Rhoban/microban/tools/motor_ids_assets/labels.png

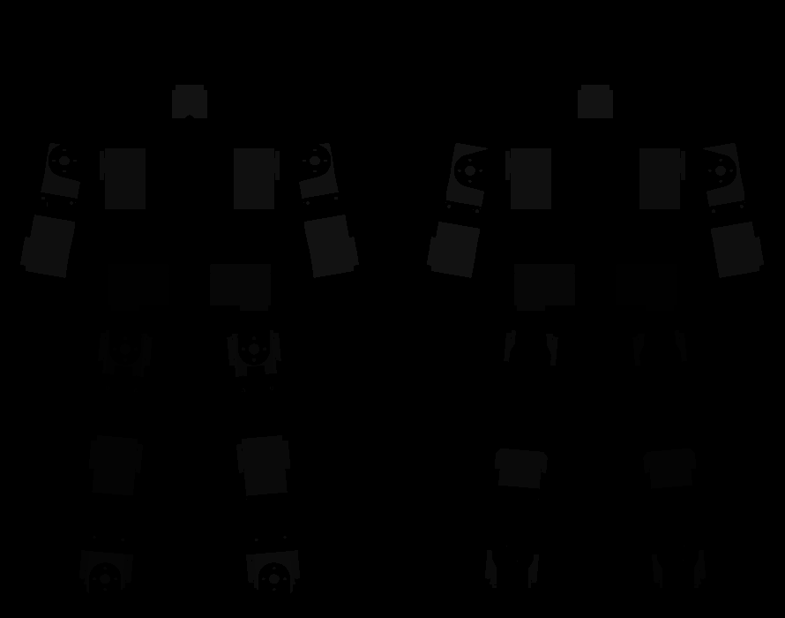
tools/motor_ids_assets/labels.png
