Rhoban/microban/tools/motor_ids_assets/views.png

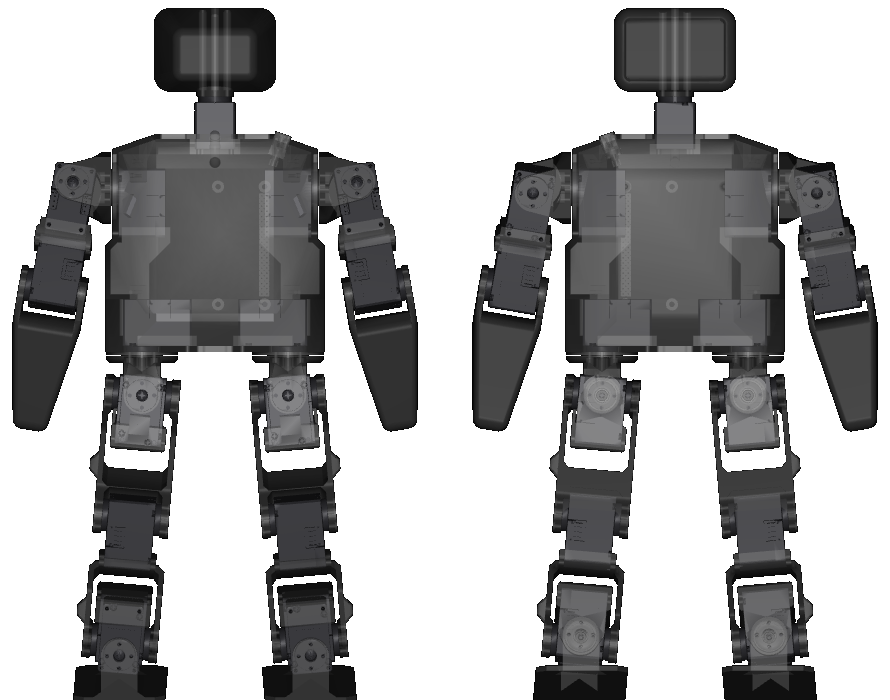
tools/motor_ids_assets/views.png
