Rhoban/microban/docs/bom.md

# Bill of Materials (BOM)

Here is a detailed Bill of Materials (BOM) for the project, including links to purchase each component and their approximate prices. Please note that prices may vary based on location and availability. You can source the components from your preferred suppliers, but beware that for electronic components using cheaper distributors may result in lower quality and reliability. 

Unlike the other components, the **[RPI Robot Hat](https://github.com/pollen-robotics/elec_RPI_Robot_HAT)** is not an off-the-shelf part: it is an open-source board that you need to have manufactured. Its design files are freely available on GitHub and can be ordered from any PCB fabrication service (e.g. JLCPCB, PCBWay, Aisler). The listed price is a rough estimate and will depend on the fab you choose and the quantity ordered. 

At the time of writing, **a Microban robot costs approximately $567**.

If you also include the configuration tools (Dynamixel U2D2 and U2D2 Power Hub), the total cost rises to approximately $623.

> [!WARNING]
> **Note regarding PCB Ordering with JLCPCB**
> 
> The default R33 resistor might currently be out of stock at JLCPCB, so double-check its presence during the preview step. If the default R33 is on shortage, you can easily swap it with another 150R 0402 resistor (e.g., part numbers `RT0402BRD07150RL` or `RCA02150RJLF`).
> 

## Robot Components

To build a complete Microban robot, you will need the following components:

| Component | Image | Quantity | Price | Link | Description / Notes |
| :--- | :---: | :---: | :--- | :--- | :--- |
| Battery Holder |  | 1 | ~$5.00 | [Amazon](https://www.amazon.fr/gp/product/B08YDTSML8/ref=sw_img_1?smid=A9DEKVHK1XMRT&th=1) | 2x18650 Battery Holder. |
| BMS |  | 1 | ~$10.00 | [Amazon](https://www.amazon.fr/gp/product/B0GJLGG7MM/ref=ewc_pr_img_1?smid=A263J3XHEW00G8&psc=1) | Battery Management System for 2x18650 batteries. |
| Switch |  | 1 | ~$5.00 | [Amazon](https://www.amazon.fr/gp/product/B0F32NVDHW/ref=ewc_pr_img_1?smid=A3PA4HG72LIUMJ&psc=1) | Power switch for the robot. |
| Charger |  | 1 | ~$10.00 | [Amazon](https://www.amazon.fr/gp/product/B0BWTK7SVN/ref=ox_sc_act_title_1?smid=A25R4KS2AL1P7J&psc=1) | Standard USB-C charger. |
| Batteries |  | 2 | ~$4.00 each | [Nkon](https://www.nkon.nl/fr/sony-murata-us18650-vtc6.html) | 18650 3.7V Lithium-ion Batteries. Murata VTC6 are recommended but not mandatory. |
| Raspberry Pi Zero 2W |  | 1 | ~$15.00 | [Raspberry Pi](https://www.raspberrypi.com/products/raspberry-pi-zero-2-w/) | Microcontroller for the robot. |
| RPI Robot Hat |  | 1 | ~$30.00 | [GitHub](https://github.com/pollen-robotics/elec_RPI_Robot_HAT) | Open-source custom hat for the Raspberry Pi Zero 2W. The design files are available on GitHub and can be manufactured by any PCB fabrication service. |
| 16GB+ micro SD card |  | 1 | ~$10.00 | [Amazon](https://www.amazon.fr/-/en/SanDisk-microSDHC-Adapter-Performance-SDSQUA4-032G-GN6MA/dp/B08GY9NYRM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) | Class 10 micro SD card of at least 16GB for OS and software. |
| Dynamixel XL330-M288-T |  | 19 | $23.90 each | [Robotis](https://en.robotis.com/shop_en/item.php?it_id=902-0163-000) | Servomotor with 1 motor, 1 180mm cable, 10 2.2x8 screws, 6 2x6 screws. |
| M2x6 STP39 Screws |  | 10 | ~$3 (depends on quantity) | [Screwerk](https://de.screwerk.com/fr/shop/detail/stp/STP390200060S.html) | Screws for the motor horns. Self-tapping screws for plastic. Complete the screws from motor kits. |
| Filament material |  | <1 | ~$10.00 | Depends on the 3D printer | To print the robot parts. Less than one roll. |
| 20x30x1mm POM shims |  | 4 | ~$2.50 for 20 | [AliExpress](https://fr.aliexpress.com/item/1005006482475865.html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) | POM washers used as plain bearings. Alternative to needle bearings for motors without idler horns. |
| 25x30x0.3mm Steel shims |  | 8 | ~$1.75 for 10 | [AliExpress](https://fr.aliexpress.com/item/1005001878233881.html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) | Parts on which the POM shim rests. |
| M2.5x6 Screws |  | 18 | ~$3 (depends on quantity) | [Screwerk](https://de.screwerk.com/fr/shop/detail/stm/STM320200060S.html) | Standard M2.5x6 screws to attach the idle horns to the motors. Any standard should work. |

**Important Note:** The total number of M2x6 screws contained in 19 motor kits is 114, while the number of M2x6 screws required for the assembly is 124. If you buy more than 19 motors, you will have enough screws for the assembly. If you buy exactly 19 motors, you will need to buy 10 additional M2x6 screws. I personally recommend buying some additional M2x6 screws to avoid any issues during assembly. I also recommend buying M2.2x8 for the motor fixation, as the M2x8 screws provided with the motors may not fit perfectly, although they are usable. Check the [Optional Components](#optional-components) section for more details.

## Configuration Tools

In addition to the components that make up the robot, you will also need configuration tools to set up the Dynamixel motors:

| Component | Quantity | Price | Link | Description / Notes |
| :--- | :---: | :--- | :--- | :--- |
| Dynamixel U2D2 | 1 | $32.10 | [Robotis](https://en.robotis.com/shop_en/item.php?it_id=902-0132-000) | USB to Dynamixel adapter for motor configuration. |
| Dynamixel U2D2 Power Hub | 1 | $19.00 | [Robotis](https://en.robotis.com/shop_en/item.php?it_id=902-0145-001) | Power hub for U2D2. |
| 5V DC Power Supply | 1 | ~$5.00 | [AliExpress](https://fr.aliexpress.com/item/1005006681380264.html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) | 5V DC power supply for U2D2 Power Hub. Does not require a lot of current, it is only needed for the initial configuration. |

In case of building several robots, it is not necessary to buy several U2D2 sets, as they are only required for the initial configuration of the motors. 

## Optional Components

As discussed in the [Robot Components](#robot-components) section, I personally recommend replacing the provided M2x8 screws by M2.2x8 screws. For your information, the total amount of M2x6 self-tapping screws required for the assembly is 124, they are used to fix the horns to the parts. The total amount of M2x8 / M2.2x8 self-tapping screws required for the assembly is 66, they are used to fix the motors to the parts. Having extra screws can also be useful in case of loss.

The number of cables provided with the motors should be sufficient for the robot, but you may need additional cables in case of damage. 
It is also preferable to adjust the cable lengths to the minimum required for the robot to avoid cable entanglement. It is possible to only use off-the-shelf cables of size 50mm (6), 100mm (4), and 180mm (9), but due to the lack of availability, it is preferable to crimp your own cables. To do so, you can buy SEH-001T-P0.6 crimp pins and adjust 180mm cables to the required lengths. Detailed instructions on how to crimp your own cables will be provided in the Assembly Guide.

Finally, if you plan to use Microban intensively, you may want to consider having additional batteries and a charger to avoid downtime during charging. 

For all these reasons, here are some optional components you may want to consider:

| Component | Quantity | Price | Link | Description / Notes |
| :--- | :---: | :--- | :--- | :--- |
| Screws STP39 2x6 | 100 | ~$30 (depends on quantity) | [Screwerk](https://de.screwerk.com/fr/shop/detail/stp/STP390200060S.html) | Optional self-tapping screws for horn to part attachment. |
| Screws STP39 2.2x8 | 100 | ~$30 (depends on quantity) | [Screwerk](https://de.screwerk.com/fr/shop/detail/stp/STP390220080B.html) | Optional screws self-tapping for motor to part attachment. |
| Additional cables | 10 | $19.00 | [Robotis](https://en.robotis.com/shop_en/item.php?it_id=903-0249-000) | X3P cables for motors. Can be made with JST EHR-3 connectors. |
| SEH-001T-P0.6 | 100 | ~$5 | [AliExpress](https://fr.aliexpress.com/item/1005005433081646.html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) | JST EH crimp pin of size 2.50mm in roll. Compatible with JST EHR-3 connectors. |
| Crimp tool | 1 | ~$12 | [AliExpress](https://fr.aliexpress.com/item/1005003429462091.html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) | Crimping tool. Should contain a 1.9mm die for the SEH-001T-P0.6 crimp pin. |
| Additional batteries | 1 | ~$4 | [Nkon](https://www.nkon.nl/fr/sony-murata-us18650-vtc6.html) | 18650 3.7V Lithium-ion Batteries. Murata VTC6 are recommended but not mandatory. |
| 18650 Li-ion charger | 1 | ~$15 | [RS](https://fr.rs-online.com/web/p/chargeurs-de-batterie/1466770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) | Charger for 18650 Li-ion batteries. |

---

Once you have all the components, you can proceed to print the parts. Follow the [Printing Guide](printing.md) for detailed instructions.

If you already have the parts printed and the components purchased, you can directly proceed to the assembly of the robot by following the [Assembly Guide](assembly.md).
