Rhoban/microban/src/model/mjcf/assets/tt_main.stl

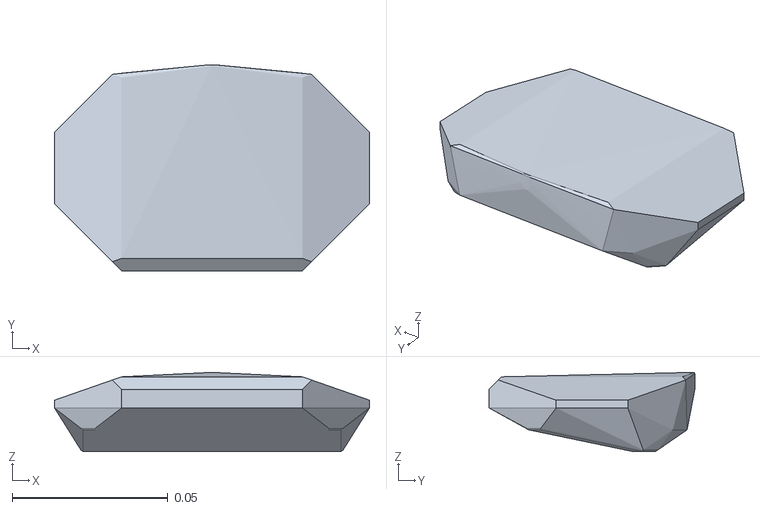
[picture p7: CAD file, 2026-10-27]
src/model/mjcf/assets/tt_main.stl
0.101 x 0.066 x 0.0254
