Rhoban/microban/cad/step/board_spacer.step

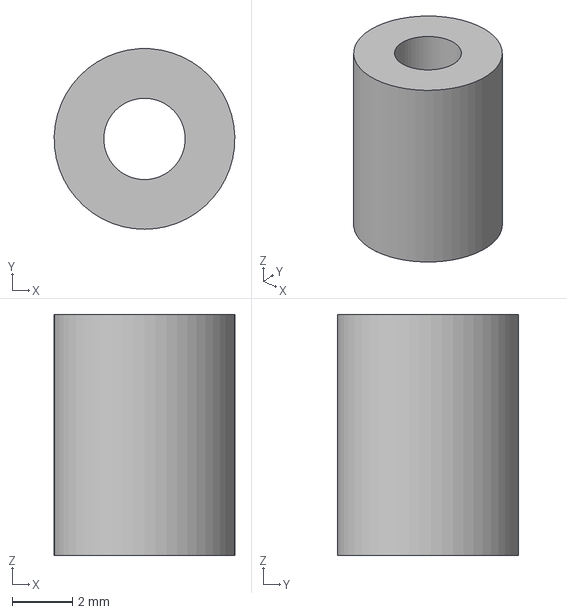
[picture p8: CAD file, 2026-07-21]
cad/step/board_spacer.step
6.00 x 5.99 x 8.00 mm
