Rhoban/microban/model/mjcf/assets/chest__configuration_right.stl

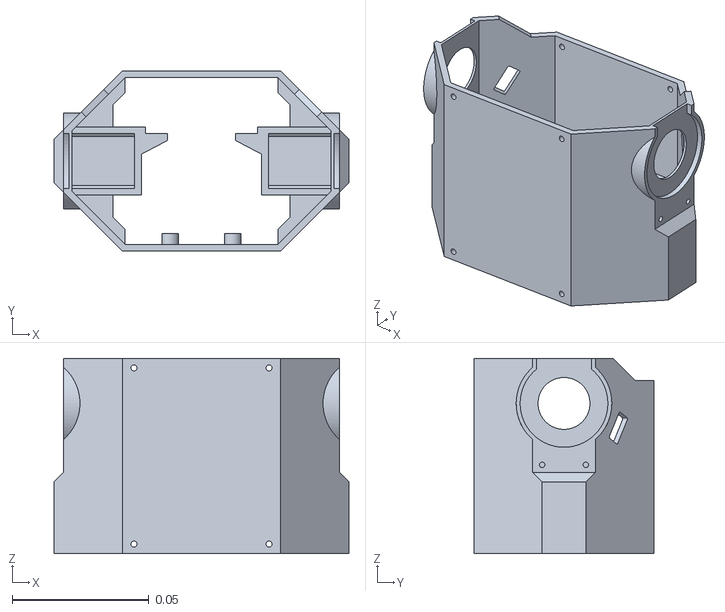
[picture p9: CAD file, 2026-05-28]
model/mjcf/assets/chest__configuration_right.stl
0.108 x 0.066 x 0.0715
