Rhoban/microban/src/model/mjcf/assets/femur__configuration_left.stl

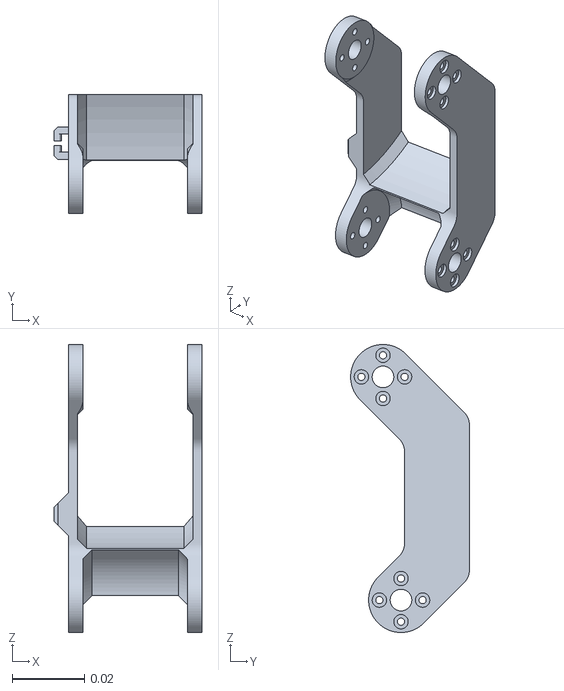
[picture p10: CAD file, 2026-10-27]
src/model/mjcf/assets/femur__configuration_left.stl
0.041 x 0.033 x 0.08
