Rhoban/microban/STEP/foot.step

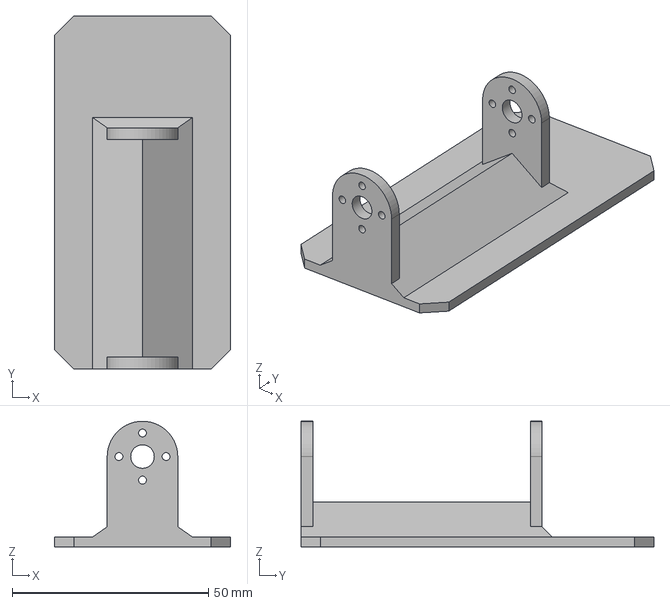
[picture p11: CAD file, 2026-05-08]
STEP/foot.step
45.0 x 90.0 x 32.0 mm
