Rhoban/microban/model/mjcf/assets/dc15_a01_horn_idle2_dummy.stl

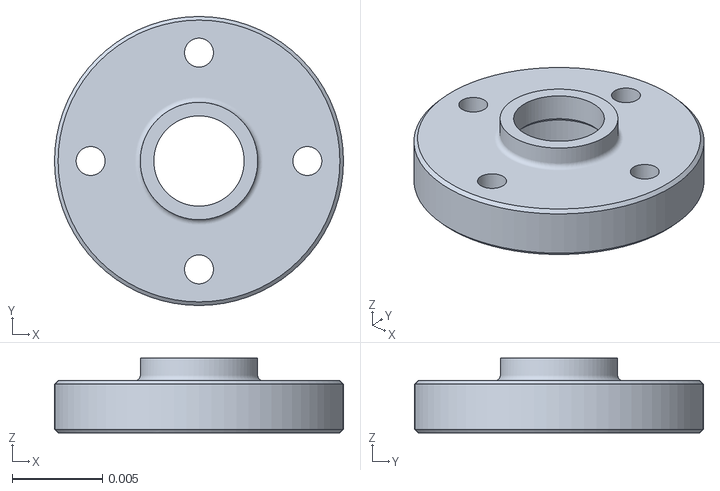
[picture p12: CAD file, 2026-05-28]
model/mjcf/assets/dc15_a01_horn_idle2_dummy.stl
0.016 x 0.016 x 0.00415
