Rhoban/microban/src/model/mjcf/assets/tibia__configuration_right.stl

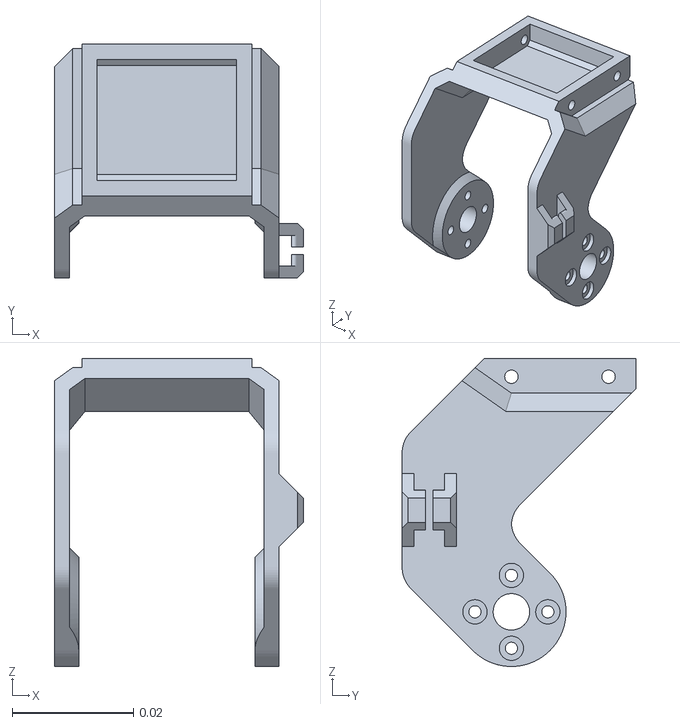
[picture p13: CAD file, 2026-10-27]
src/model/mjcf/assets/tibia__configuration_right.stl
0.041 x 0.0385 x 0.0507
