Rhoban/microban/src/model/mjcf/assets/part_1.stl

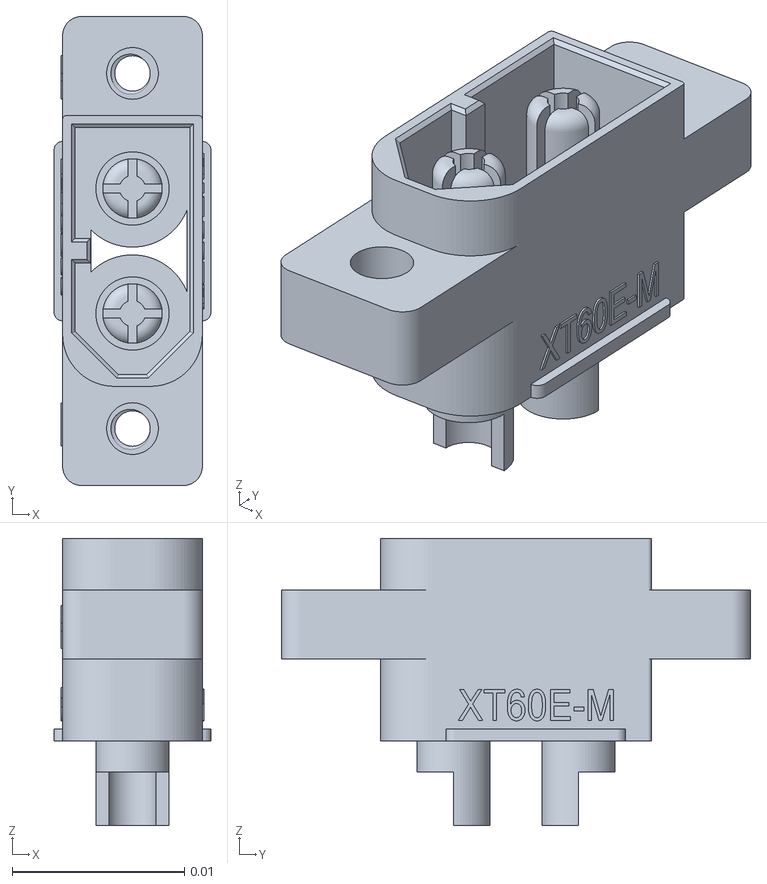
[picture p14: CAD file, 2026-10-27]
src/model/mjcf/assets/part_1.stl
0.0091 x 0.0272 x 0.0167
