Rhoban/microban/model/mjcf/assets/head__configuration_right.stl

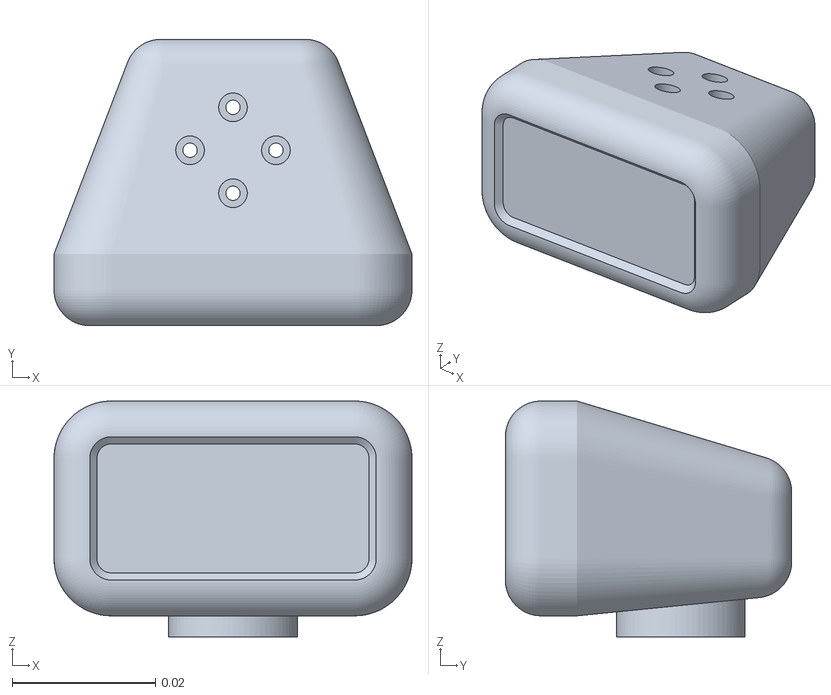
[picture p15: CAD file, 2026-05-28]
model/mjcf/assets/head__configuration_right.stl
0.05 x 0.04 x 0.0329
