Rhoban/microban/src/model/mjcf/assets/radius_mirrored.stl

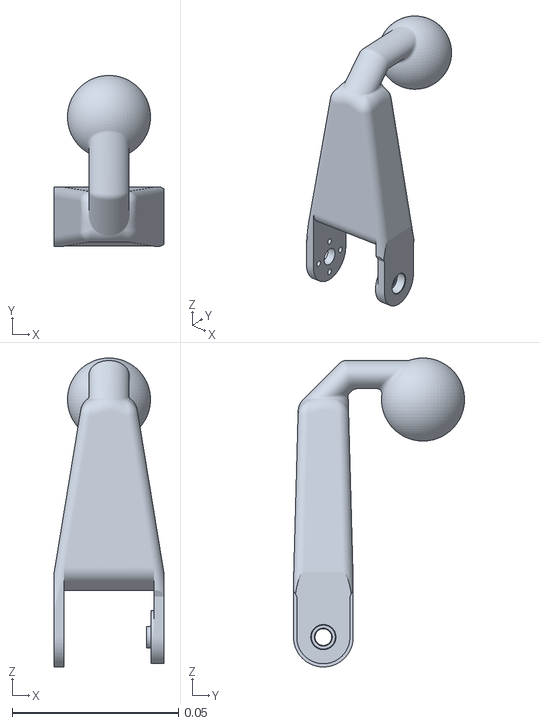
[picture p16: CAD file, 2026-10-27]
src/model/mjcf/assets/radius_mirrored.stl
0.033 x 0.0515 x 0.093
