Rhoban/microban/model/mjcf/assets/pelvis__configuration_right.stl

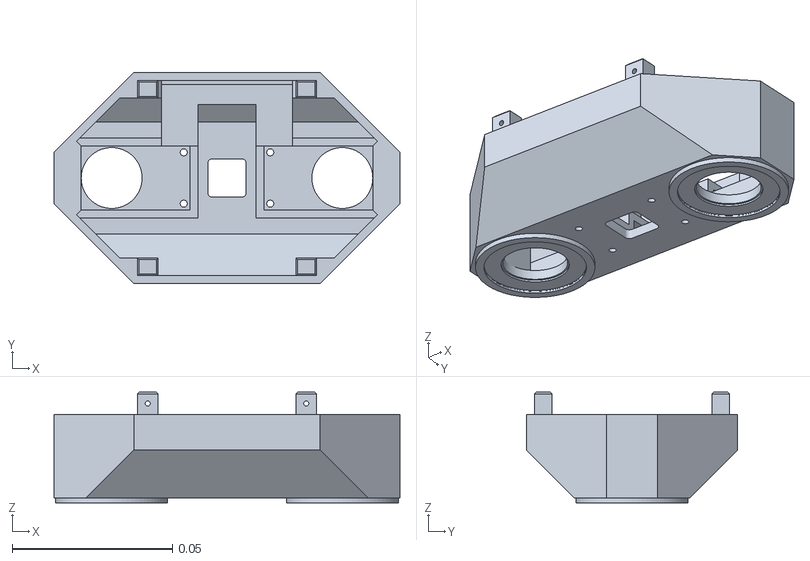
[picture p17: CAD file, 2026-05-28]
model/mjcf/assets/pelvis__configuration_right.stl
0.108 x 0.066 x 0.0345
