Rhoban/microban/src/model/mjcf/assets/coll_tibia__configuration_left_02.stl

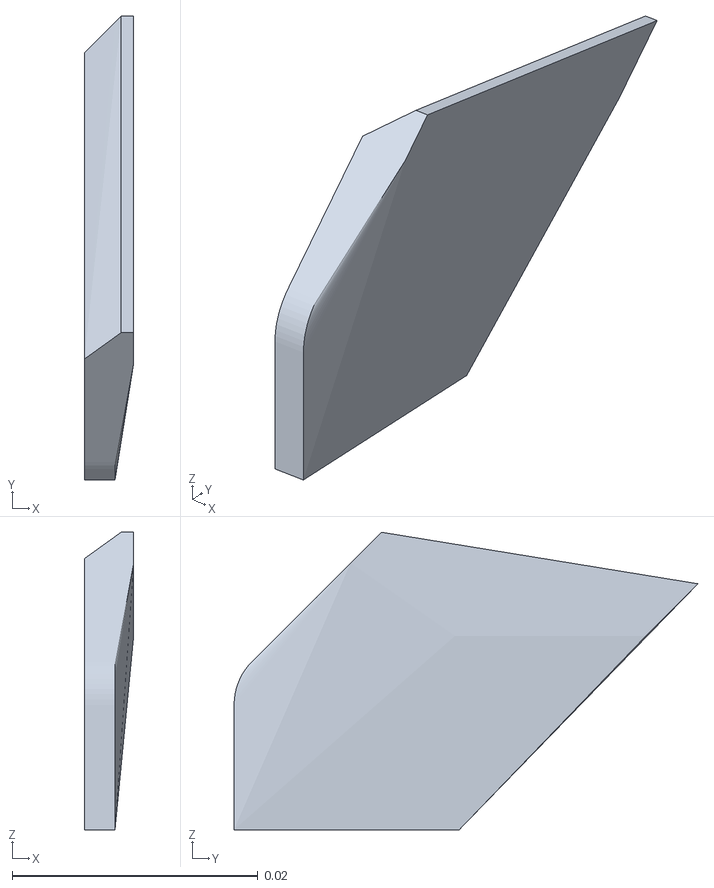
[picture p18: CAD file, 2026-10-27]
src/model/mjcf/assets/coll_tibia__configuration_left_02.stl
0.00402 x 0.0378 x 0.0242
