Rhoban/microban/model/mjcf/assets/battery.stl

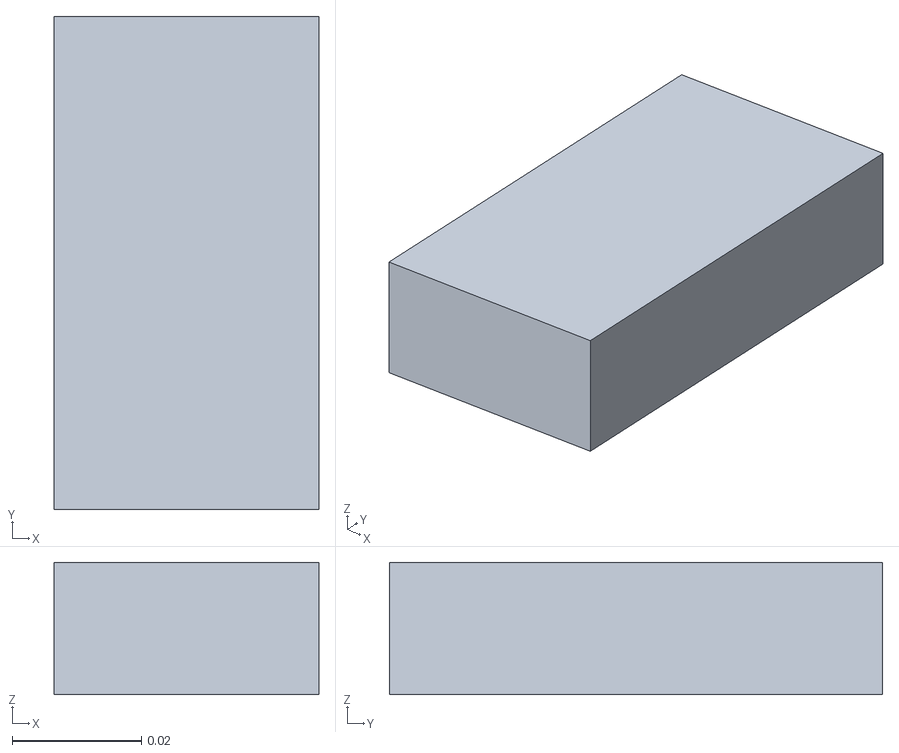
[picture p19: CAD file, 2026-05-28]
model/mjcf/assets/battery.stl
0.041 x 0.0763 x 0.0205
