Rhoban/microban/src/model/mjcf/assets/coll_hip_dbl_block__configuration_right_04.stl

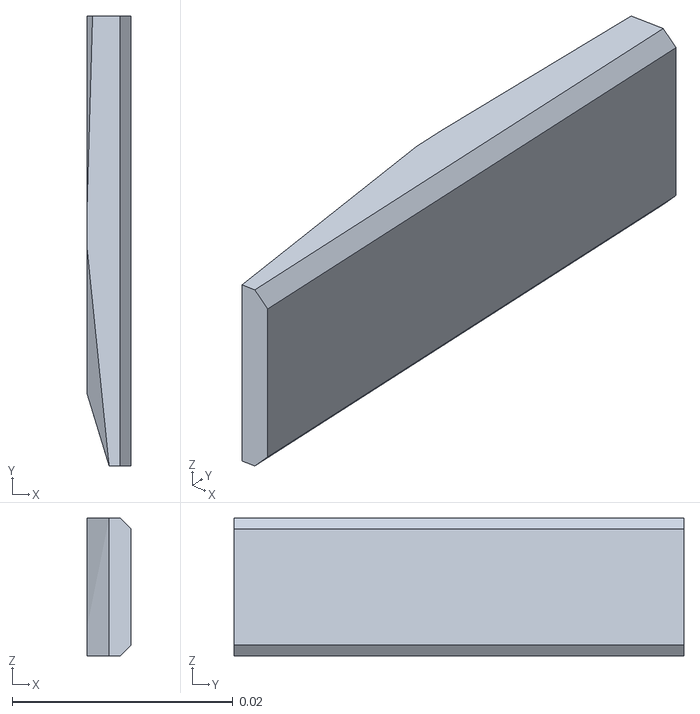
[picture p20: CAD file, 2026-10-27]
src/model/mjcf/assets/coll_hip_dbl_block__configuration_right_04.stl
0.00402 x 0.0408 x 0.0125
