Rhoban/microban/model/mjcf/assets/hip_dbl_block__configuration_left.stl

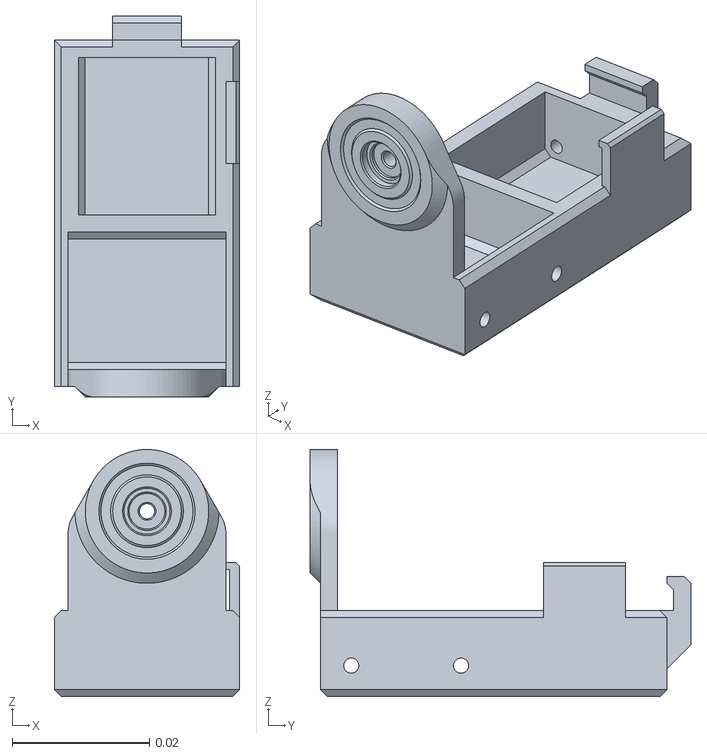
[picture p21: CAD file, 2026-05-28]
model/mjcf/assets/hip_dbl_block__configuration_left.stl
0.027 x 0.0555 x 0.036
