Rhoban/microban/src/model/mjcf/assets/coll_shoulder_09.stl

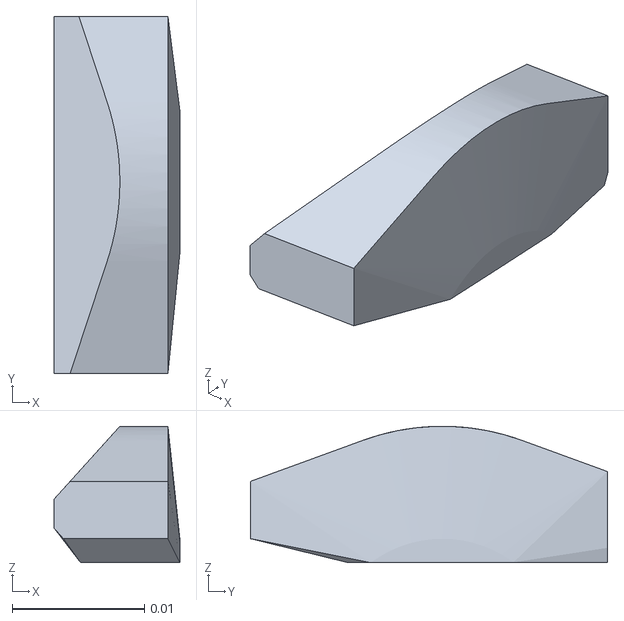
[picture p22: CAD file, 2026-10-27]
src/model/mjcf/assets/coll_shoulder_09.stl
0.0095 x 0.027 x 0.0103
