Rhoban/microban/src/model/mjcf/assets/coll_femur__configuration_left_07.stl

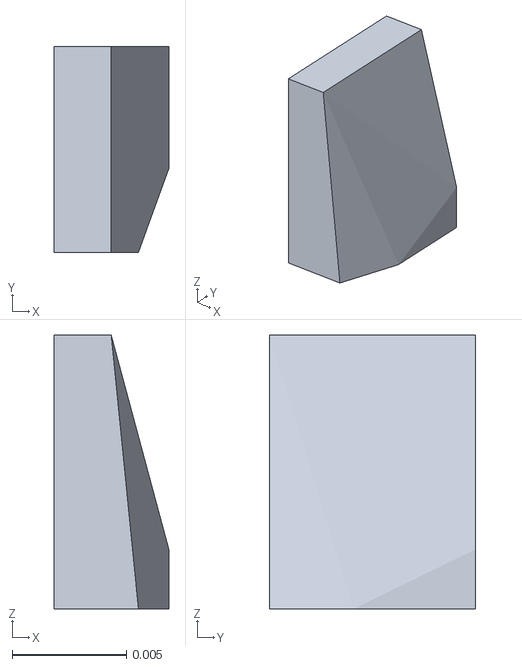
[picture p23: CAD file, 2026-10-27]
src/model/mjcf/assets/coll_femur__configuration_left_07.stl
0.00502 x 0.009 x 0.012
