Rhoban/microban/model/mjcf/assets/dc15_a01_idle_cap_dummy.stl

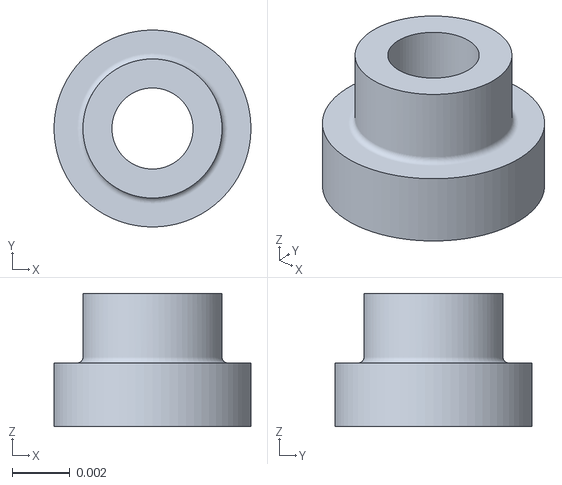
[picture p24: CAD file, 2026-05-28]
model/mjcf/assets/dc15_a01_idle_cap_dummy.stl
0.0068 x 0.0068 x 0.0046
