Rhoban/microban/src/model/mjcf/assets/coll_spacer__configuration_right_01.stl

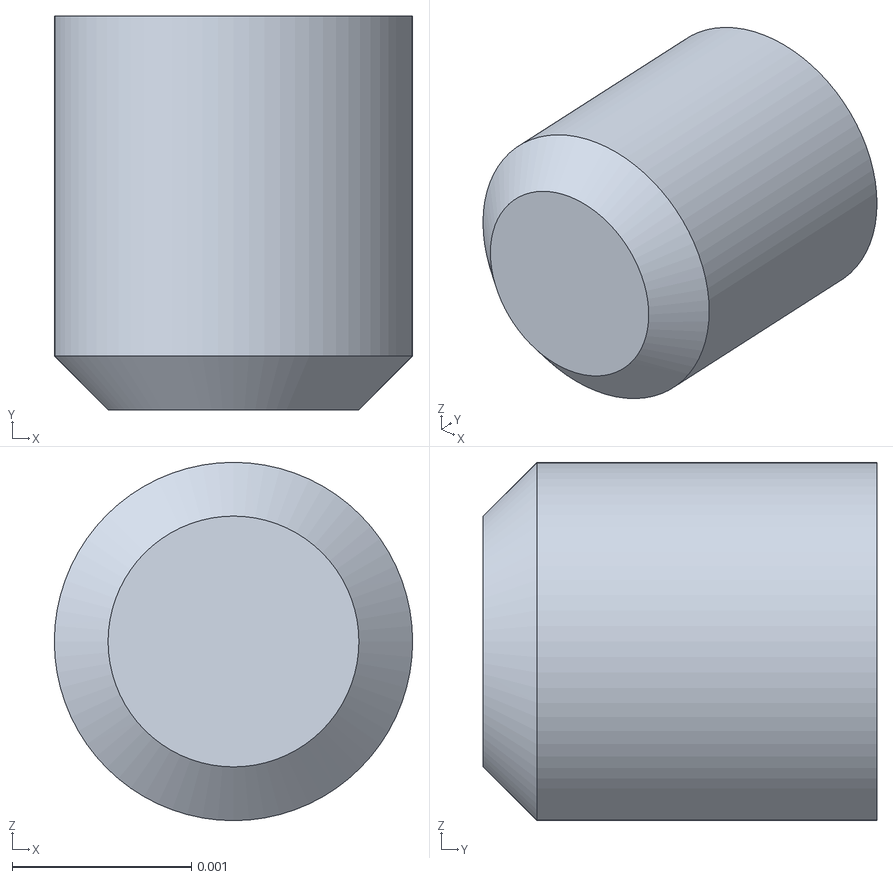
[picture p25: CAD file, 2026-10-27]
src/model/mjcf/assets/coll_spacer__configuration_right_01.stl
0.002 x 0.0022 x 0.002
