Rhoban/microban/model/mjcf/assets/hip__configuration_right.stl

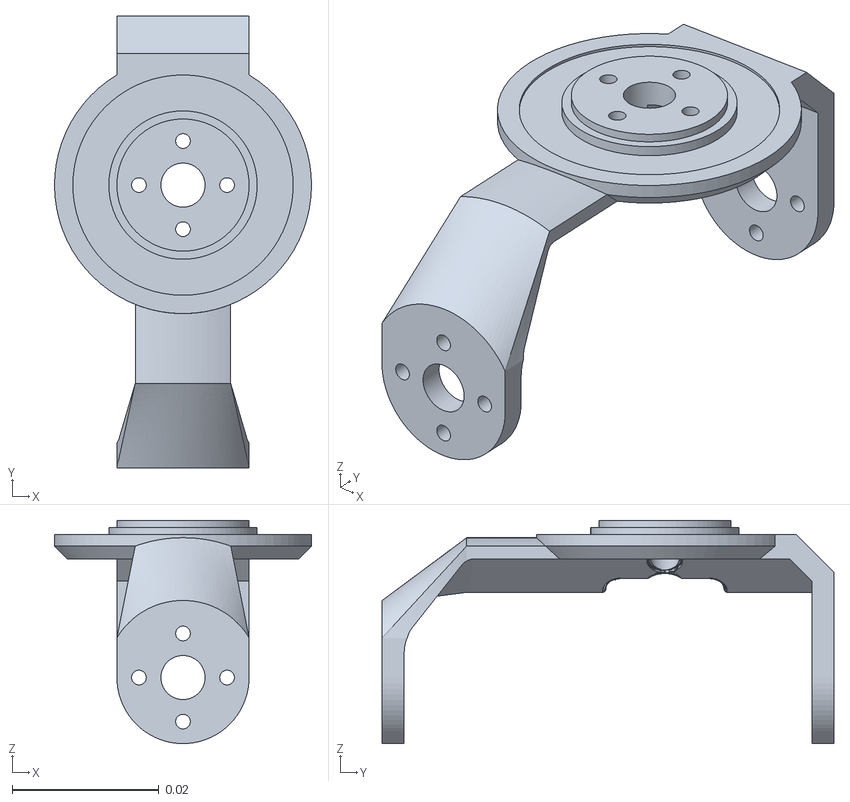
[picture p26: CAD file, 2026-05-28]
model/mjcf/assets/hip__configuration_right.stl
0.035 x 0.0615 x 0.0304
