Rhoban/microban/src/model/mjcf/assets/radius_05.stl

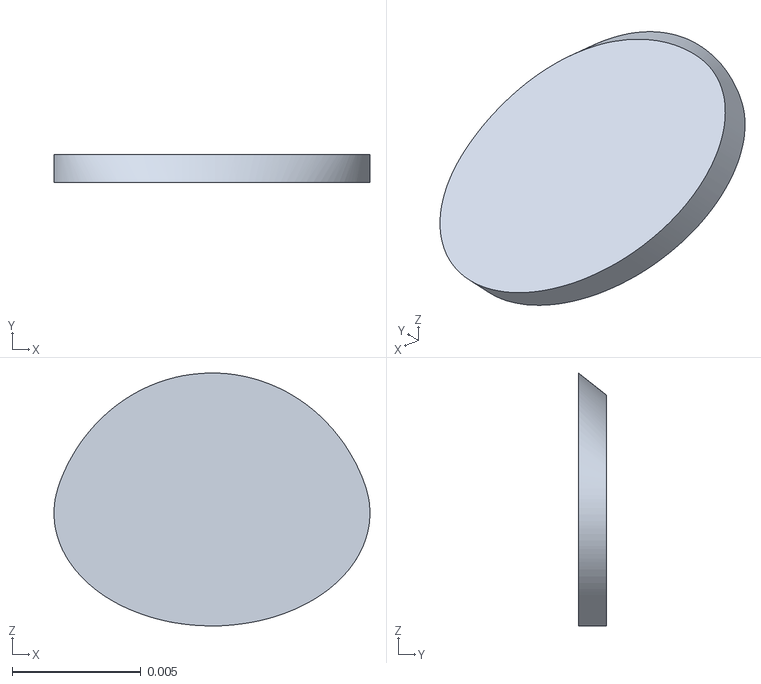
[picture p27: CAD file, 2026-10-27]
src/model/mjcf/assets/radius_05.stl
0.0123 x 0.00109 x 0.00982
