Rhoban/microban/src/model/mjcf/assets/coll_tibia__configuration_left_09.stl

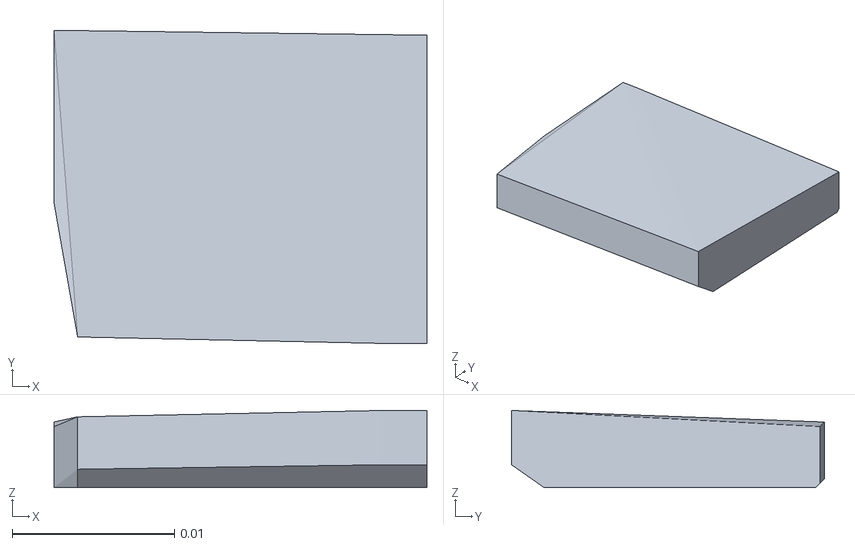
[picture p28: CAD file, 2026-10-27]
src/model/mjcf/assets/coll_tibia__configuration_left_09.stl
0.023 x 0.0193 x 0.00475
