Rhoban/microban/src/model/mjcf/assets/coll_ankle_dbl_block__configuration_right_08.stl

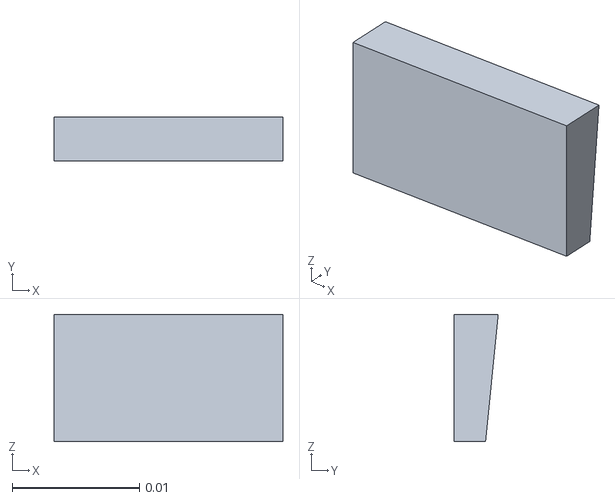
[picture p29: CAD file, 2026-10-27]
src/model/mjcf/assets/coll_ankle_dbl_block__configuration_right_08.stl
0.018 x 0.00349 x 0.00999
