Rhoban/microban/model/mjcf/assets/foot__configuration_right.stl

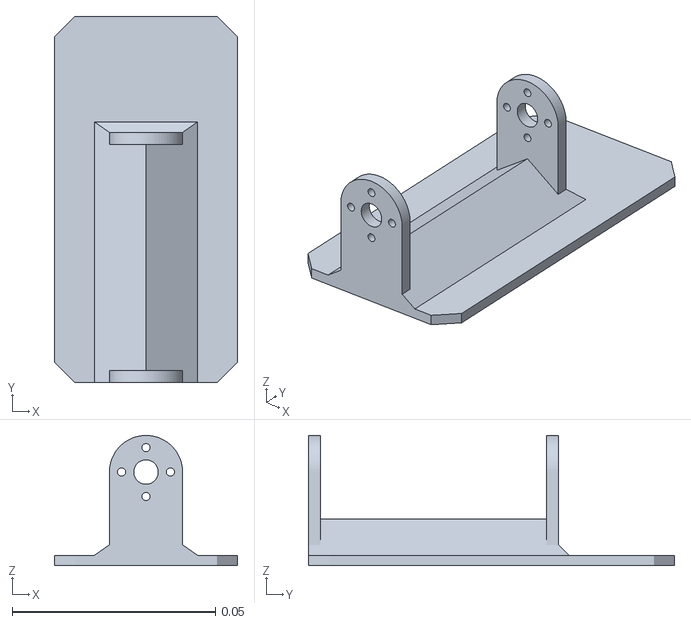
[picture p30: CAD file, 2026-05-28]
model/mjcf/assets/foot__configuration_right.stl
0.045 x 0.09 x 0.032
