Rhoban/microban/src/model/mjcf/assets/coll_hip__configuration_right_06.stl

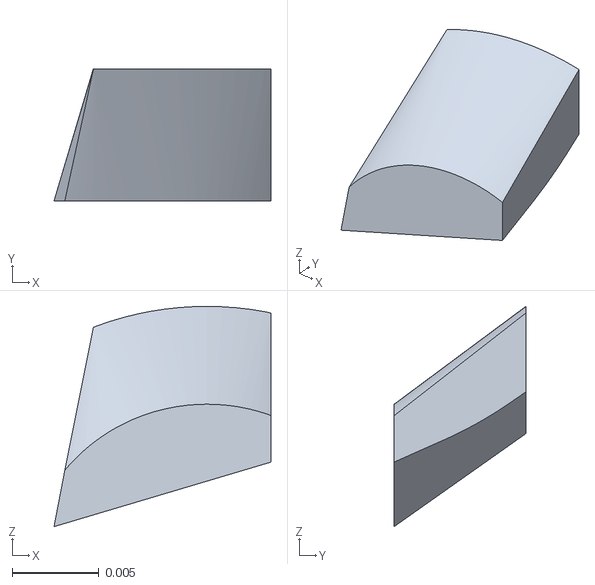
[picture p31: CAD file, 2026-10-27]
src/model/mjcf/assets/coll_hip__configuration_right_06.stl
0.0125 x 0.00759 x 0.0127
