Rhoban/microban/model/mjcf/assets/bts2_m2_6x8.stl

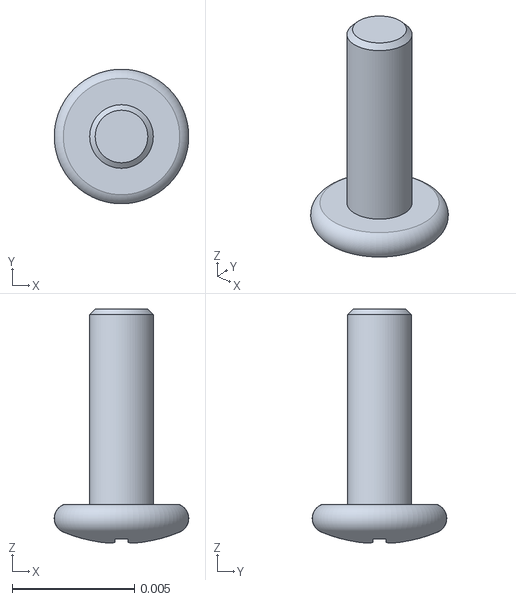
[picture p32: CAD file, 2026-05-28]
model/mjcf/assets/bts2_m2_6x8.stl
0.0055 x 0.0055 x 0.00957
