Rhoban/microban/model/mjcf/assets/xl330_without_horn.stl

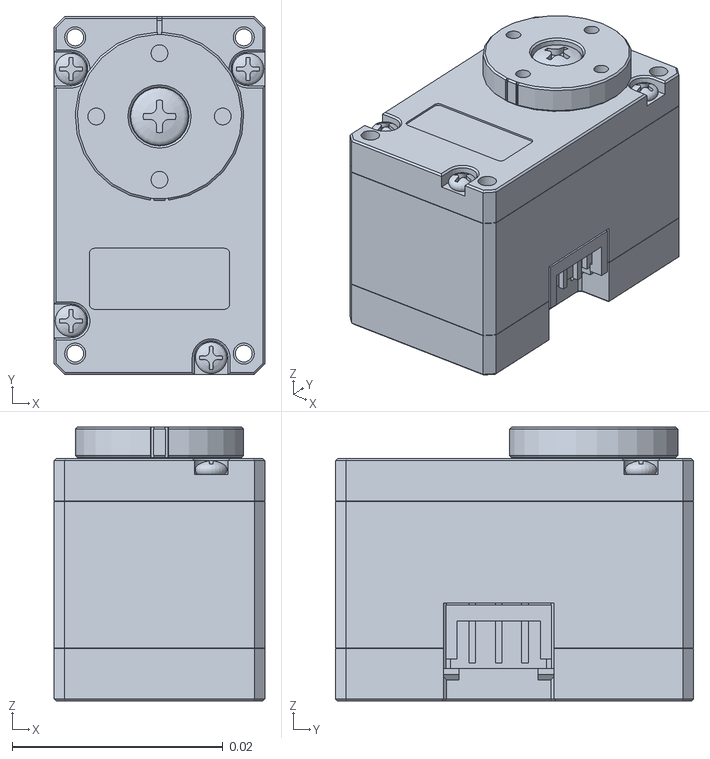
[picture p33: CAD file, 2026-05-28]
model/mjcf/assets/xl330_without_horn.stl
0.02 x 0.034 x 0.026
