Rhoban/microban/src/model/mjcf/assets/foot__configuration_right_17.stl

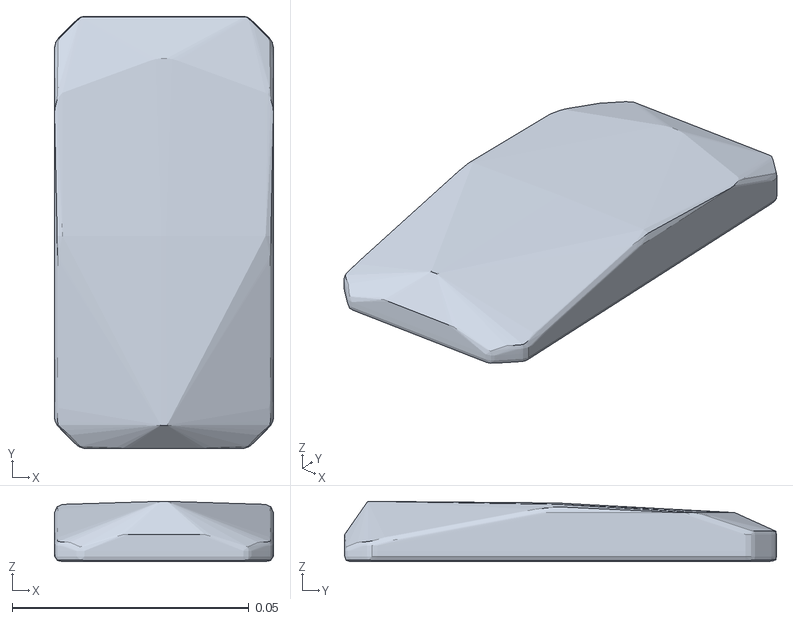
[picture p34: CAD file, 2026-10-27]
src/model/mjcf/assets/foot__configuration_right_17.stl
0.0463 x 0.0913 x 0.0127
