Rhoban/microban/model/mjcf/assets/xl330.stl

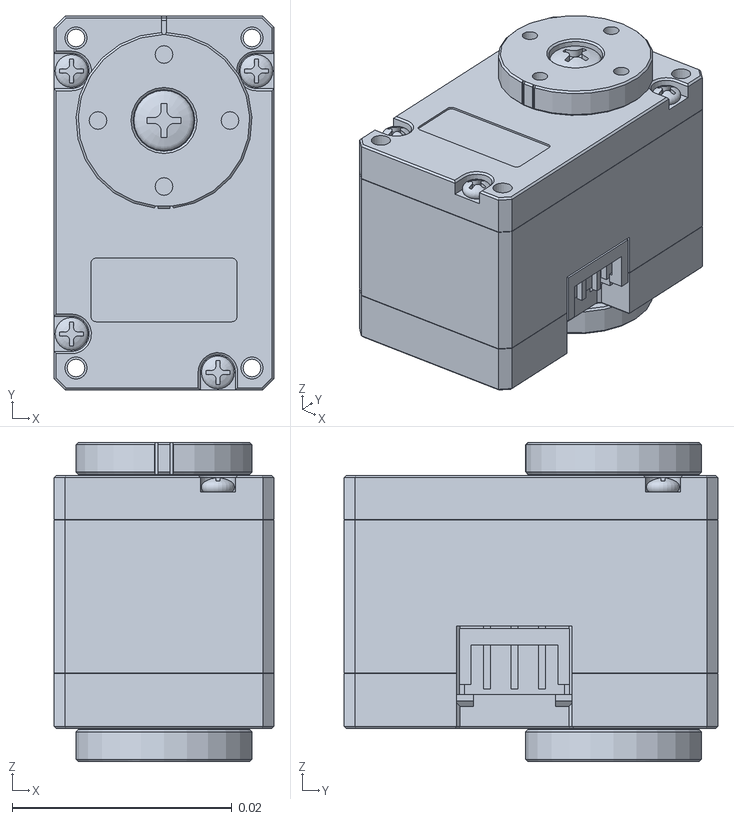
[picture p35: CAD file, 2026-05-28]
model/mjcf/assets/xl330.stl
0.02 x 0.034 x 0.029
