Rhoban/microban/src/model/mjcf/assets/spacer__configuration_right.stl

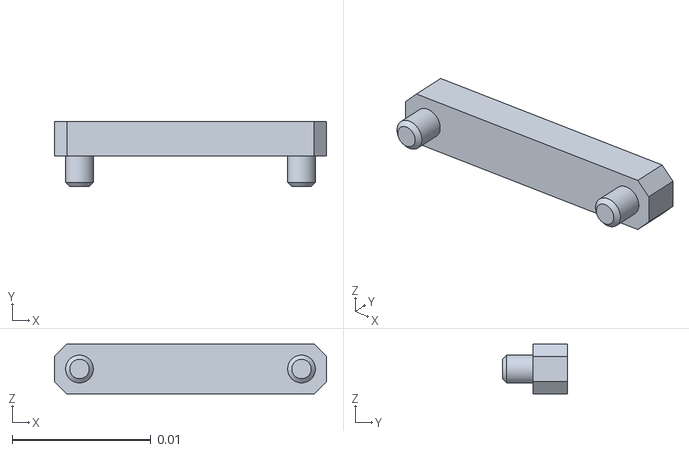
[picture p36: CAD file, 2026-10-27]
src/model/mjcf/assets/spacer__configuration_right.stl
0.0196 x 0.0047 x 0.0036
