Rhoban/microban/src/model/mjcf/assets/arm_bearing_support__configuration_right.stl

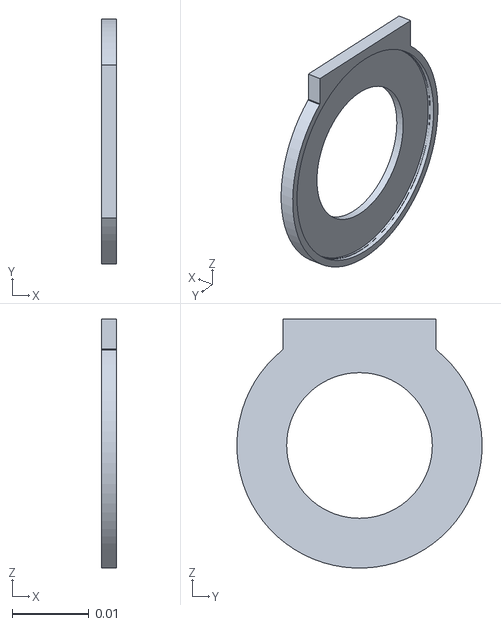
[picture p37: CAD file, 2026-10-27]
src/model/mjcf/assets/arm_bearing_support__configuration_right.stl
0.002 x 0.032 x 0.0325
