Rhoban/microban/model/mjcf/assets/shoulder.stl

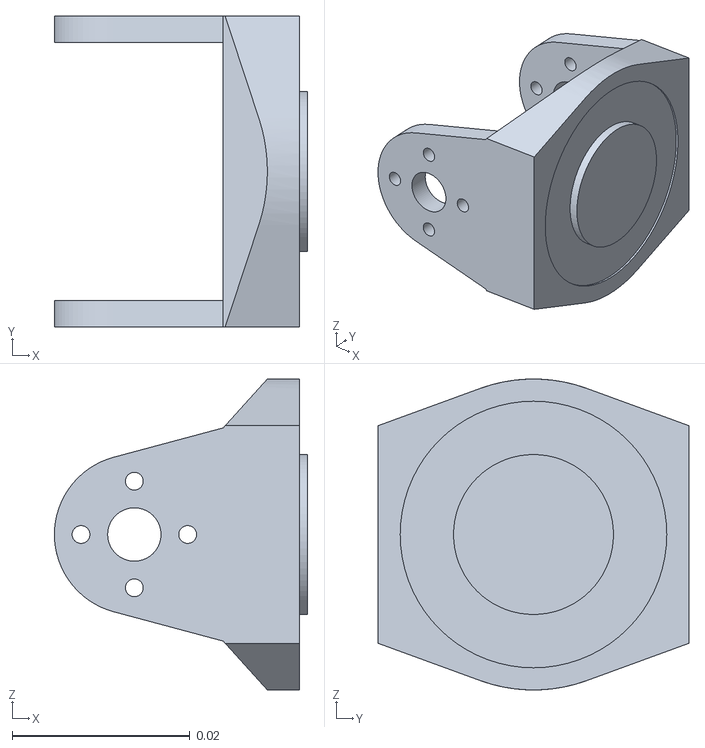
[picture p38: CAD file, 2026-05-28]
model/mjcf/assets/shoulder.stl
0.0285 x 0.035 x 0.035
