Rhoban/microban/src/model/mjcf/assets/coll_hip__configuration_right_01.stl

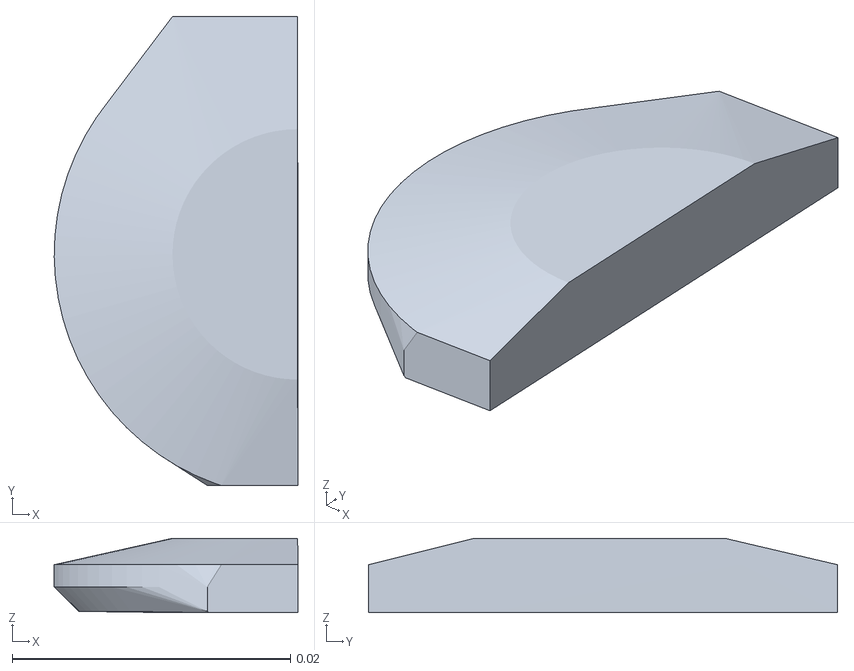
[picture p39: CAD file, 2026-10-27]
src/model/mjcf/assets/coll_hip__configuration_right_01.stl
0.0175 x 0.0337 x 0.00535
