Rhoban/microban/model/mjcf/assets/ankle_dbl_block__configuration_right.stl

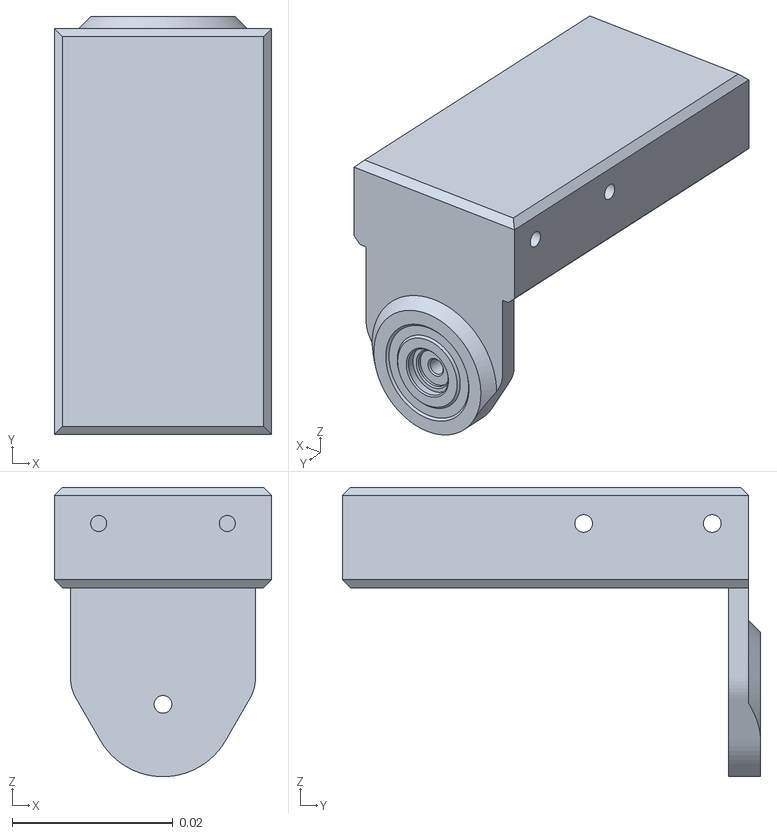
[picture p40: CAD file, 2026-05-28]
model/mjcf/assets/ankle_dbl_block__configuration_right.stl
0.027 x 0.052 x 0.036
