Rhoban/microban/model/mjcf/assets/humerus.stl

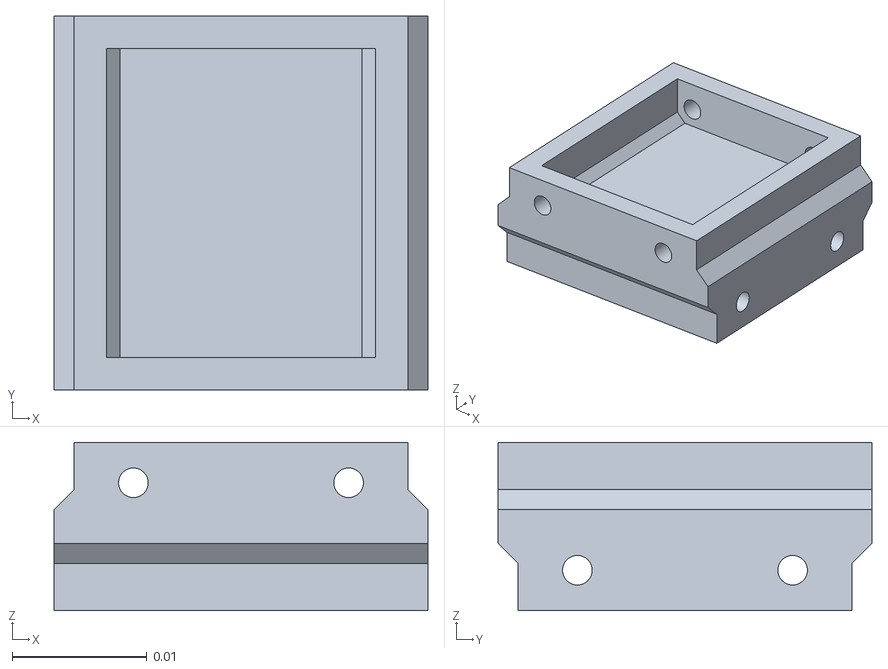
[picture p41: CAD file, 2026-05-28]
model/mjcf/assets/humerus.stl
0.0278 x 0.0278 x 0.0125
