Rhoban/microban/src/model/mjcf/assets/coll_tibia__configuration_left_00.stl

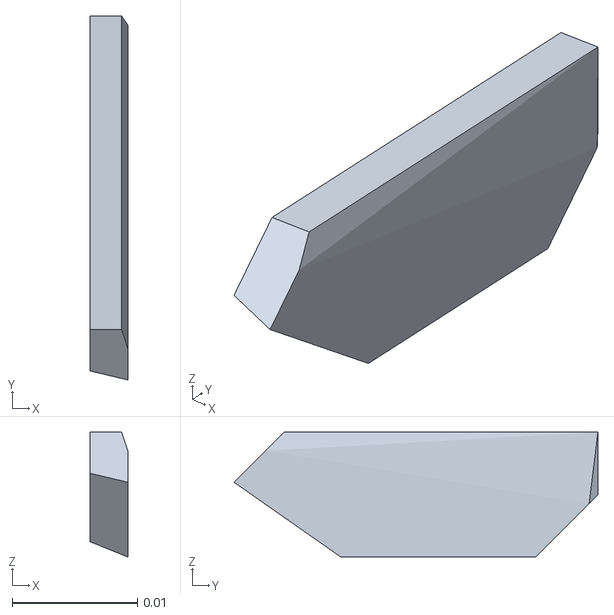
[picture p42: CAD file, 2026-10-27]
src/model/mjcf/assets/coll_tibia__configuration_left_00.stl
0.003 x 0.029 x 0.00996
