Rhoban/microban/model/mjcf/assets/switch.stl

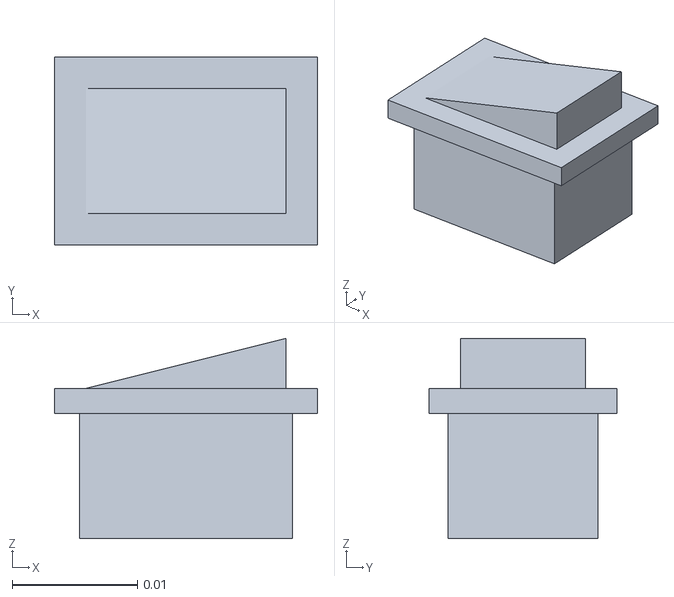
[picture p43: CAD file, 2026-05-28]
model/mjcf/assets/switch.stl
0.021 x 0.015 x 0.016
