Rhoban/microban/src/model/mjcf/assets/radius_08.stl

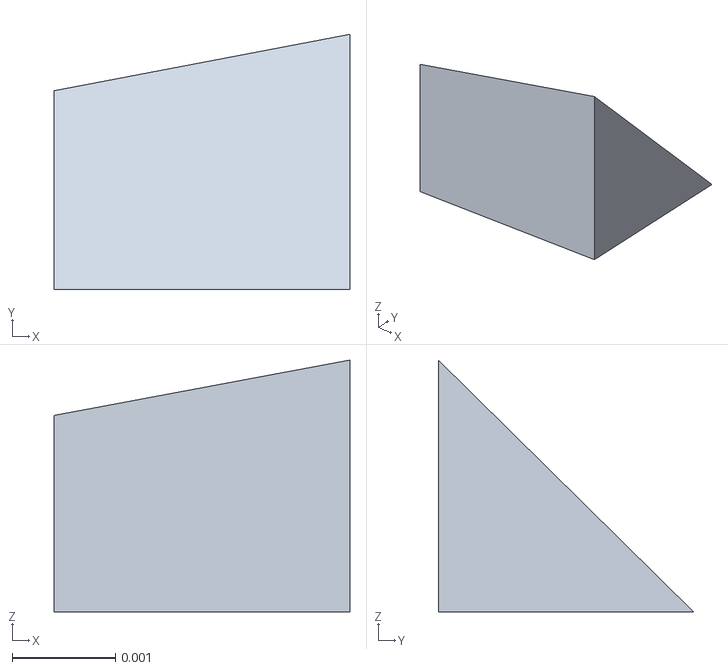
[picture p44: CAD file, 2026-10-27]
src/model/mjcf/assets/radius_08.stl
0.00287 x 0.00247 x 0.00244
