Rhoban/microban/src/model/mjcf/assets/coll_hip__configuration_right_07.stl

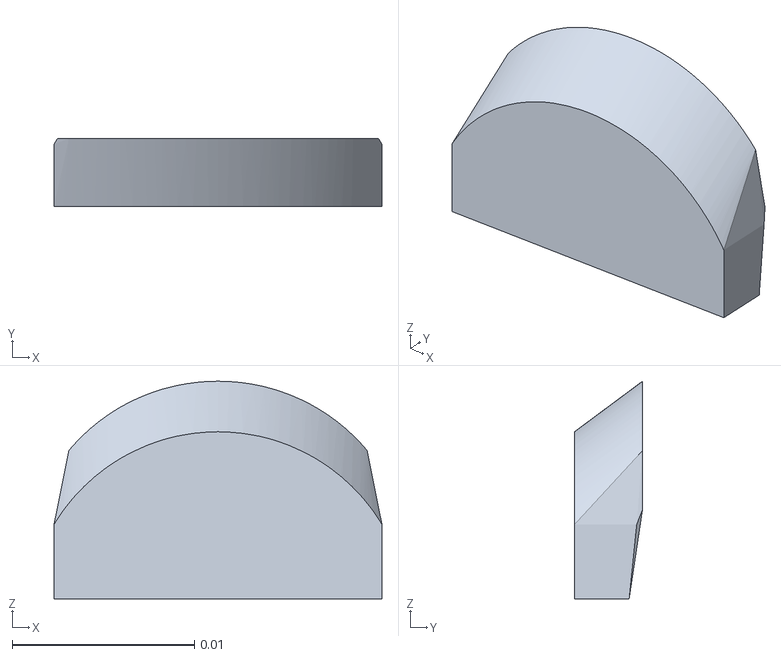
[picture p45: CAD file, 2026-10-27]
src/model/mjcf/assets/coll_hip__configuration_right_07.stl
0.018 x 0.00373 x 0.0119
