Rhoban/microban/model/mjcf/assets/radius.stl

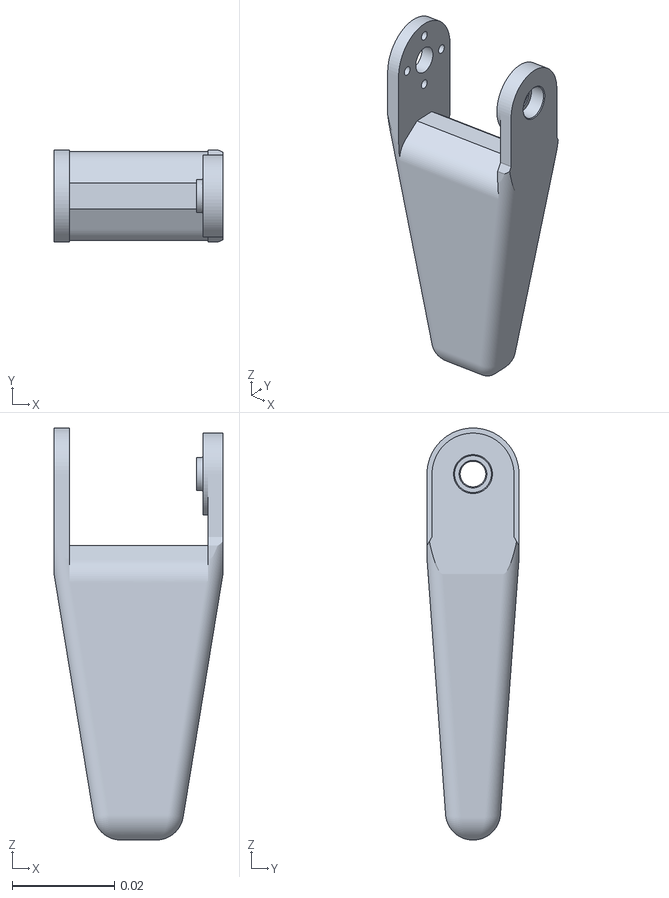
[picture p46: CAD file, 2026-05-28]
model/mjcf/assets/radius.stl
0.033 x 0.018 x 0.0805
