Rhoban/microban/src/model/mjcf/assets/coll_tibia__configuration_left_08.stl

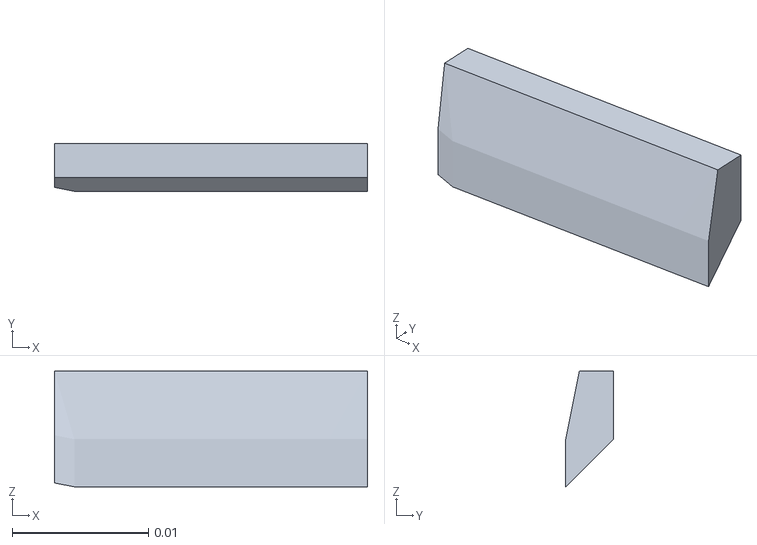
[picture p47: CAD file, 2026-10-27]
src/model/mjcf/assets/coll_tibia__configuration_left_08.stl
0.023 x 0.0035 x 0.0085
