Rhoban/microban/model/mjcf/assets/trunk_top__configuration_right.stl

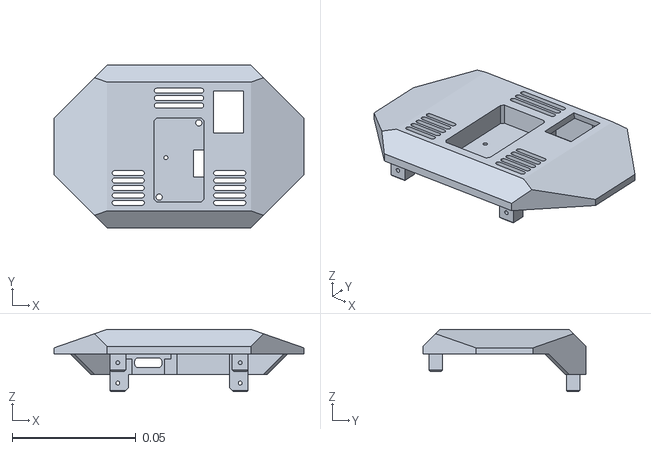
[picture p48: CAD file, 2026-05-28]
model/mjcf/assets/trunk_top__configuration_right.stl
0.101 x 0.066 x 0.0252
