Rhoban/microban/src/model/mjcf/assets/coll_hip_dbl_block__configuration_right_07.stl

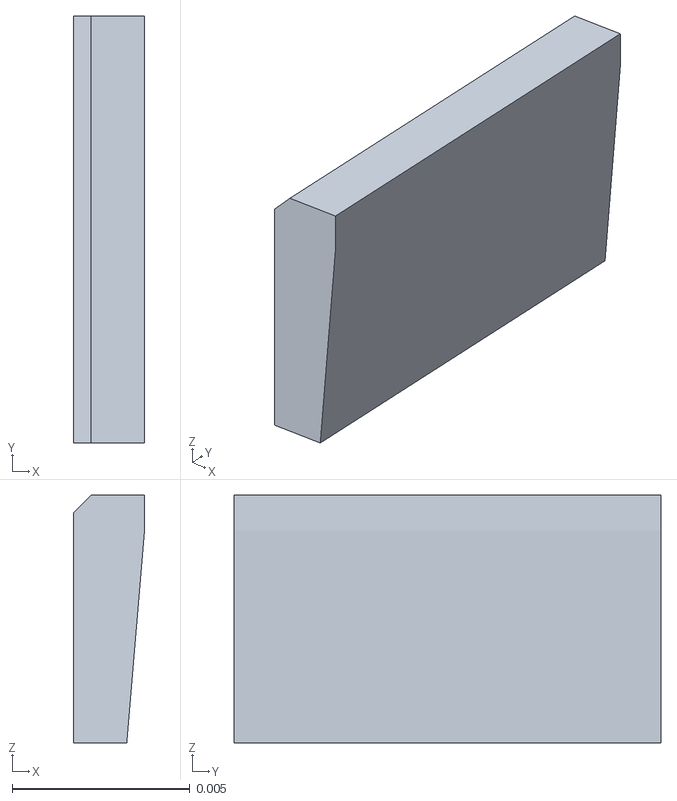
[picture p49: CAD file, 2026-10-27]
src/model/mjcf/assets/coll_hip_dbl_block__configuration_right_07.stl
0.002 x 0.012 x 0.00698
