Rhoban/microban/src/model/mjcf/assets/radius_mirrored_08.stl

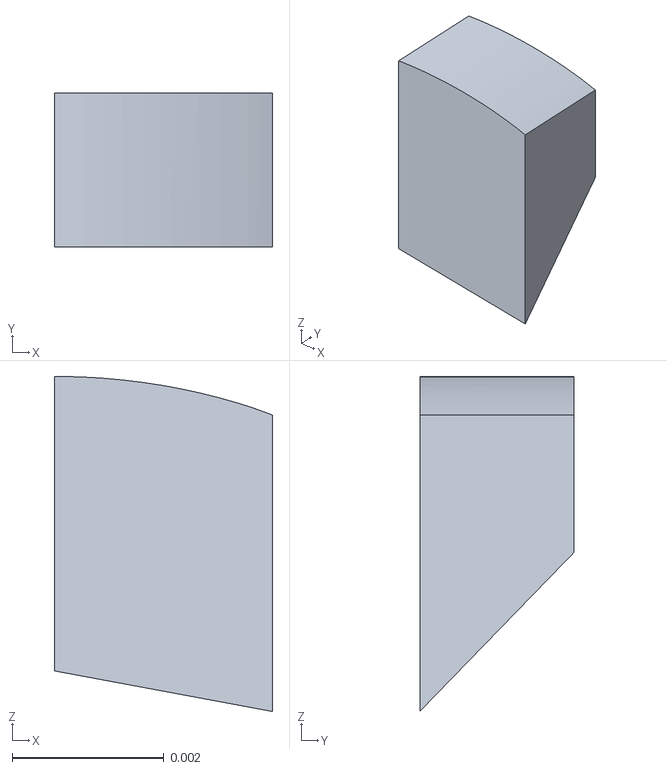
[picture p50: CAD file, 2026-10-27]
src/model/mjcf/assets/radius_mirrored_08.stl
0.00287 x 0.00204 x 0.00441
