Rhoban/microban/src/model/mjcf/assets/radius_04.stl

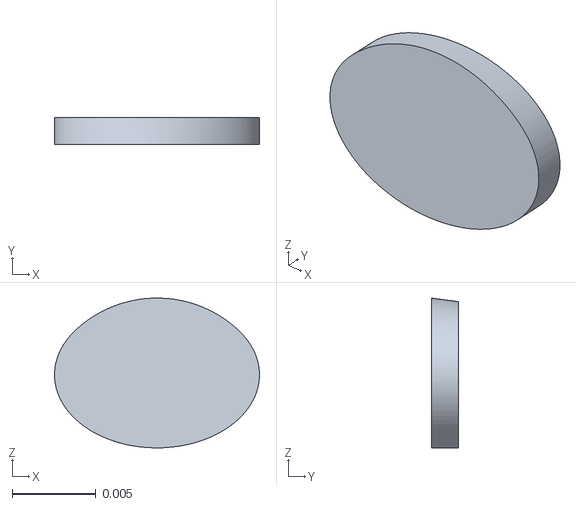
[picture p51: CAD file, 2026-10-27]
src/model/mjcf/assets/radius_04.stl
0.0123 x 0.0016 x 0.00897
