Rhoban/microban/src/model/mjcf/assets/radius_mirrored_16.stl

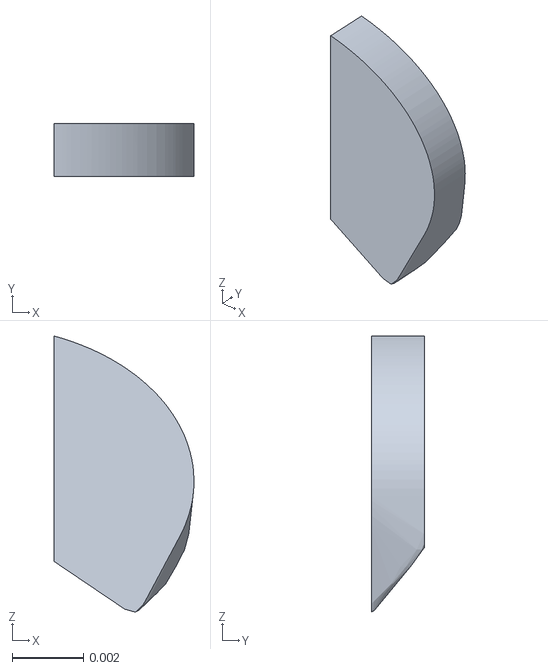
[picture p52: CAD file, 2026-10-27]
src/model/mjcf/assets/radius_mirrored_16.stl
0.00394 x 0.0015 x 0.00777
