Rhoban/microban/src/model/mjcf/assets/radius_17.stl

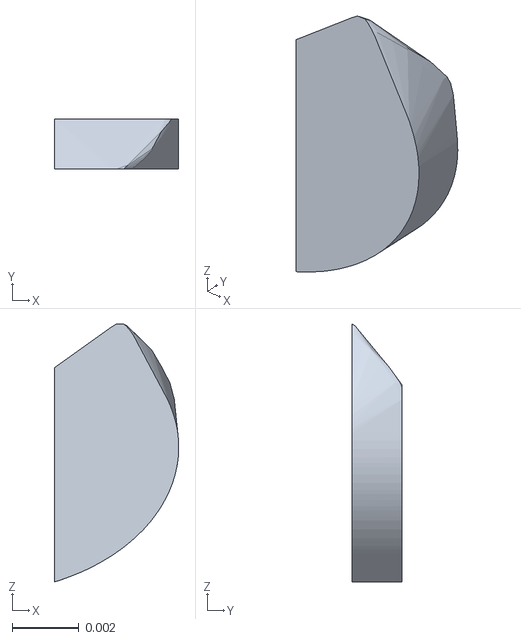
[picture p53: CAD file, 2026-10-27]
src/model/mjcf/assets/radius_17.stl
0.00372 x 0.00151 x 0.00771
