Rhoban/microban/src/model/mjcf/assets/coll_arm_bearing_support__configuration_right_10.stl

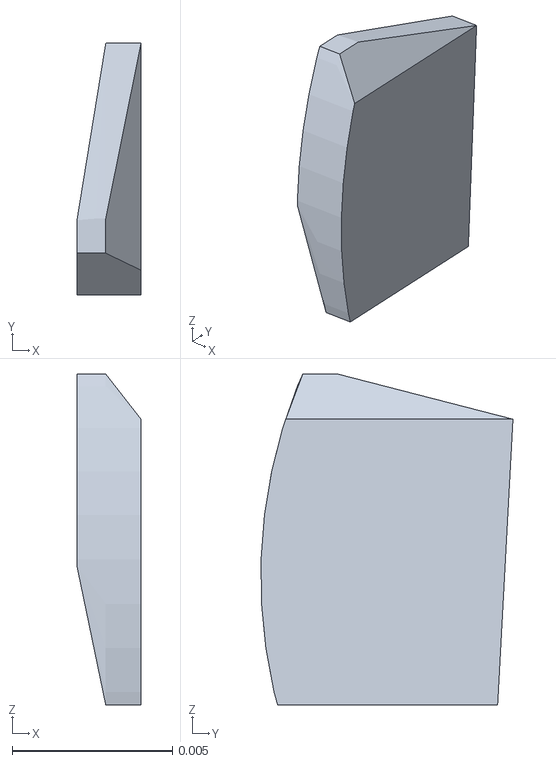
[picture p54: CAD file, 2026-10-27]
src/model/mjcf/assets/coll_arm_bearing_support__configuration_right_10.stl
0.002 x 0.00786 x 0.0103
