Rhoban/microban/src/model/mjcf/assets/coll_tibia__configuration_right_10.stl

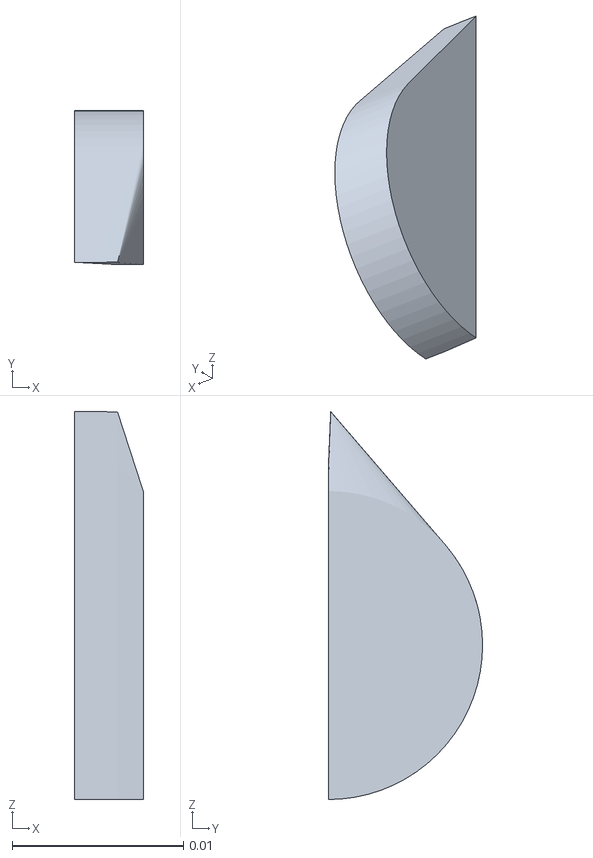
[picture p55: CAD file, 2026-10-27]
src/model/mjcf/assets/coll_tibia__configuration_right_10.stl
0.004 x 0.00899 x 0.0226
