Rhoban/microban/src/model/mjcf/assets/coll_tibia__configuration_right_11.stl

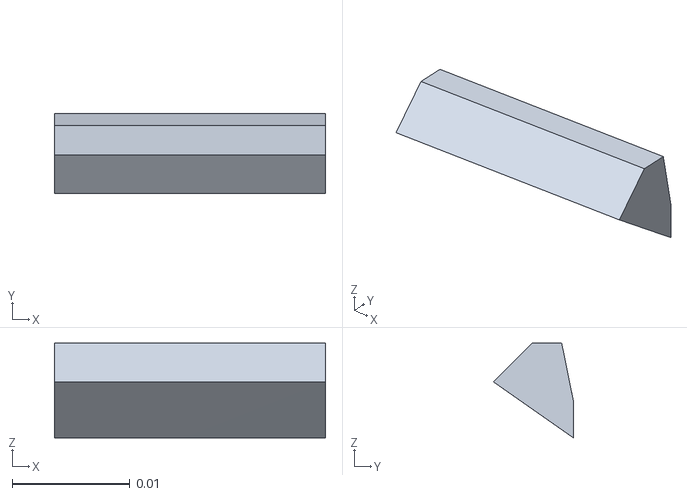
[picture p56: CAD file, 2026-10-27]
src/model/mjcf/assets/coll_tibia__configuration_right_11.stl
0.023 x 0.00681 x 0.00806
