Rhoban/microban/src/model/mjcf/assets/radius_mirrored_15.stl

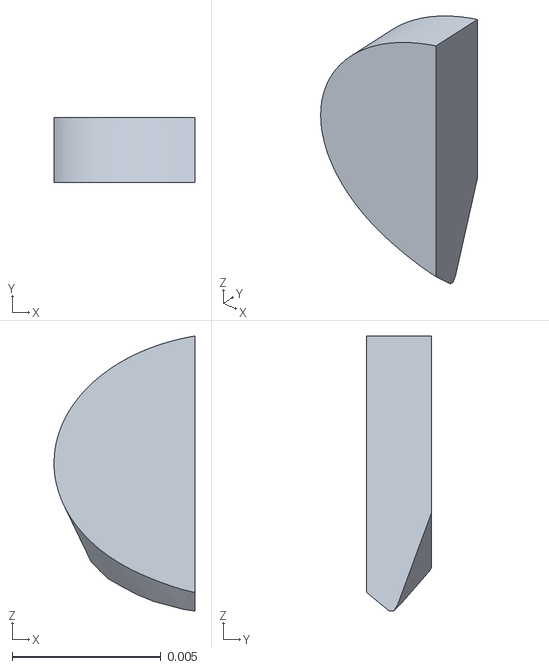
[picture p57: CAD file, 2026-10-27]
src/model/mjcf/assets/radius_mirrored_15.stl
0.00473 x 0.00217 x 0.00924
