Rhoban/microban/src/model/mjcf/assets/coll_dc15_a01_horn_idle2_dummy_04.stl

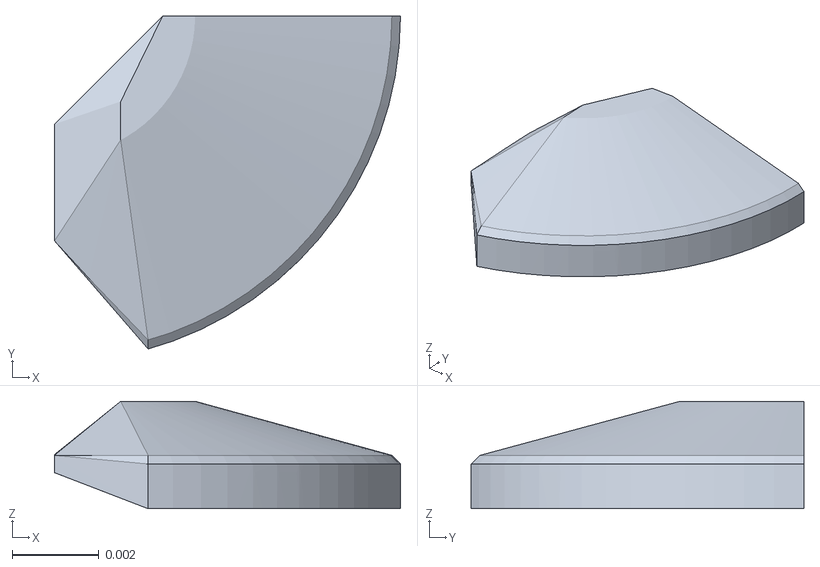
[picture p58: CAD file, 2026-10-27]
src/model/mjcf/assets/coll_dc15_a01_horn_idle2_dummy_04.stl
0.008 x 0.0077 x 0.00248
