Rhoban/microban/src/model/mjcf/assets/coll_arm_bearing_support__configuration_right_08.stl

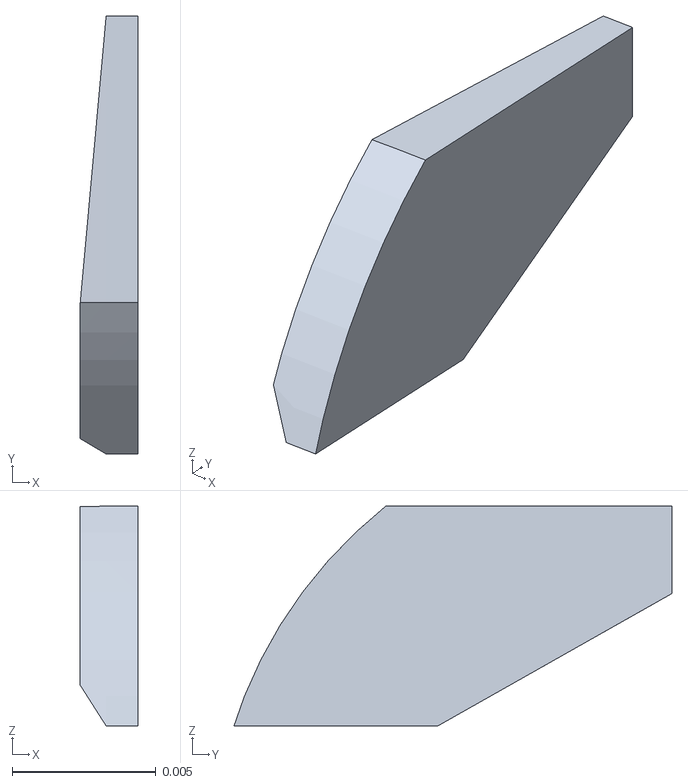
[picture p59: CAD file, 2026-10-27]
src/model/mjcf/assets/coll_arm_bearing_support__configuration_right_08.stl
0.002 x 0.0152 x 0.00763
