Rhoban/microban/src/model/mjcf/assets/coll_femur__configuration_left_11.stl

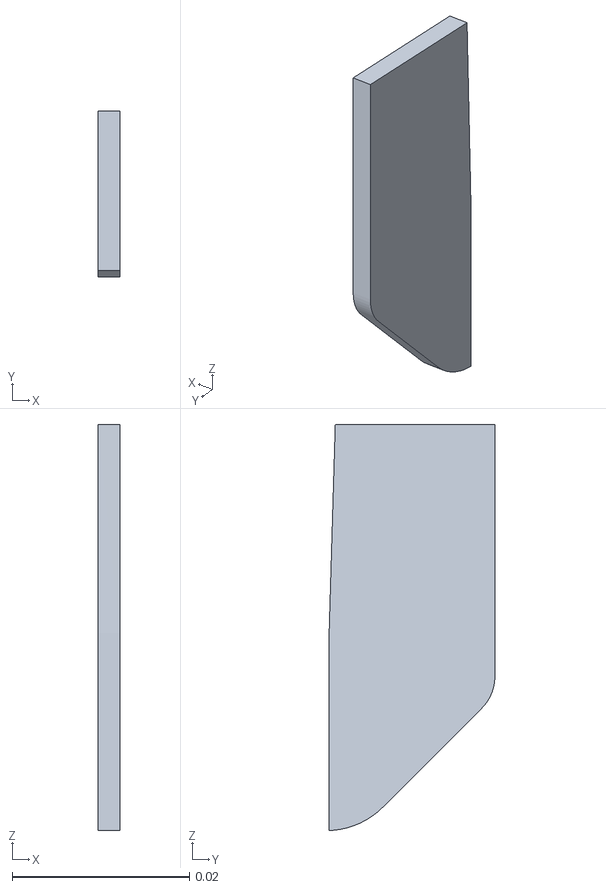
[picture p60: CAD file, 2026-10-27]
src/model/mjcf/assets/coll_femur__configuration_left_11.stl
0.0025 x 0.0187 x 0.0458
