Rhoban/microban/src/model/mjcf/assets/coll_femur__configuration_right_06.stl

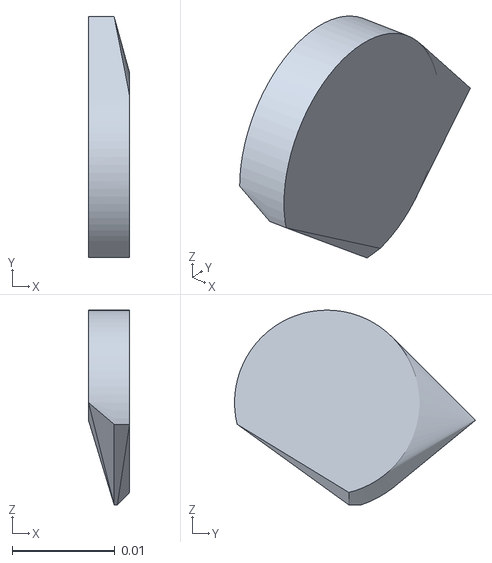
[picture p61: CAD file, 2026-10-27]
src/model/mjcf/assets/coll_femur__configuration_right_06.stl
0.004 x 0.0235 x 0.019
