Rhoban/microban/src/model/mjcf/assets/coll_spacer__configuration_right_00.stl

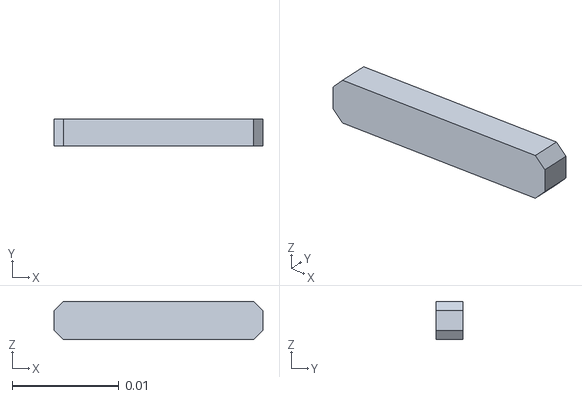
[picture p62: CAD file, 2026-10-27]
src/model/mjcf/assets/coll_spacer__configuration_right_00.stl
0.0196 x 0.0025 x 0.0036
