Rhoban/microban/src/model/mjcf/assets/coll_dc15_a01_horn_idle2_dummy_06.stl

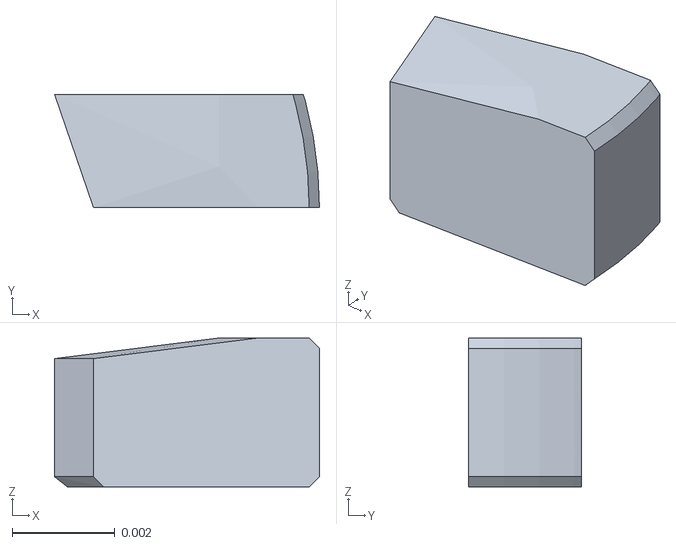
[picture p63: CAD file, 2026-10-27]
src/model/mjcf/assets/coll_dc15_a01_horn_idle2_dummy_06.stl
0.00516 x 0.00221 x 0.0029
