Rhoban/microban/src/model/mjcf/assets/trunk_top__configuration_right.stl

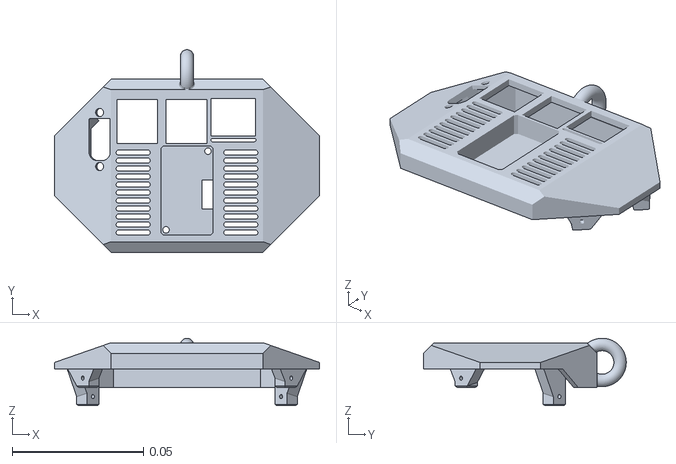
[picture p64: CAD file, 2026-10-27]
src/model/mjcf/assets/trunk_top__configuration_right.stl
0.101 x 0.0772 x 0.0257
