Rhoban/microban/src/model/mjcf/assets/coll_dc15_a01_horn_idle2_dummy_01.stl

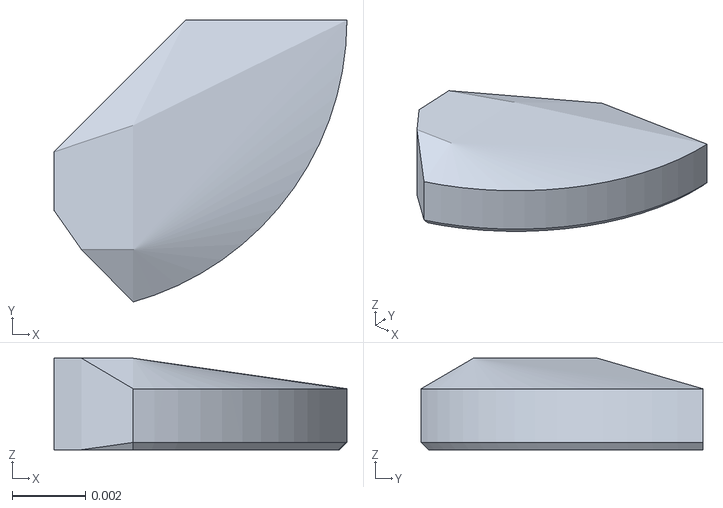
[picture p65: CAD file, 2026-10-27]
src/model/mjcf/assets/coll_dc15_a01_horn_idle2_dummy_01.stl
0.008 x 0.0077 x 0.0025
