Rhoban/microban/src/model/mjcf/assets/radius_mirrored_02.stl

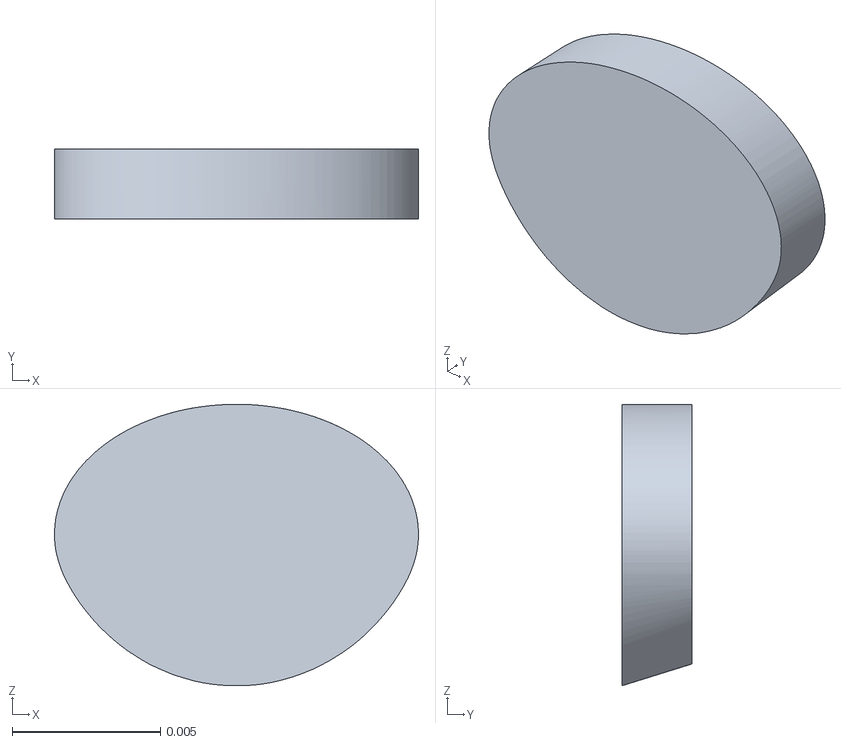
[picture p66: CAD file, 2026-10-27]
src/model/mjcf/assets/radius_mirrored_02.stl
0.0123 x 0.00235 x 0.00949
