Rhoban/microban/src/model/mjcf/assets/coll_femur__configuration_left_06.stl

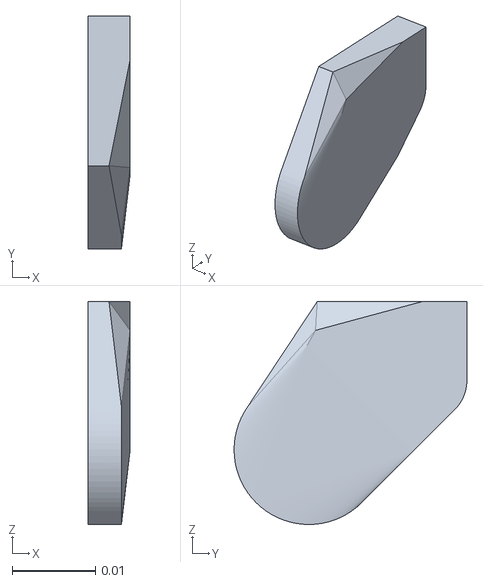
[picture p67: CAD file, 2026-10-27]
src/model/mjcf/assets/coll_femur__configuration_left_06.stl
0.00505 x 0.028 x 0.0268
