Rhoban/microban/src/model/mjcf/assets/head__configuration_right.stl

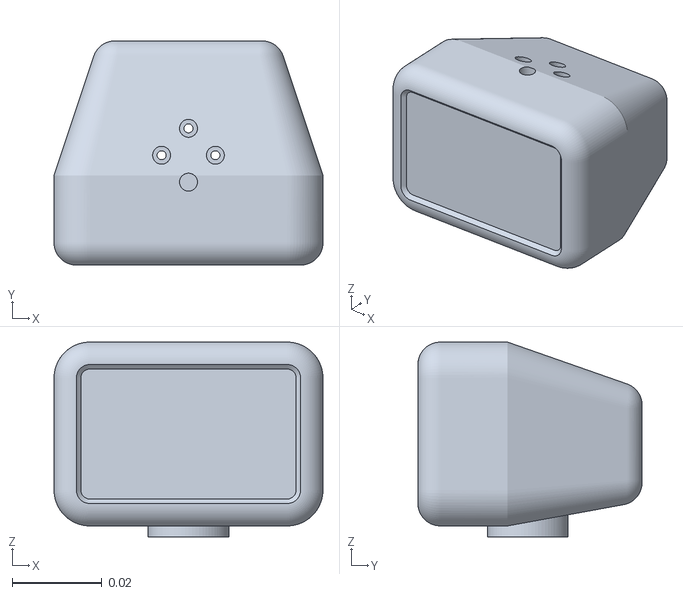
[picture p68: CAD file, 2026-10-27]
src/model/mjcf/assets/head__configuration_right.stl
0.06 x 0.05 x 0.0434
