Rhoban/microban/src/model/mjcf/assets/radius_19.stl

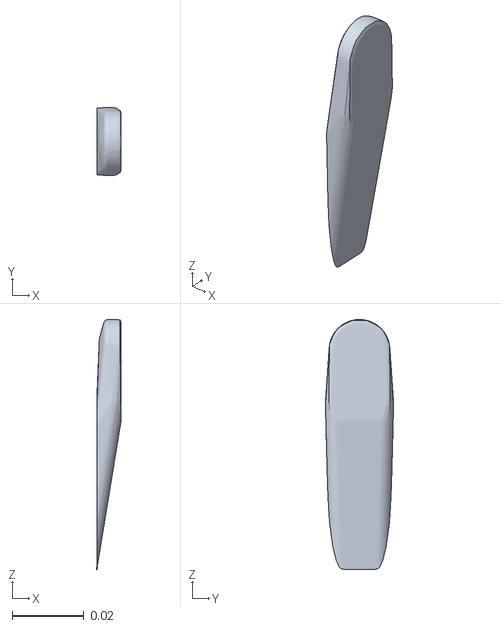
[picture p69: CAD file, 2026-10-27]
src/model/mjcf/assets/radius_19.stl
0.00682 x 0.019 x 0.0698
