Rhoban/microban/src/model/mjcf/assets/coll_shoulder_04.stl

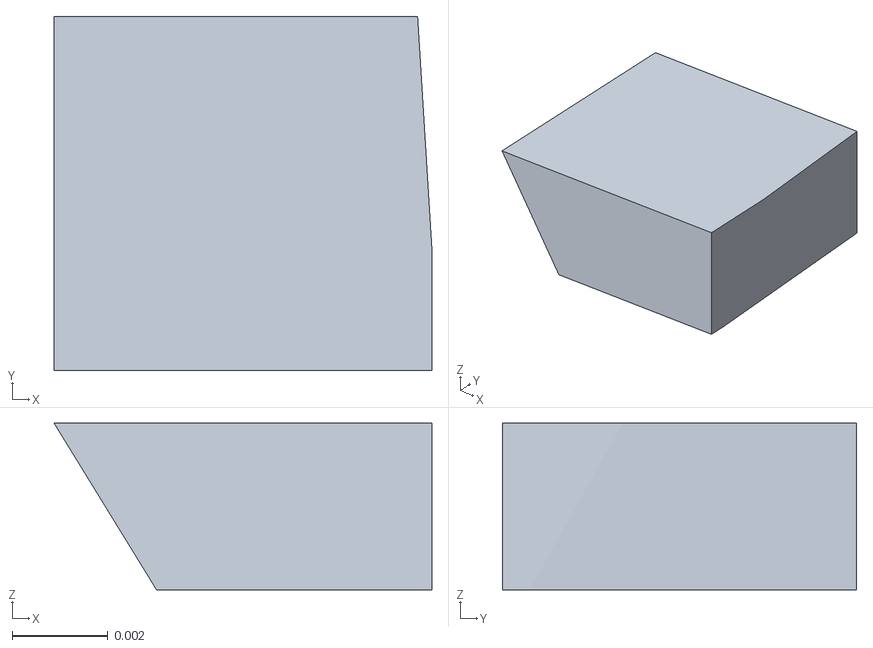
[picture p70: CAD file, 2026-10-27]
src/model/mjcf/assets/coll_shoulder_04.stl
0.00789 x 0.0074 x 0.00348
