Rhoban/microban/src/model/mjcf/assets/radius_mirrored_01.stl

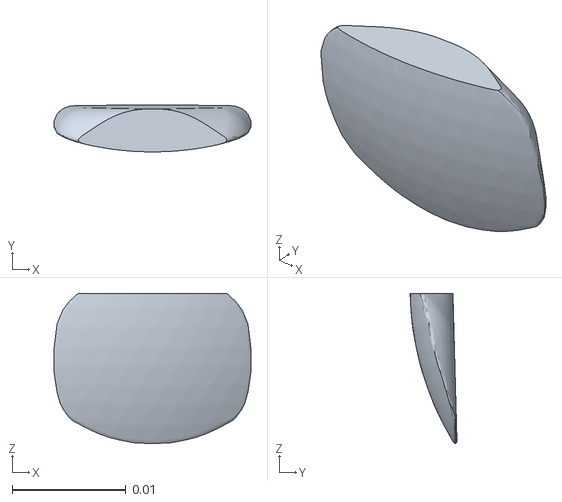
[picture p71: CAD file, 2026-10-27]
src/model/mjcf/assets/radius_mirrored_01.stl
0.0173 x 0.00412 x 0.0132
