Rhoban/microban/src/model/mjcf/assets/coll_humerus_07.stl

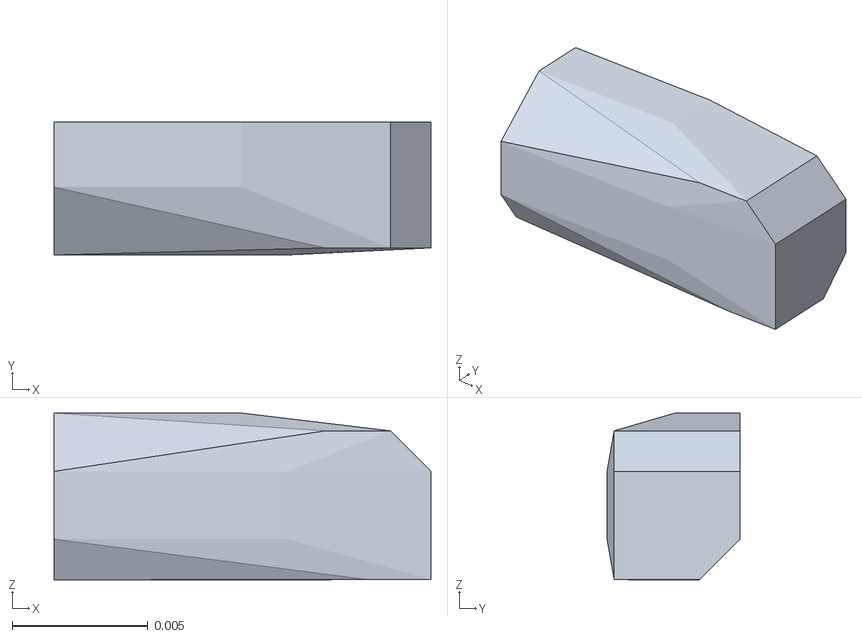
[picture p72: CAD file, 2026-10-27]
src/model/mjcf/assets/coll_humerus_07.stl
0.0139 x 0.00491 x 0.00615
