Rhoban/microban/src/model/mjcf/assets/coll_hip_dbl_block__configuration_left_04.stl

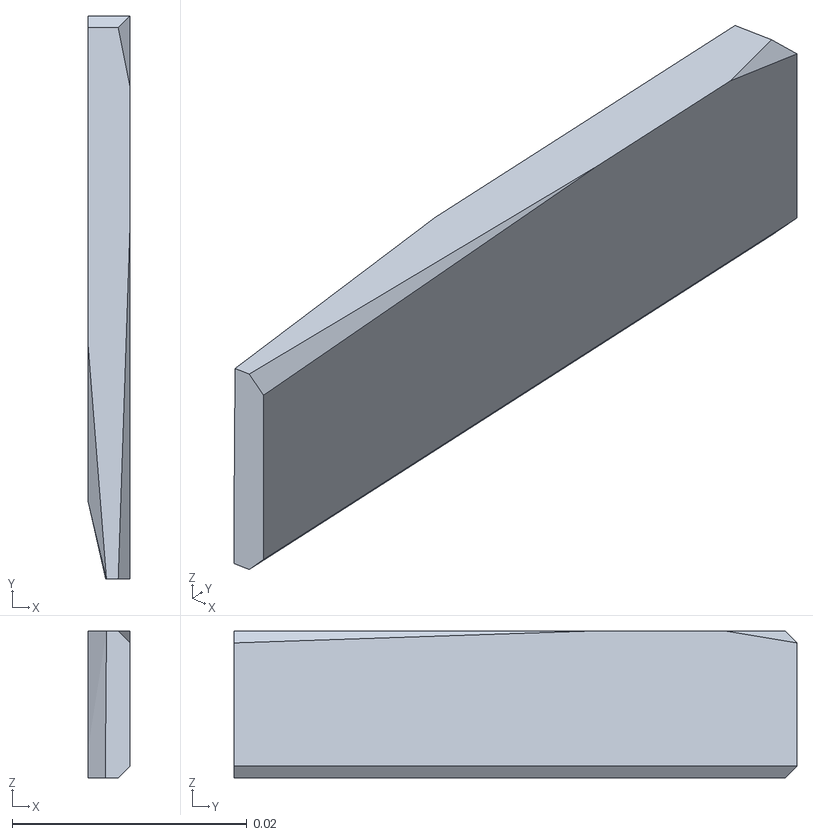
[picture p73: CAD file, 2026-10-27]
src/model/mjcf/assets/coll_hip_dbl_block__configuration_left_04.stl
0.00357 x 0.048 x 0.0125
