Rhoban/microban/src/model/mjcf/assets/coll_hip_dbl_block__configuration_right_08.stl

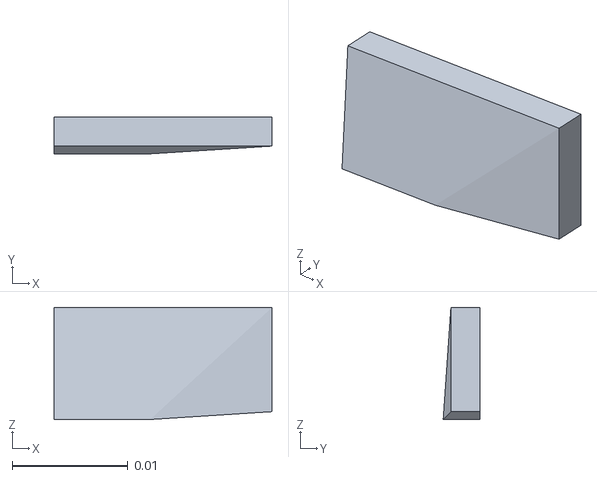
[picture p74: CAD file, 2026-10-27]
src/model/mjcf/assets/coll_hip_dbl_block__configuration_right_08.stl
0.0188 x 0.00317 x 0.00966
