Rhoban/microban/src/model/mjcf/assets/pelvis__configuration_right.stl

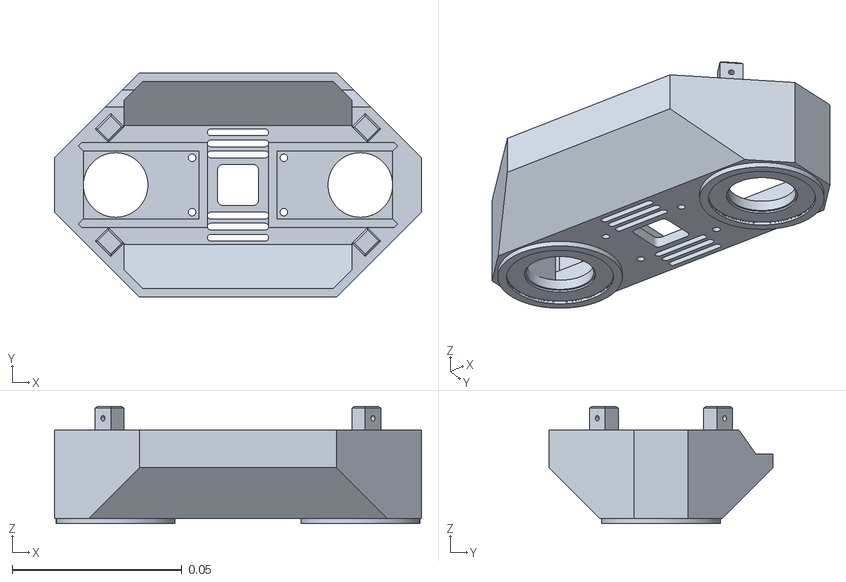
[picture p75: CAD file, 2026-10-27]
src/model/mjcf/assets/pelvis__configuration_right.stl
0.108 x 0.066 x 0.0345
