Rhoban/microban/src/model/mjcf/assets/coll_shoulder_11.stl

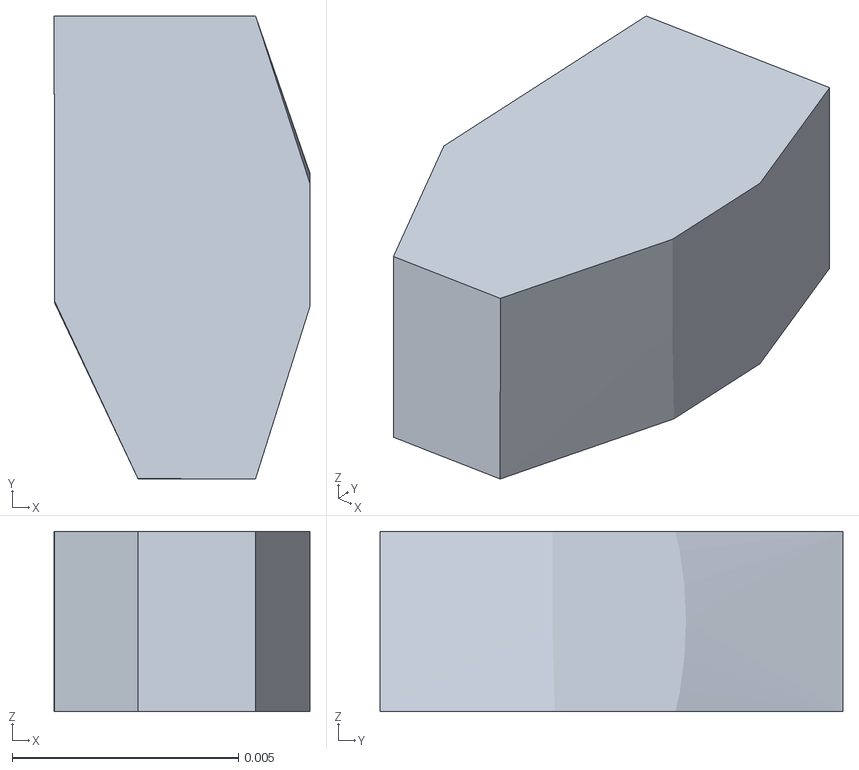
[picture p76: CAD file, 2026-10-27]
src/model/mjcf/assets/coll_shoulder_11.stl
0.00565 x 0.0102 x 0.00399
