Rhoban/microban/src/model/mjcf/assets/coll_hip_dbl_block__configuration_right_00.stl

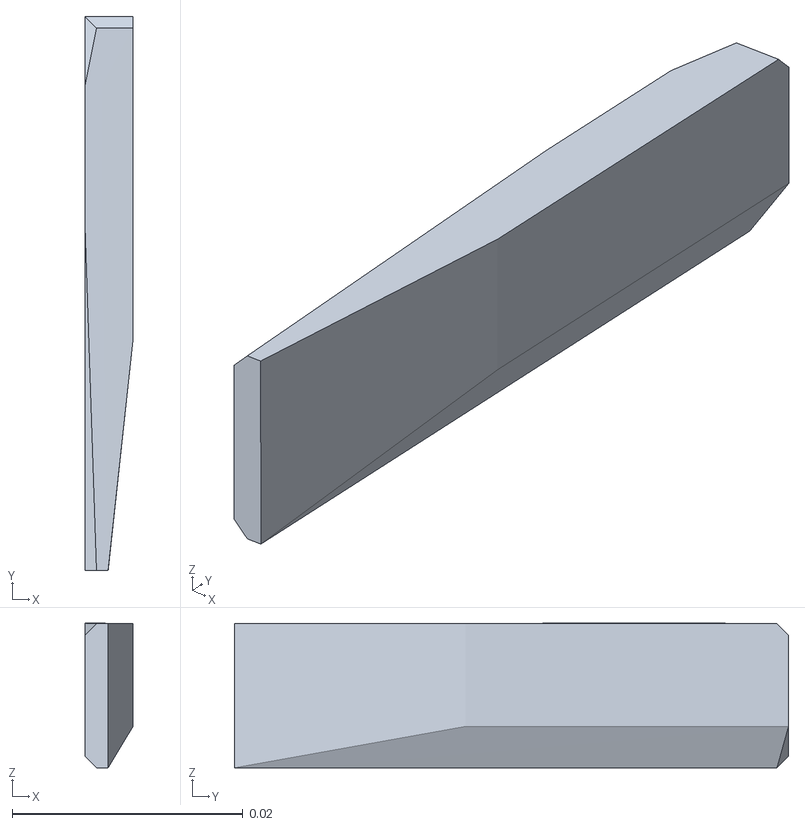
[picture p77: CAD file, 2026-10-27]
src/model/mjcf/assets/coll_hip_dbl_block__configuration_right_00.stl
0.00417 x 0.048 x 0.0125
