Rhoban/microban/src/model/mjcf/assets/foot__configuration_right_09.stl

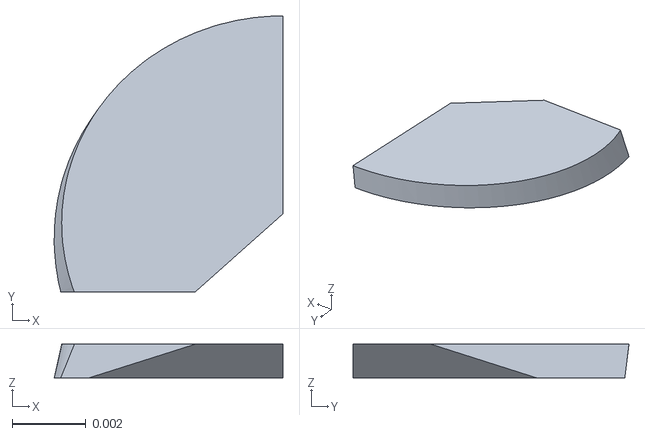
[picture p78: CAD file, 2026-10-27]
src/model/mjcf/assets/foot__configuration_right_09.stl
0.00622 x 0.00751 x 0.000913
