Rhoban/microban/src/model/mjcf/assets/radius_15.stl

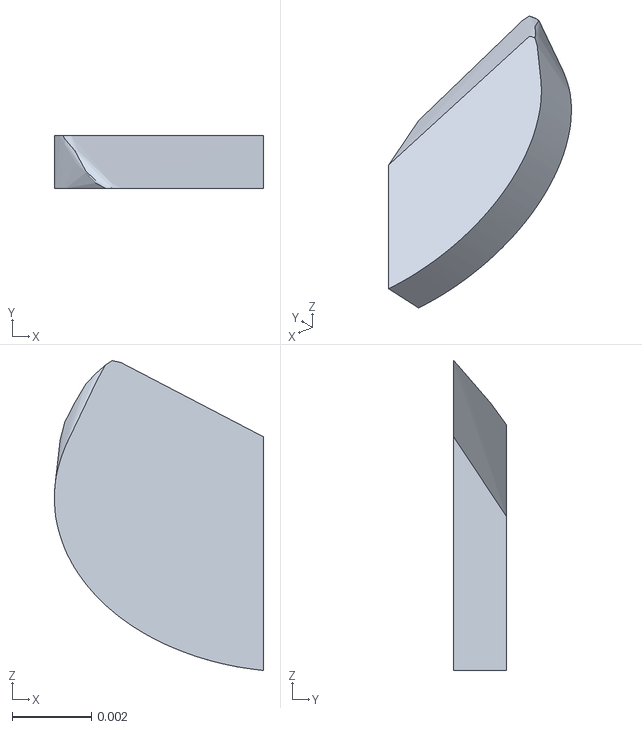
[picture p79: CAD file, 2026-10-27]
src/model/mjcf/assets/radius_15.stl
0.00527 x 0.00133 x 0.00781
