Rhoban/microban/src/model/mjcf/assets/radius_01.stl

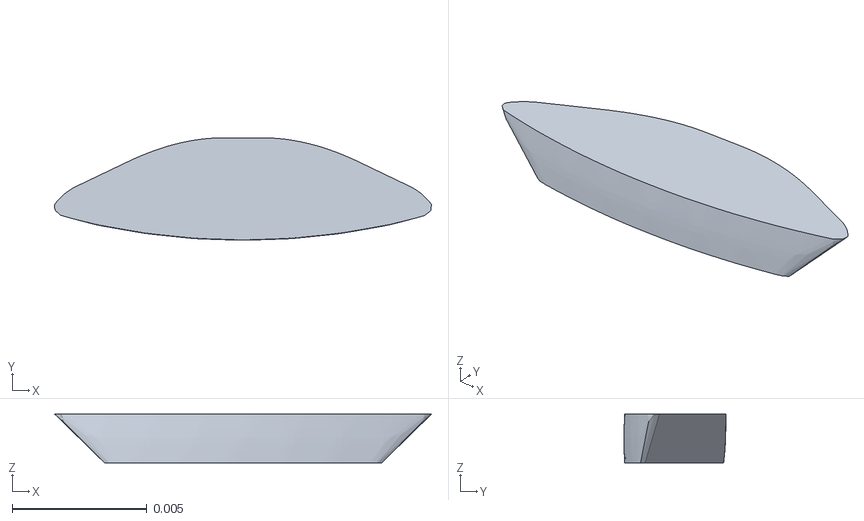
[picture p80: CAD file, 2026-10-27]
src/model/mjcf/assets/radius_01.stl
0.014 x 0.0038 x 0.00181
