Rhoban/microban/src/model/mjcf/assets/coll_dc15_a01_horn_idle2_dummy_03.stl

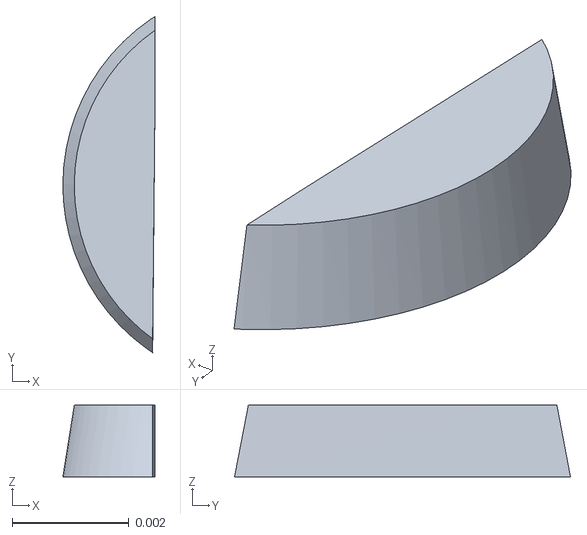
[picture p81: CAD file, 2026-10-27]
src/model/mjcf/assets/coll_dc15_a01_horn_idle2_dummy_03.stl
0.00158 x 0.00576 x 0.00123
