Rhoban/microban/src/model/mjcf/assets/radius_20.stl

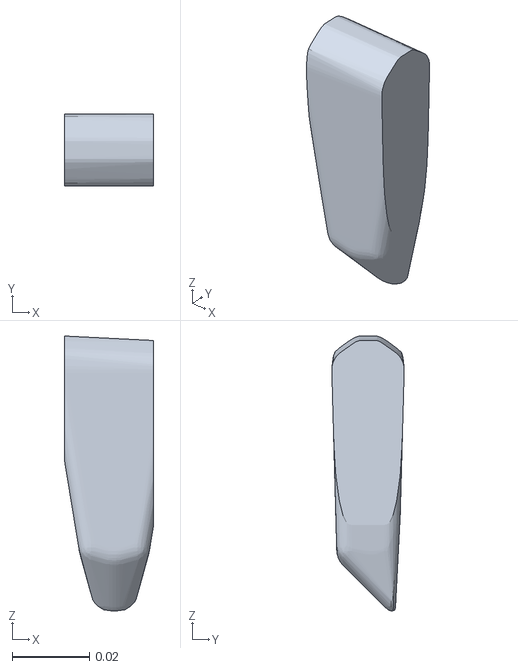
[picture p82: CAD file, 2026-10-27]
src/model/mjcf/assets/radius_20.stl
0.0231 x 0.0187 x 0.0712
