Rhoban/microban/src/model/mjcf/assets/coll_femur__configuration_right_07.stl

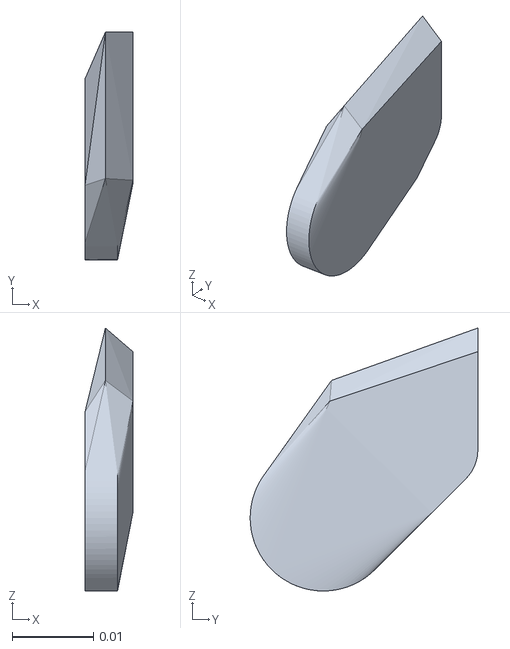
[picture p83: CAD file, 2026-10-27]
src/model/mjcf/assets/coll_femur__configuration_right_07.stl
0.00589 x 0.028 x 0.0323
