Rhoban/microban/src/model/mjcf/assets/radius_21.stl

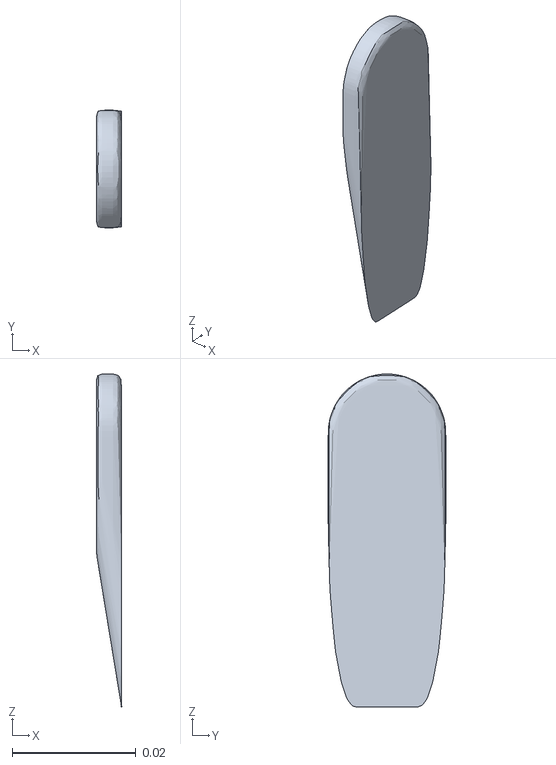
[picture p84: CAD file, 2026-10-27]
src/model/mjcf/assets/radius_21.stl
0.00405 x 0.019 x 0.0539
