Rhoban/microban/src/model/mjcf/assets/coll_femur__configuration_left_02.stl

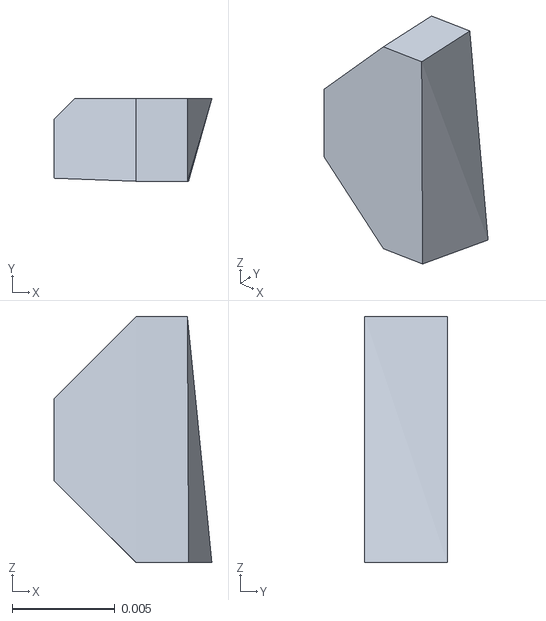
[picture p85: CAD file, 2026-10-27]
src/model/mjcf/assets/coll_femur__configuration_left_02.stl
0.00769 x 0.00402 x 0.012
