Rhoban/microban/src/model/mjcf/assets/coll_arm_bearing_support__configuration_right_00.stl

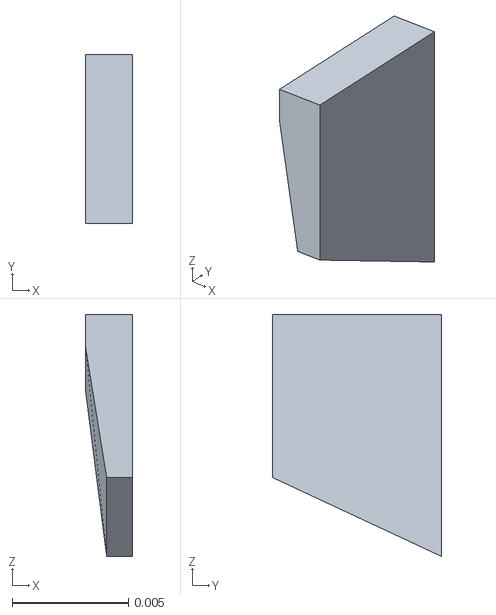
[picture p86: CAD file, 2026-10-27]
src/model/mjcf/assets/coll_arm_bearing_support__configuration_right_00.stl
0.002 x 0.00728 x 0.0104
