Rhoban/microban/src/model/mjcf/assets/foot__configuration_right_21.stl

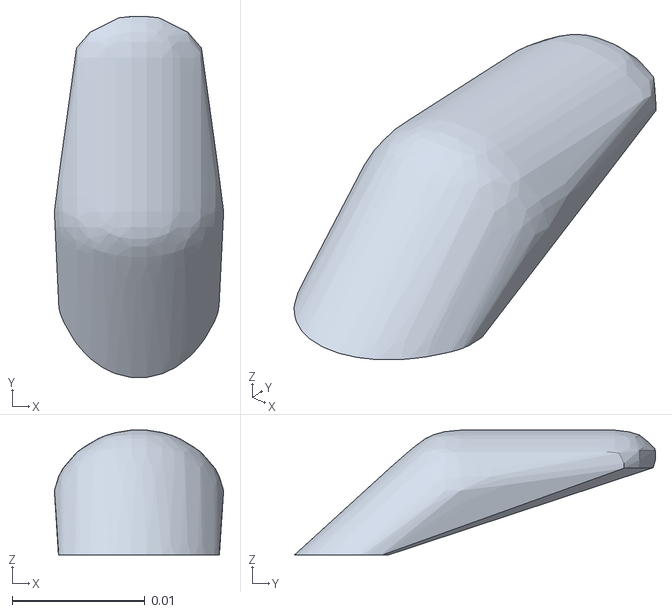
[picture p87: CAD file, 2026-10-27]
src/model/mjcf/assets/foot__configuration_right_21.stl
0.0127 x 0.0272 x 0.00939
