Rhoban/microban/src/model/mjcf/assets/coll_dc15_a01_horn_idle2_dummy_08.stl

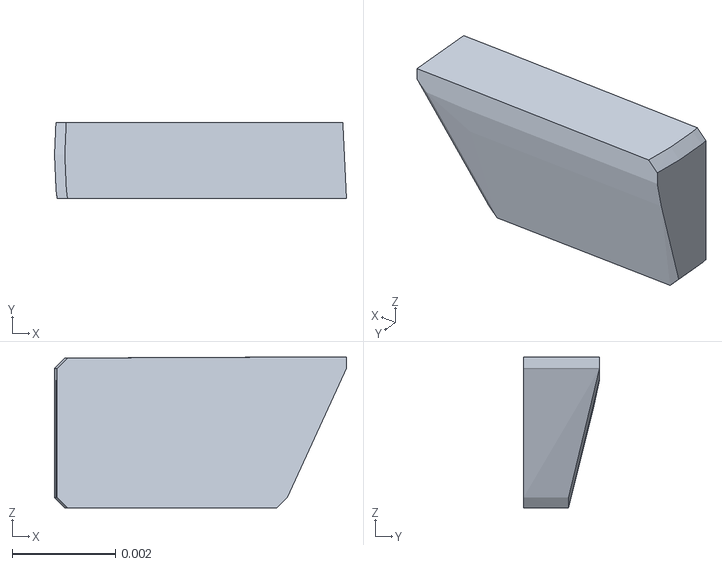
[picture p88: CAD file, 2026-10-27]
src/model/mjcf/assets/coll_dc15_a01_horn_idle2_dummy_08.stl
0.00565 x 0.00147 x 0.00292
