Rhoban/microban/src/model/mjcf/assets/radius_mirrored_10.stl

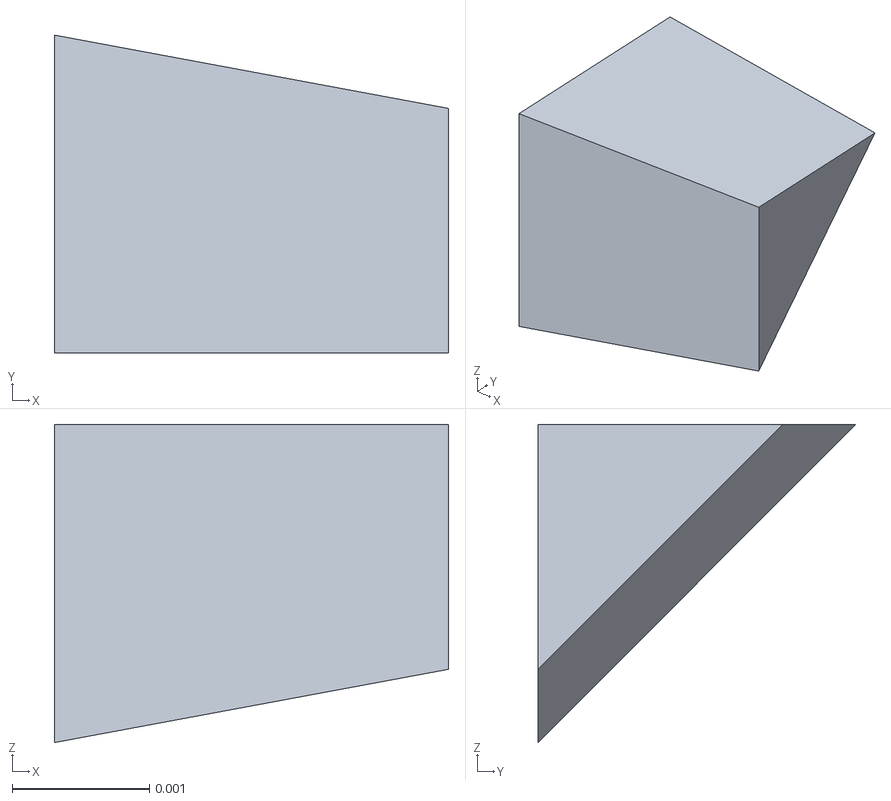
[picture p89: CAD file, 2026-10-27]
src/model/mjcf/assets/radius_mirrored_10.stl
0.00287 x 0.00232 x 0.00232
