Rhoban/microban/src/model/mjcf/assets/coll_tibia__configuration_right_05.stl

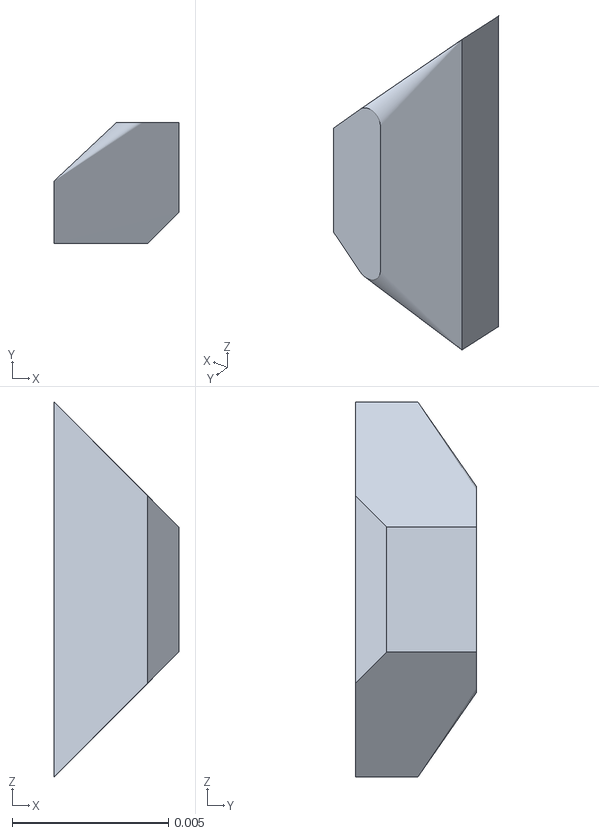
[picture p90: CAD file, 2026-10-27]
src/model/mjcf/assets/coll_tibia__configuration_right_05.stl
0.004 x 0.00387 x 0.012
