Rhoban/microban/src/model/mjcf/assets/coll_hip_dbl_block__configuration_left_01.stl

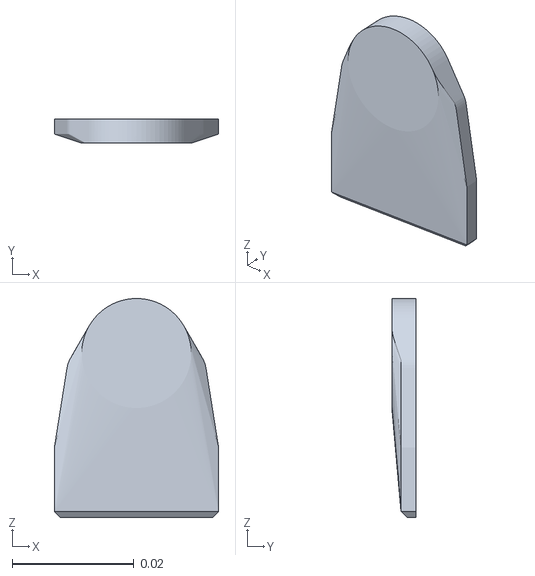
[picture p91: CAD file, 2026-10-27]
src/model/mjcf/assets/coll_hip_dbl_block__configuration_left_01.stl
0.027 x 0.004 x 0.036
