Rhoban/microban/src/model/mjcf/assets/coll_shoulder_08.stl

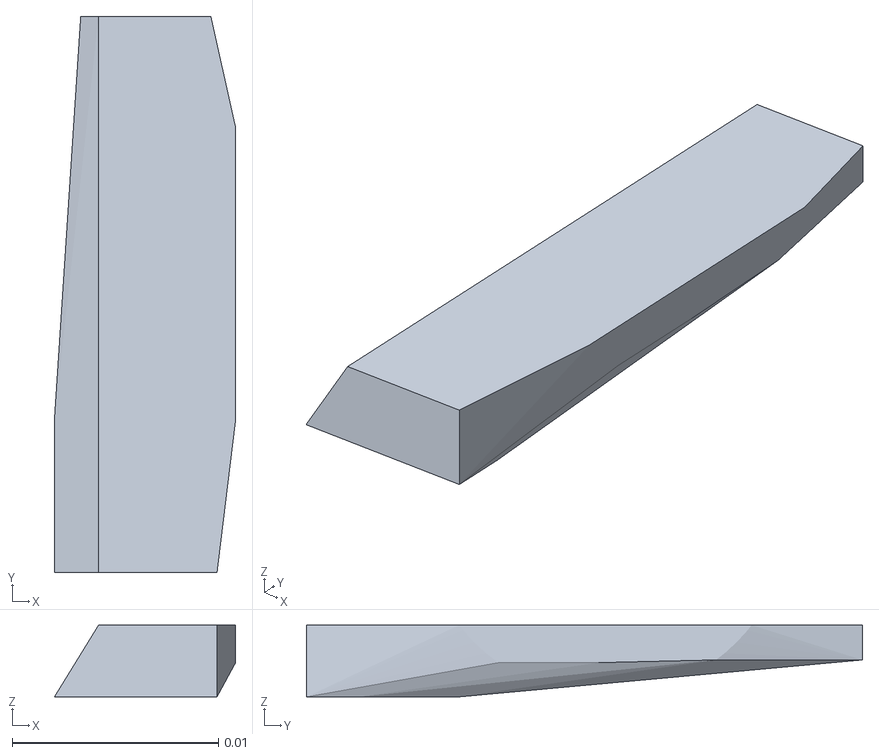
[picture p92: CAD file, 2026-10-27]
src/model/mjcf/assets/coll_shoulder_08.stl
0.00879 x 0.027 x 0.00348
