Rhoban/microban/src/model/mjcf/assets/coll_shoulder_10.stl

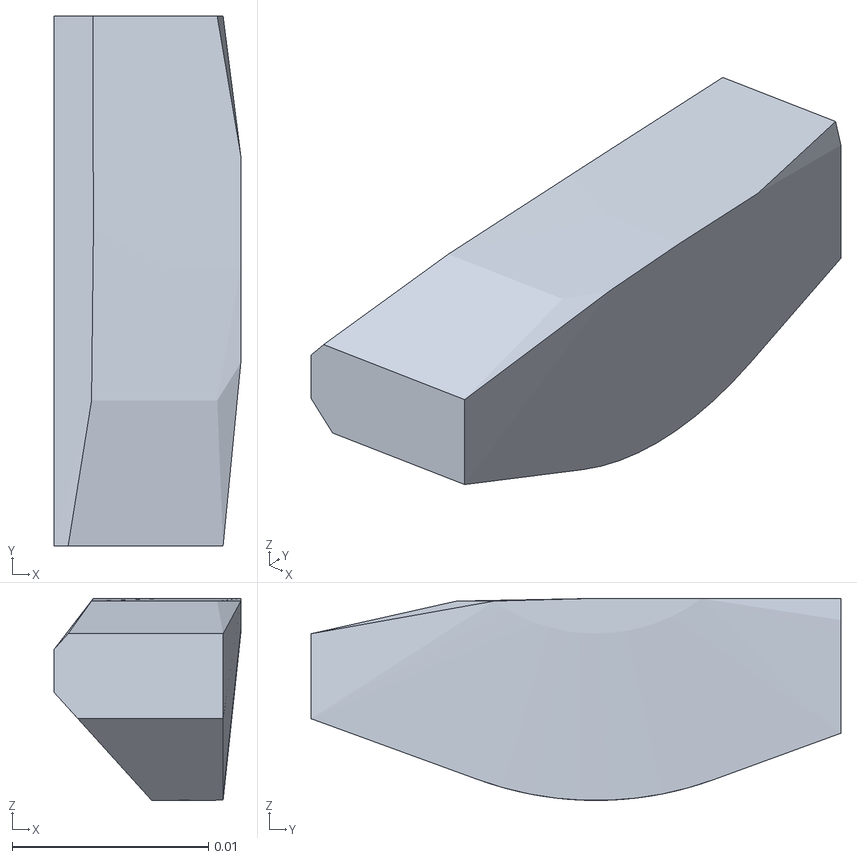
[picture p93: CAD file, 2026-10-27]
src/model/mjcf/assets/coll_shoulder_10.stl
0.0095 x 0.027 x 0.0103
