Rhoban/microban/src/model/mjcf/assets/coll_hip__configuration_right_11.stl

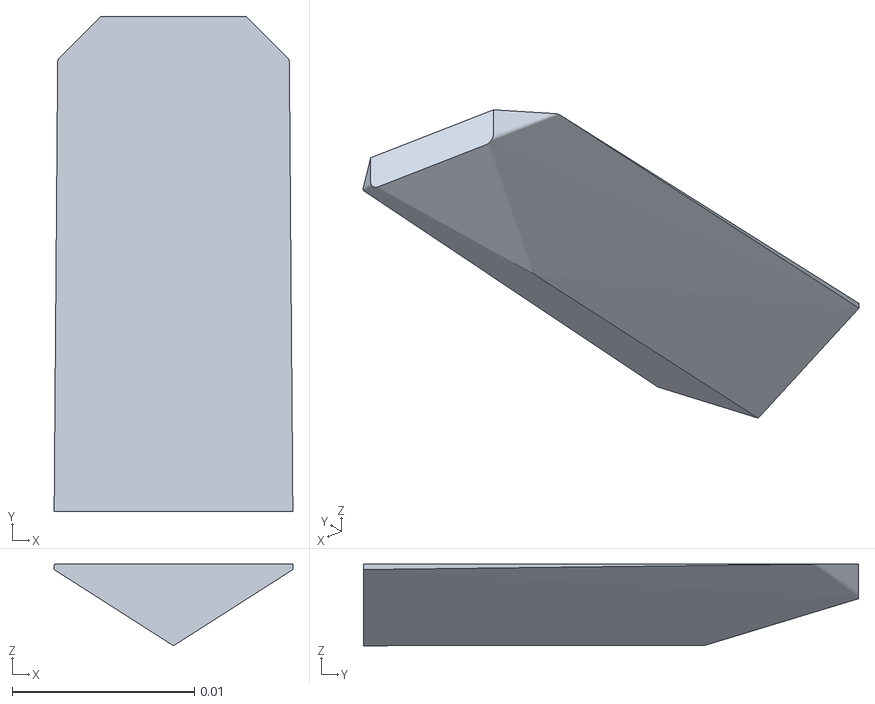
[picture p94: CAD file, 2026-10-27]
src/model/mjcf/assets/coll_hip__configuration_right_11.stl
0.0131 x 0.0272 x 0.00448
