Rhoban/microban/src/model/mjcf/assets/hip__configuration_right.stl

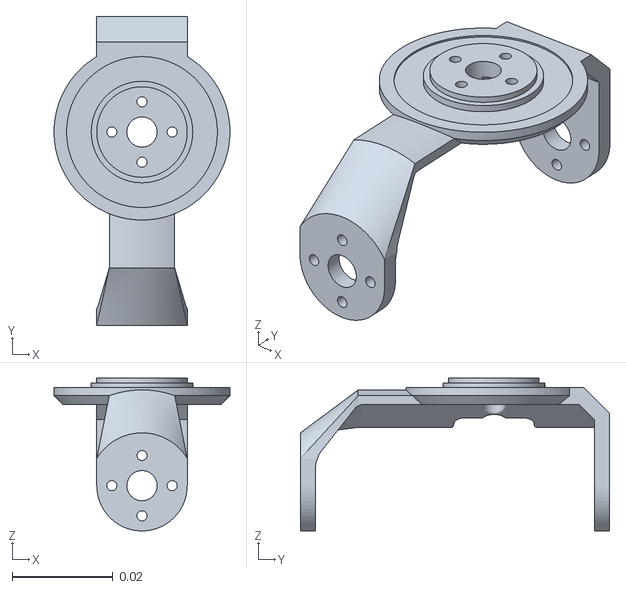
[picture p95: CAD file, 2026-10-27]
src/model/mjcf/assets/hip__configuration_right.stl
0.035 x 0.0615 x 0.0304
