Rhoban/microban/src/model/mjcf/assets/coll_dc15_a01_horn_idle2_dummy_10.stl

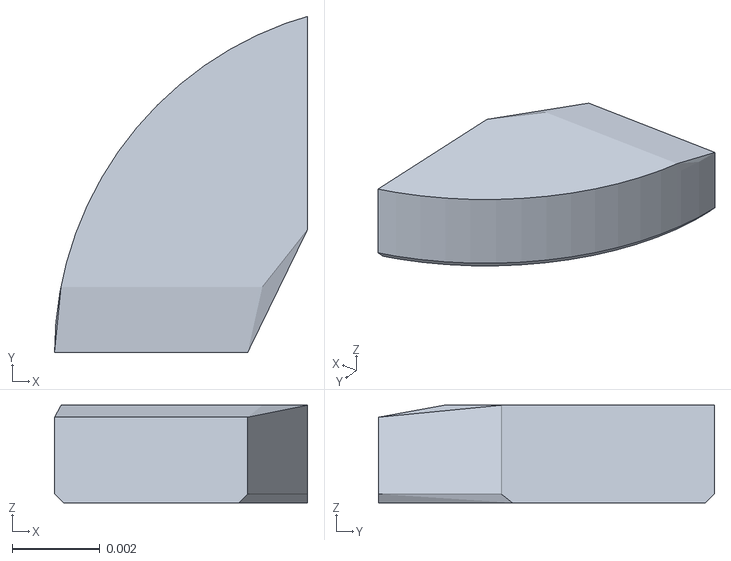
[picture p96: CAD file, 2026-10-27]
src/model/mjcf/assets/coll_dc15_a01_horn_idle2_dummy_10.stl
0.00576 x 0.00765 x 0.00222
