Rhoban/microban/src/model/mjcf/assets/coll_ankle_dbl_block__configuration_right_06.stl

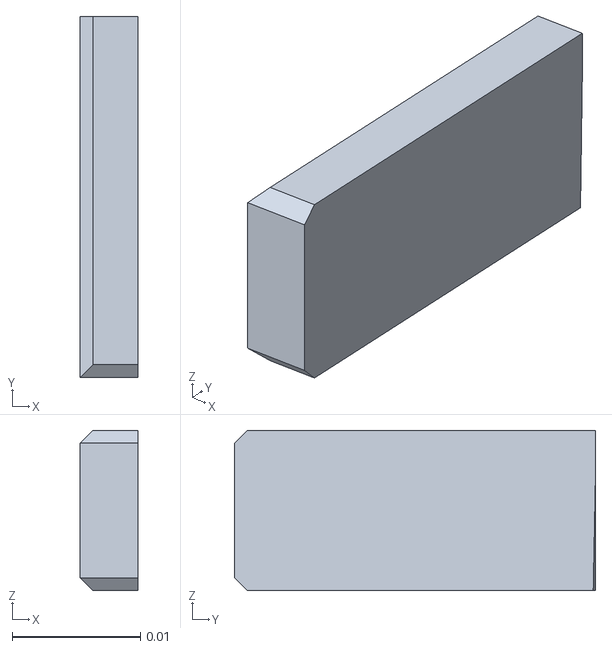
[picture p97: CAD file, 2026-10-27]
src/model/mjcf/assets/coll_ankle_dbl_block__configuration_right_06.stl
0.00451 x 0.0282 x 0.0125
