Rhoban/microban/src/model/mjcf/assets/coll_ankle_dbl_block__configuration_right_11.stl

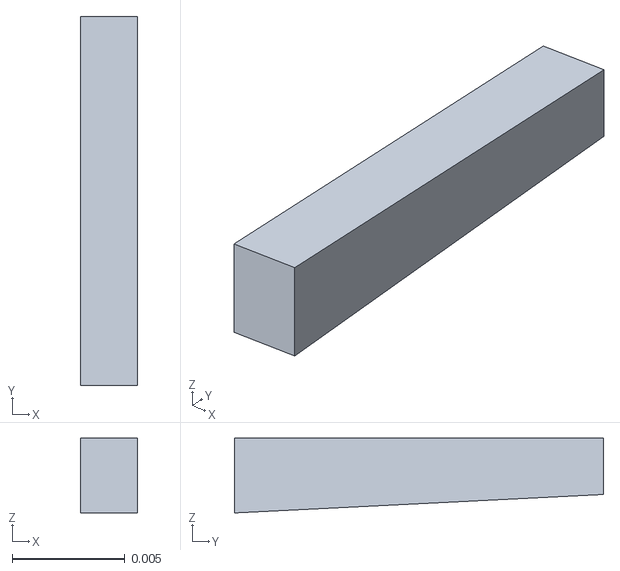
[picture p98: CAD file, 2026-10-27]
src/model/mjcf/assets/coll_ankle_dbl_block__configuration_right_11.stl
0.00251 x 0.0163 x 0.00332
