Rhoban/microban/src/model/mjcf/assets/coll_tibia__configuration_right_07.stl

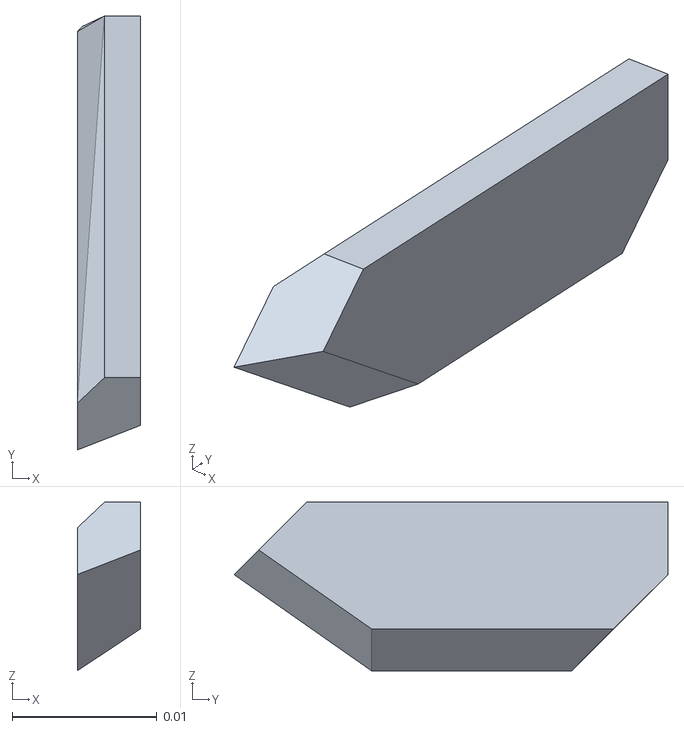
[picture p99: CAD file, 2026-10-27]
src/model/mjcf/assets/coll_tibia__configuration_right_07.stl
0.00438 x 0.03 x 0.0117
