Rhoban/microban/src/model/mjcf/assets/coll_shoulder_00.stl

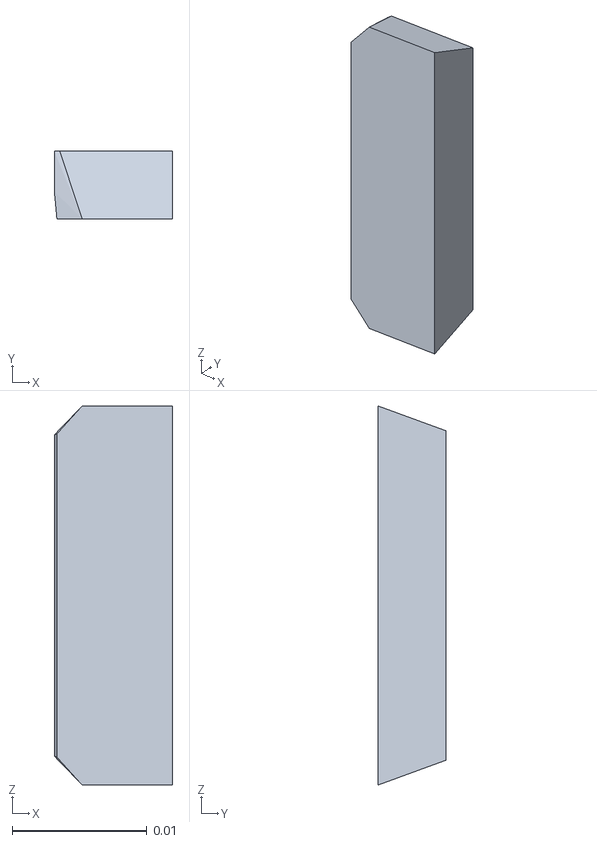
[picture p100: CAD file, 2026-10-27]
src/model/mjcf/assets/coll_shoulder_00.stl
0.00879 x 0.00503 x 0.0282
