Rhoban/microban/src/model/mjcf/assets/radius_mirrored_06.stl

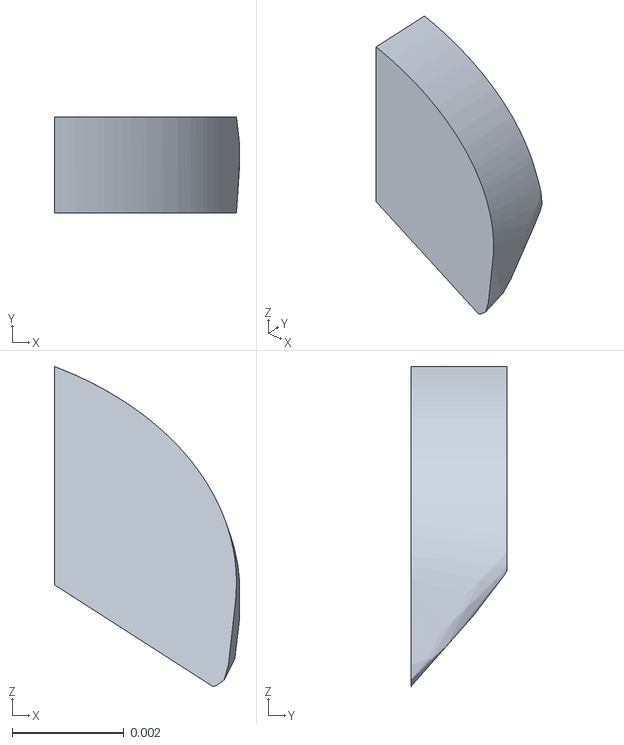
[picture p101: CAD file, 2026-10-27]
src/model/mjcf/assets/radius_mirrored_06.stl
0.00332 x 0.00172 x 0.00573
