Rhoban/microban/src/model/mjcf/assets/radius_00.stl

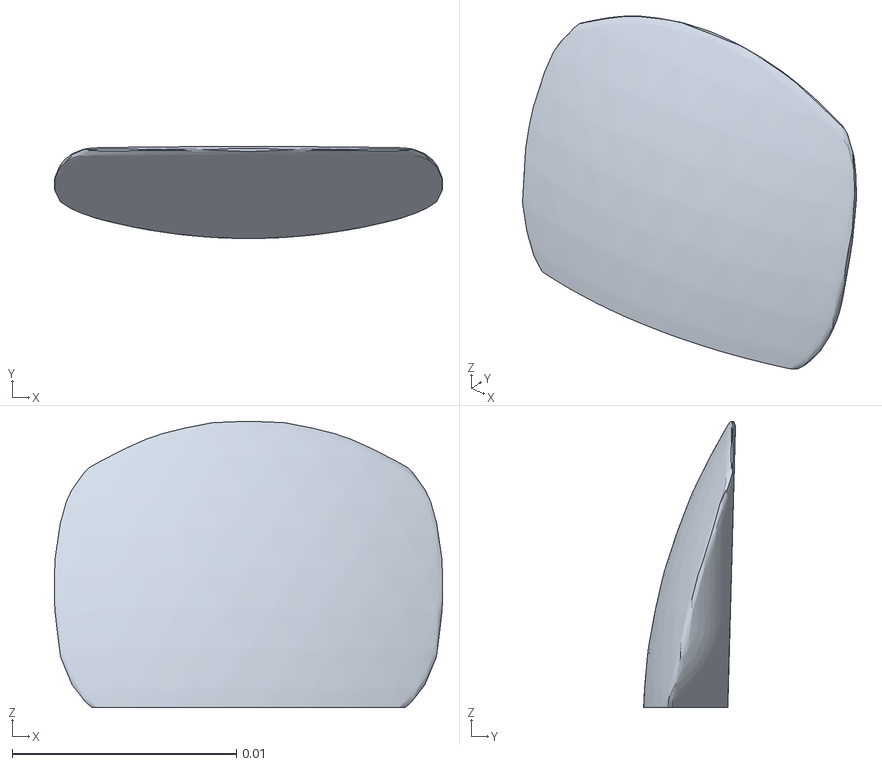
[picture p102: CAD file, 2026-10-27]
src/model/mjcf/assets/radius_00.stl
0.0173 x 0.0041 x 0.0128
