Rhoban/microban/src/model/mjcf/assets/coll_arm_bearing_support__configuration_right_09.stl

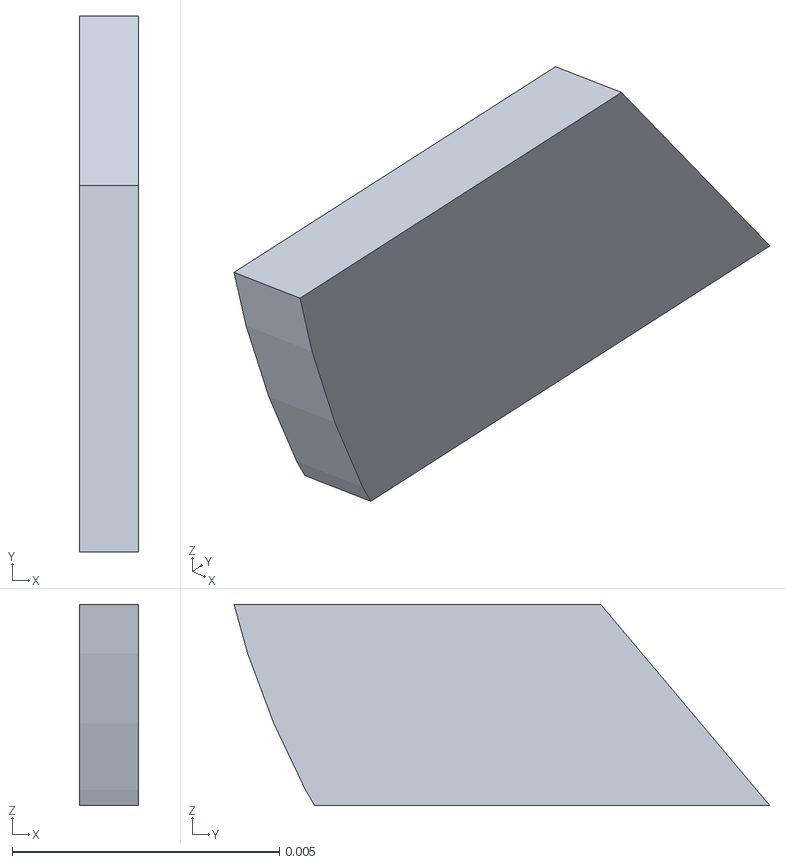
[picture p103: CAD file, 2026-10-27]
src/model/mjcf/assets/coll_arm_bearing_support__configuration_right_09.stl
0.0011 x 0.01 x 0.00377
