Rhoban/microban/src/model/mjcf/assets/foot__configuration_right.stl

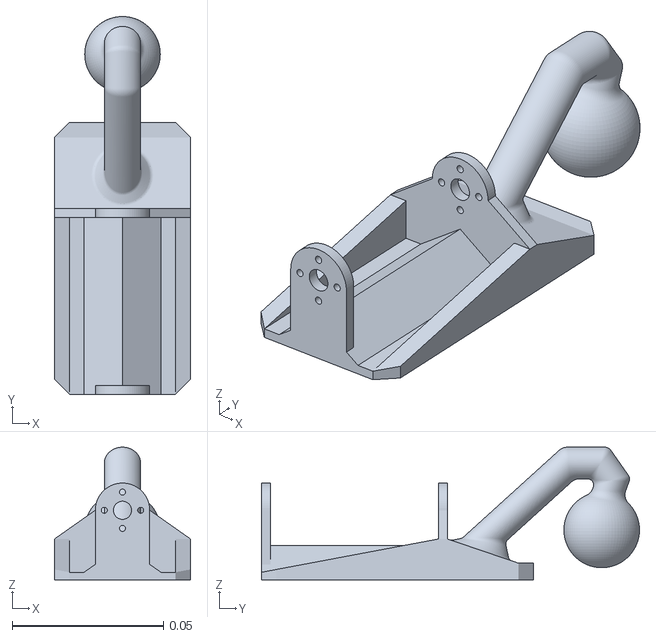
[picture p104: CAD file, 2026-10-27]
src/model/mjcf/assets/foot__configuration_right.stl
0.045 x 0.125 x 0.0439
