Rhoban/microban/src/model/mjcf/assets/coll_tibia__configuration_right_02.stl

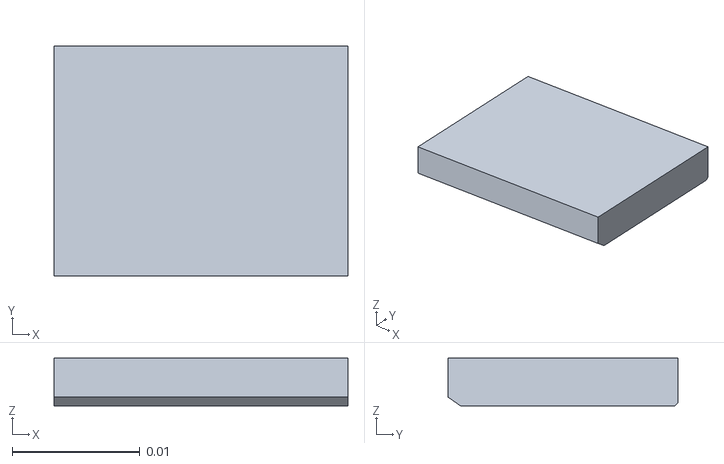
[picture p105: CAD file, 2026-10-27]
src/model/mjcf/assets/coll_tibia__configuration_right_02.stl
0.023 x 0.018 x 0.00375
