Rhoban/microban/src/model/mjcf/assets/foot__configuration_right_16.stl

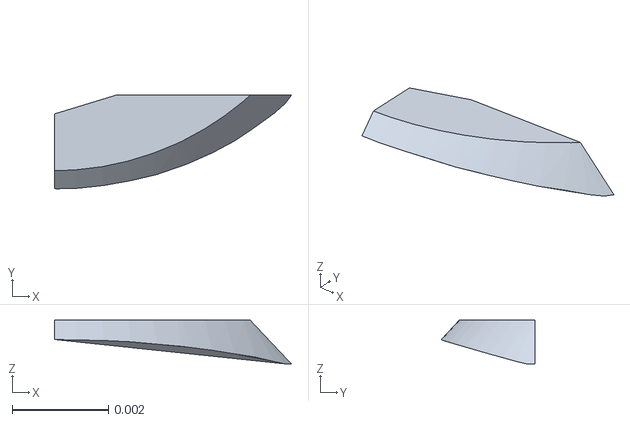
[picture p106: CAD file, 2026-10-27]
src/model/mjcf/assets/foot__configuration_right_16.stl
0.00492 x 0.00195 x 0.000913
