Rhoban/microban/src/model/mjcf/assets/coll_femur__configuration_left_01.stl

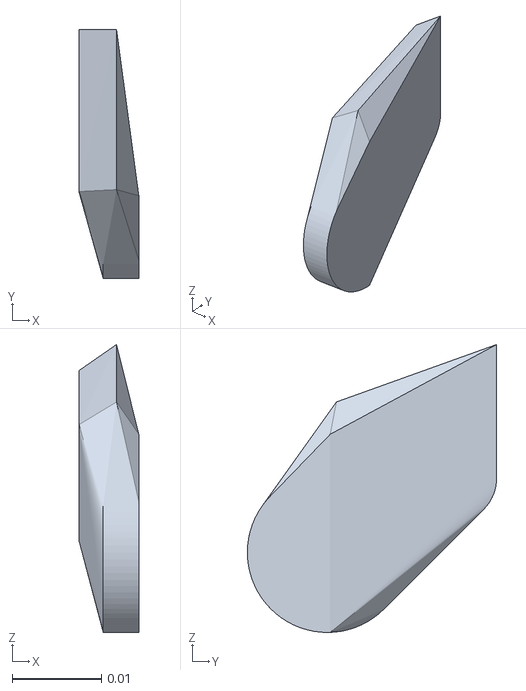
[picture p107: CAD file, 2026-10-27]
src/model/mjcf/assets/coll_femur__configuration_left_01.stl
0.0067 x 0.028 x 0.0323
