Rhoban/microban/src/model/mjcf/assets/coll_hip__configuration_right_03.stl

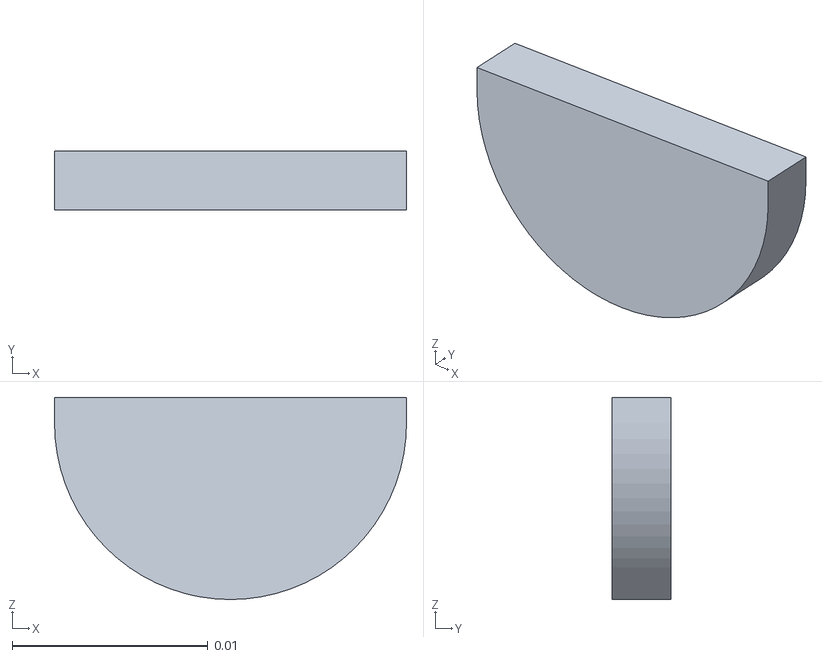
[picture p108: CAD file, 2026-10-27]
src/model/mjcf/assets/coll_hip__configuration_right_03.stl
0.018 x 0.003 x 0.0103
