Rhoban/microban/src/model/mjcf/assets/board_spacer.stl

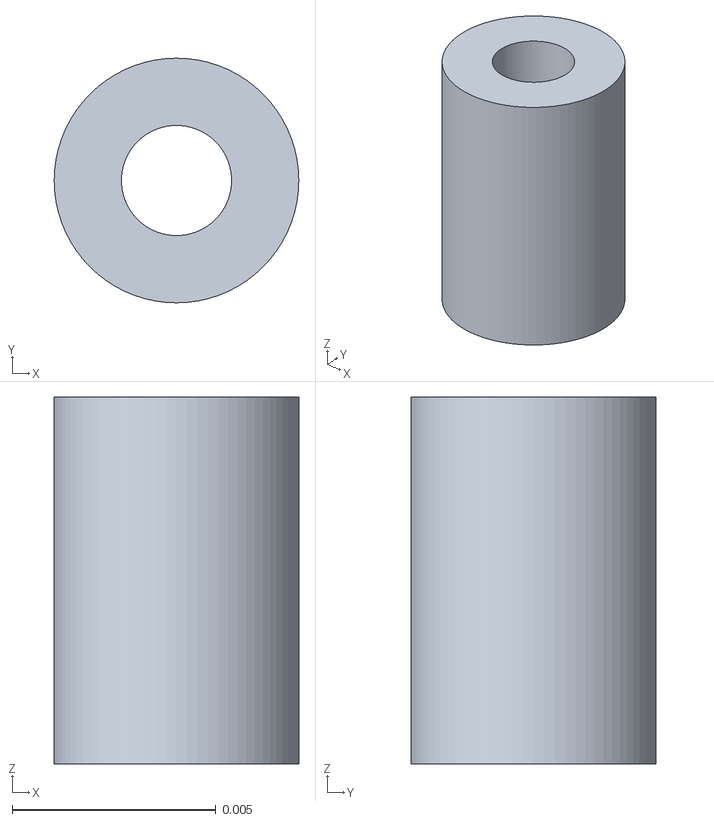
[picture p109: CAD file, 2026-10-27]
src/model/mjcf/assets/board_spacer.stl
0.006 x 0.006 x 0.009
