Rhoban/microban/src/model/mjcf/assets/coll_tibia__configuration_right_08.stl

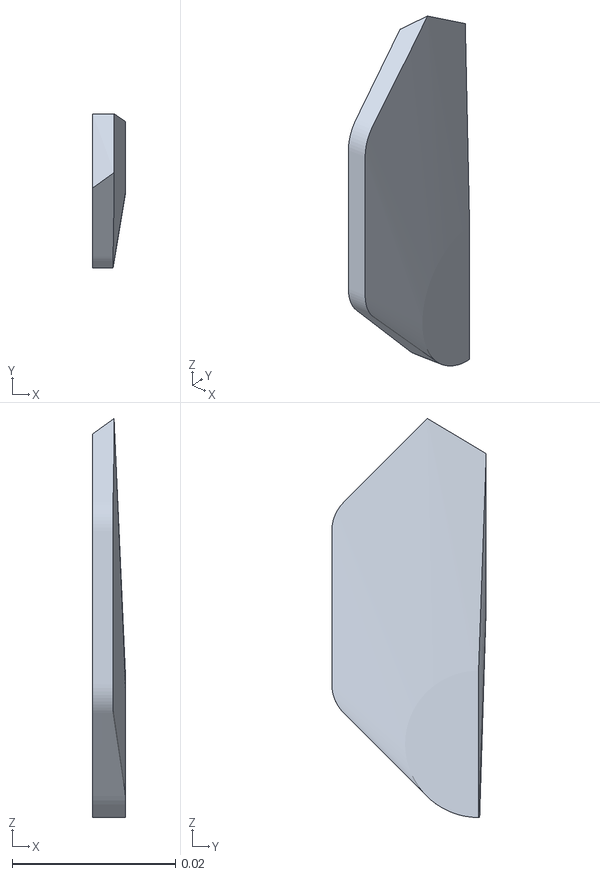
[picture p110: CAD file, 2026-10-27]
src/model/mjcf/assets/coll_tibia__configuration_right_08.stl
0.004 x 0.0189 x 0.0489
