Rhoban/microban/src/model/mjcf/assets/coll_femur__configuration_left_05.stl

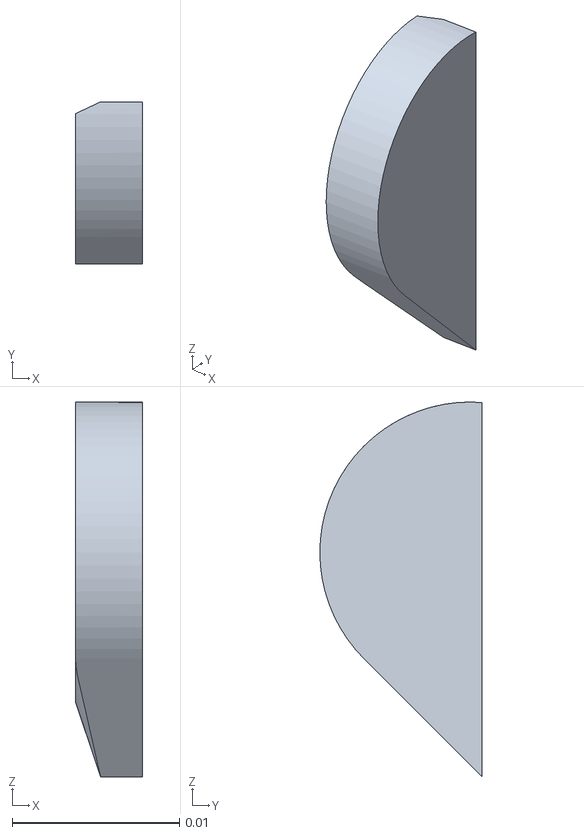
[picture p111: CAD file, 2026-10-27]
src/model/mjcf/assets/coll_femur__configuration_left_05.stl
0.004 x 0.00972 x 0.0224
