Rhoban/microban/src/model/mjcf/assets/radius_mirrored_14.stl

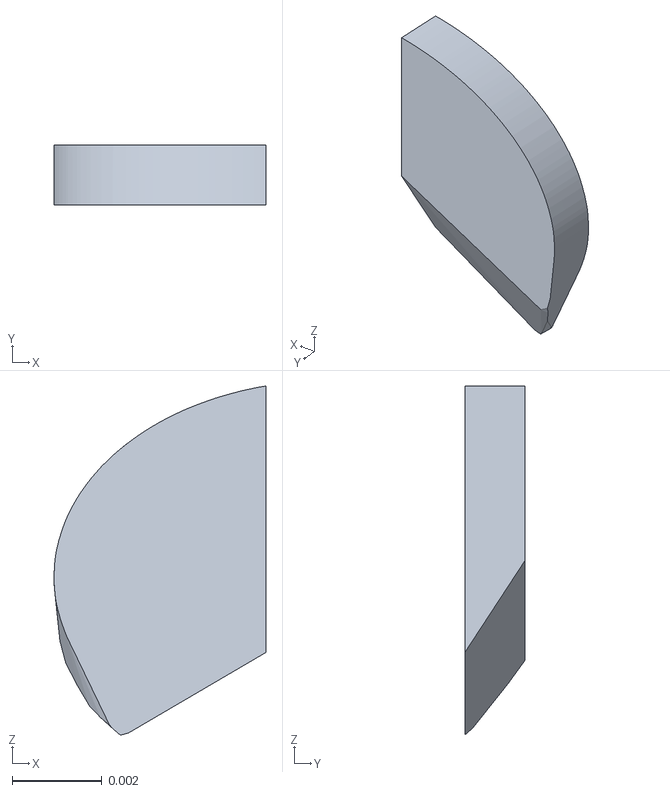
[picture p112: CAD file, 2026-10-27]
src/model/mjcf/assets/radius_mirrored_14.stl
0.00473 x 0.00135 x 0.00779
