Rhoban/microban/src/model/mjcf/assets/coll_tibia__configuration_right_03.stl

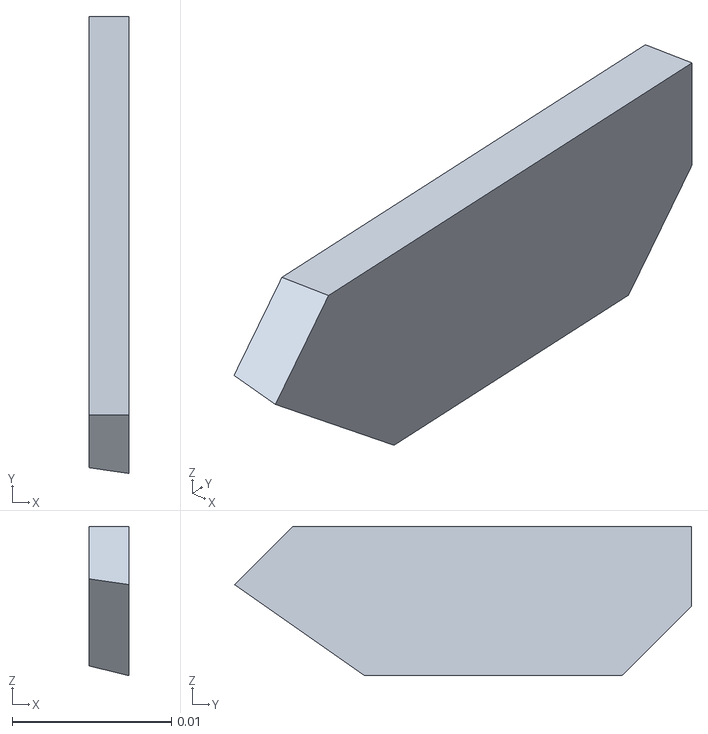
[picture p113: CAD file, 2026-10-27]
src/model/mjcf/assets/coll_tibia__configuration_right_03.stl
0.00251 x 0.0287 x 0.00937
