Rhoban/microban/src/model/mjcf/assets/foot__configuration_right_05.stl

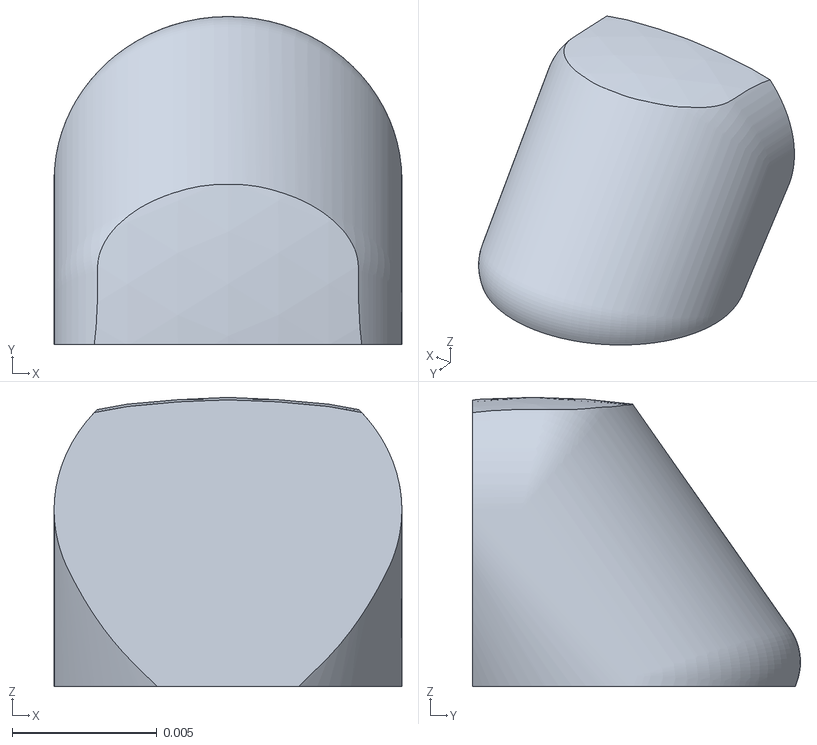
[picture p114: CAD file, 2026-10-27]
src/model/mjcf/assets/foot__configuration_right_05.stl
0.012 x 0.0113 x 0.00998
