Rhoban/microban/src/model/mjcf/assets/coll_shoulder_07.stl

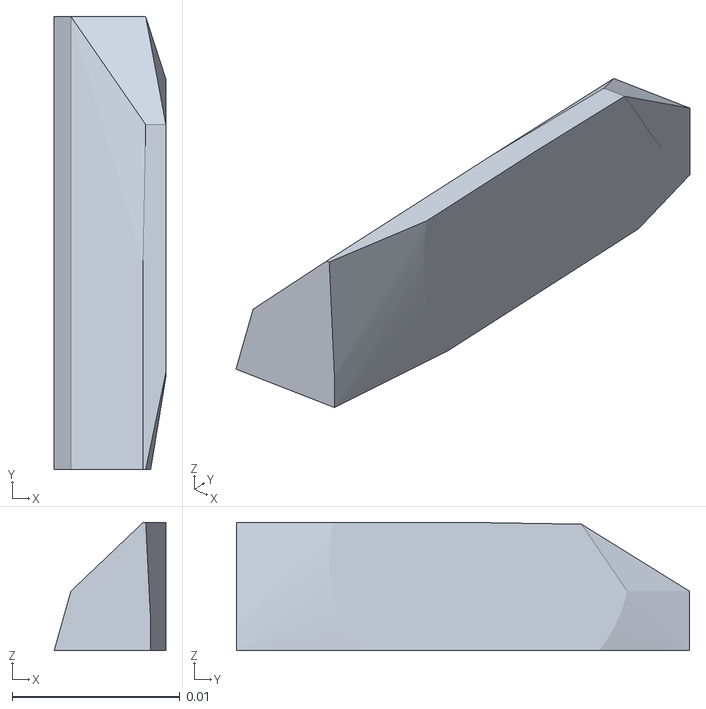
[picture p115: CAD file, 2026-10-27]
src/model/mjcf/assets/coll_shoulder_07.stl
0.00665 x 0.027 x 0.00763
