Rhoban/microban/src/model/mjcf/assets/foot__configuration_right_13.stl

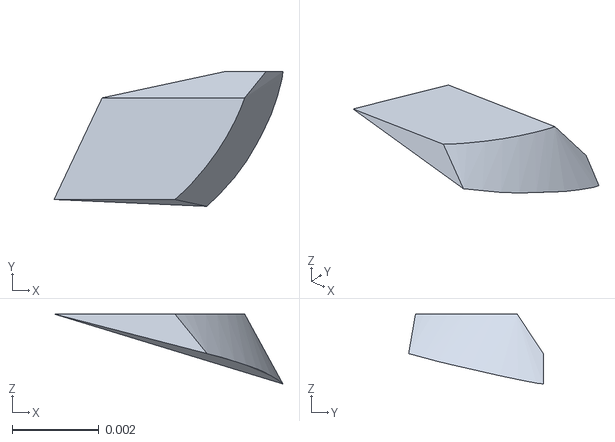
[picture p116: CAD file, 2026-10-27]
src/model/mjcf/assets/foot__configuration_right_13.stl
0.00528 x 0.00311 x 0.00161
