Rhoban/microban/src/model/mjcf/assets/radius_mirrored_18.stl

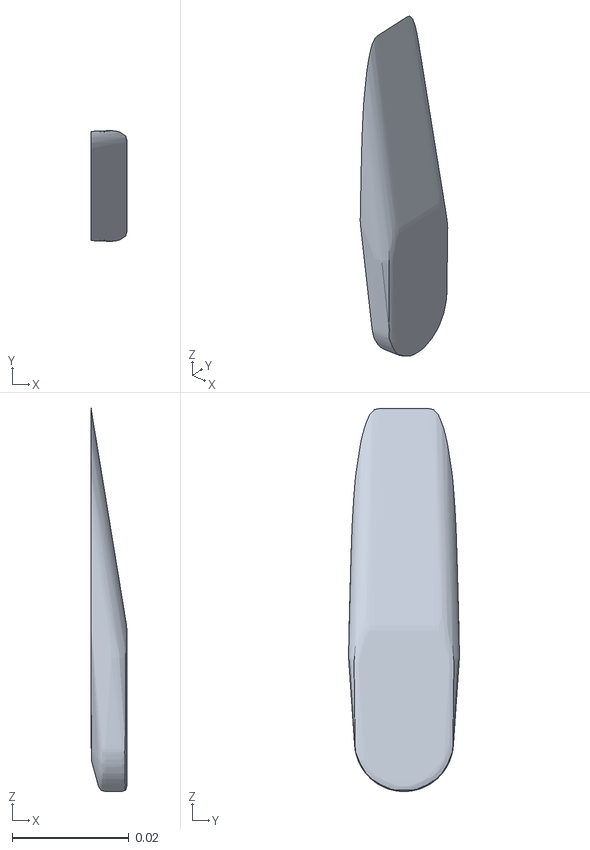
[picture p117: CAD file, 2026-10-27]
src/model/mjcf/assets/radius_mirrored_18.stl
0.00615 x 0.019 x 0.0656
