Rhoban/microban/src/model/mjcf/assets/coll_dc15_a01_horn_idle2_dummy_02.stl

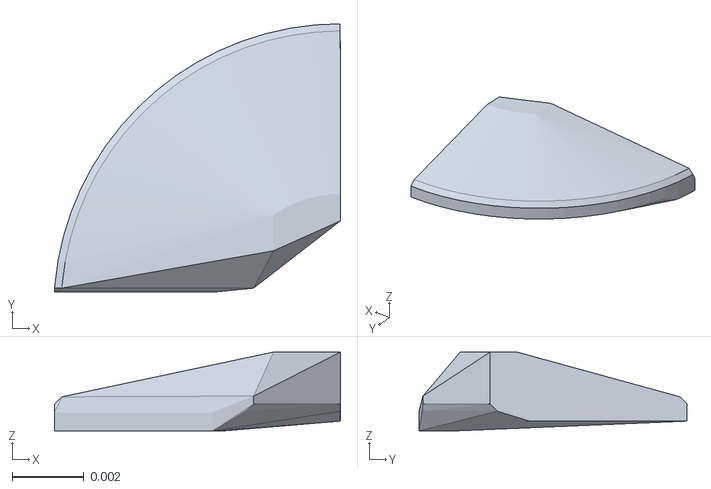
[picture p118: CAD file, 2026-10-27]
src/model/mjcf/assets/coll_dc15_a01_horn_idle2_dummy_02.stl
0.00798 x 0.00749 x 0.0022
