Rhoban/microban/src/model/mjcf/assets/foot__configuration_right_01.stl

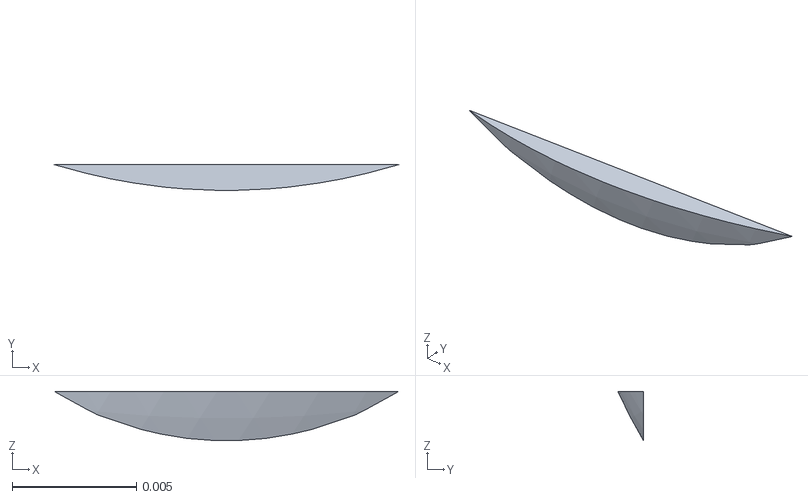
[picture p119: CAD file, 2026-10-27]
src/model/mjcf/assets/foot__configuration_right_01.stl
0.0138 x 0.00103 x 0.00198
