Rhoban/microban/src/model/mjcf/assets/coll_hip_dbl_block__configuration_right_06.stl

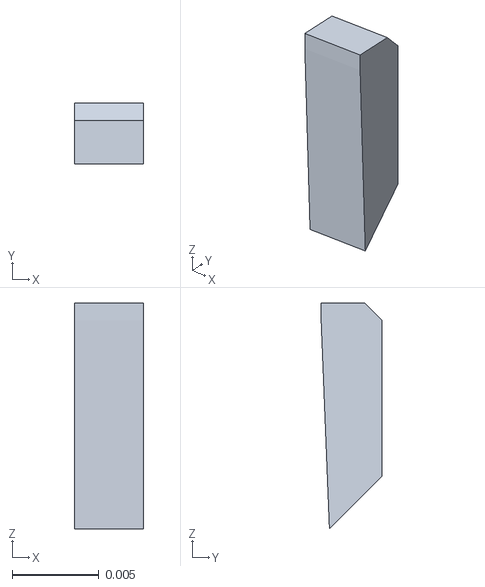
[picture p120: CAD file, 2026-10-27]
src/model/mjcf/assets/coll_hip_dbl_block__configuration_right_06.stl
0.00397 x 0.0035 x 0.013
