Rhoban/microban/src/model/mjcf/assets/coll_arm_bearing_support__configuration_right_04.stl

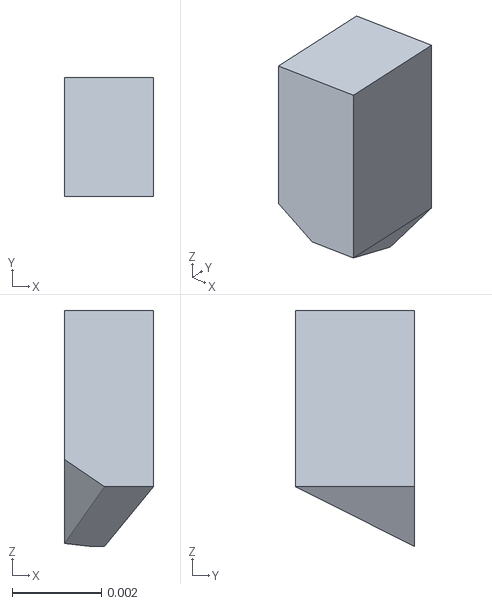
[picture p121: CAD file, 2026-10-27]
src/model/mjcf/assets/coll_arm_bearing_support__configuration_right_04.stl
0.002 x 0.00267 x 0.00529
