Rhoban/microban/src/model/mjcf/assets/coll_ankle_dbl_block__configuration_right_04.stl

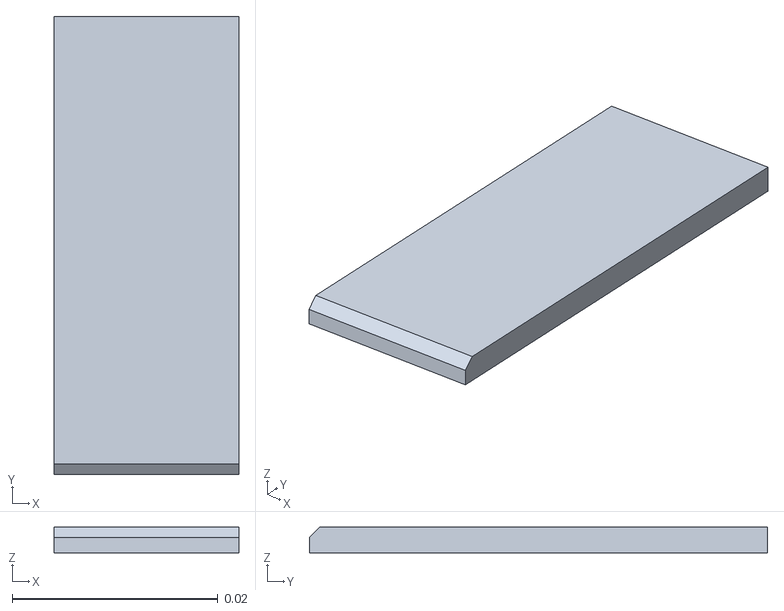
[picture p123: CAD file, 2026-10-27]
src/model/mjcf/assets/coll_ankle_dbl_block__configuration_right_04.stl
0.018 x 0.0445 x 0.00251
