Rhoban/microban/src/model/mjcf/assets/coll_tibia__configuration_left_05.stl

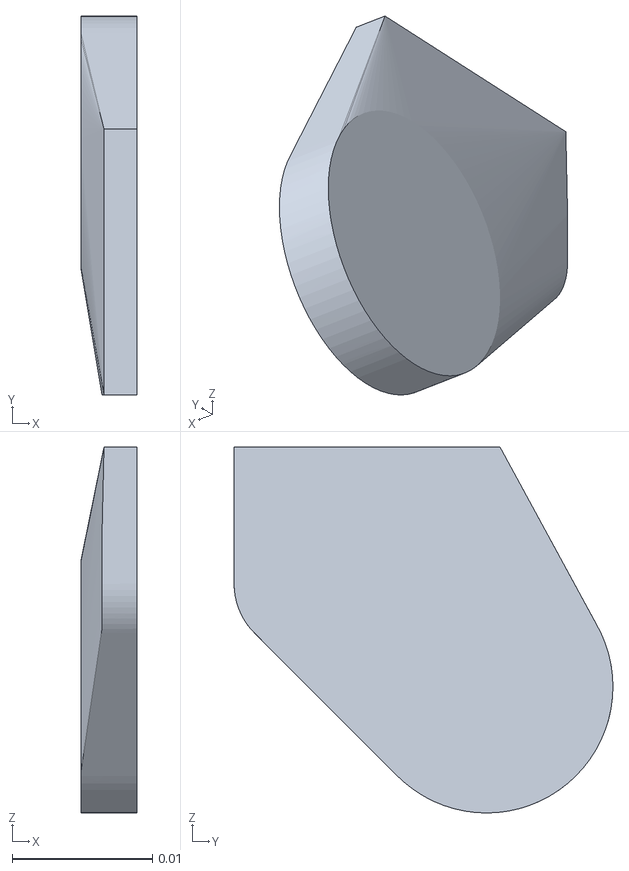
[picture p124: CAD file, 2026-10-27]
src/model/mjcf/assets/coll_tibia__configuration_left_05.stl
0.004 x 0.027 x 0.0261
