Rhoban/microban/src/model/mjcf/assets/coll_arm_bearing_support__configuration_right_07.stl

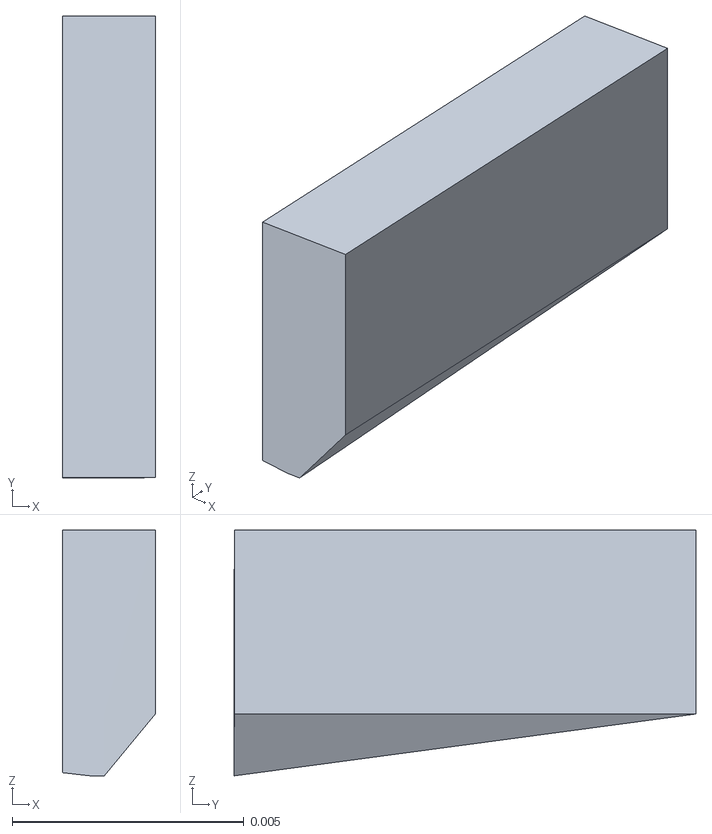
[picture p125: CAD file, 2026-10-27]
src/model/mjcf/assets/coll_arm_bearing_support__configuration_right_07.stl
0.002 x 0.00996 x 0.0053
