Rhoban/microban/src/model/mjcf/assets/foot__configuration_right_06.stl

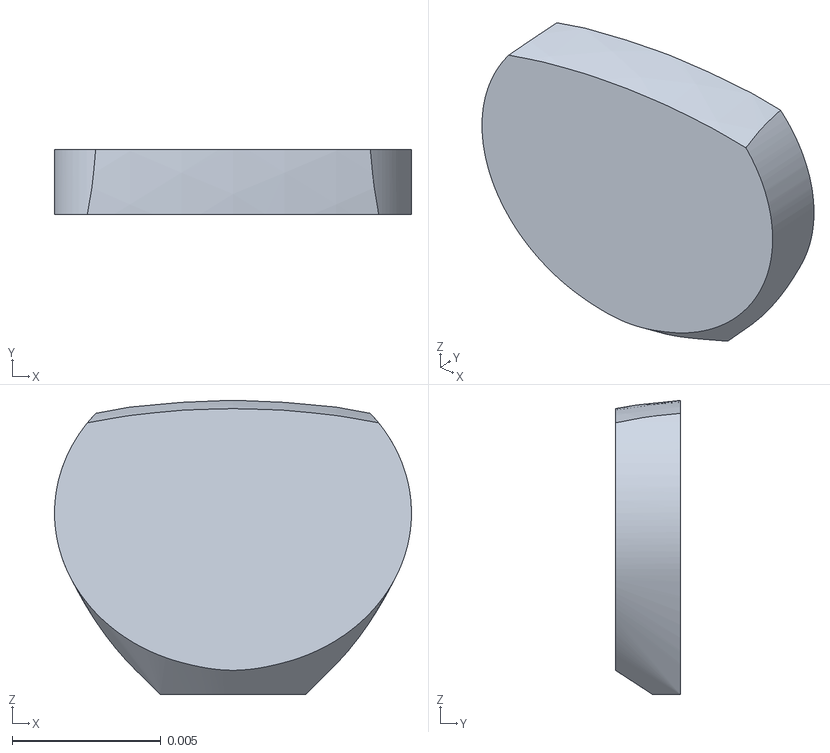
[picture p126: CAD file, 2026-10-27]
src/model/mjcf/assets/foot__configuration_right_06.stl
0.012 x 0.00219 x 0.00989
