Rhoban/microban/src/model/mjcf/assets/coll_shoulder_06.stl

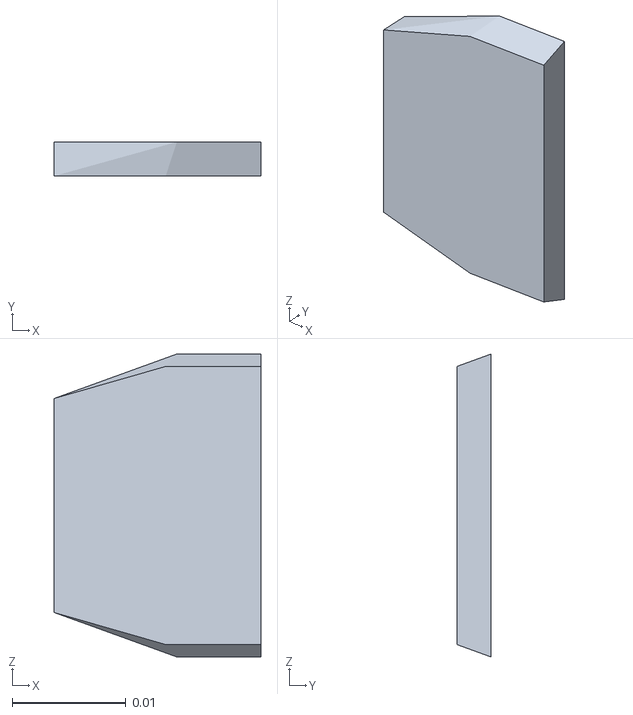
[picture p127: CAD file, 2026-10-27]
src/model/mjcf/assets/coll_shoulder_06.stl
0.0182 x 0.003 x 0.0267
