Rhoban/microban/src/model/mjcf/assets/coll_femur__configuration_left_10.stl

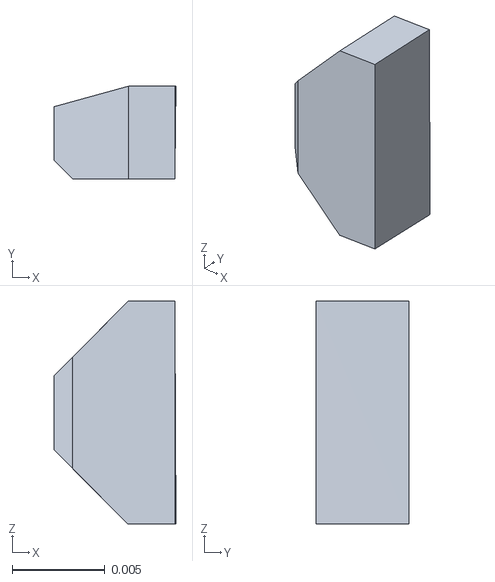
[picture p128: CAD file, 2026-10-27]
src/model/mjcf/assets/coll_femur__configuration_left_10.stl
0.00656 x 0.00498 x 0.012
