Rhoban/microban/src/model/mjcf/assets/coll_humerus_06.stl

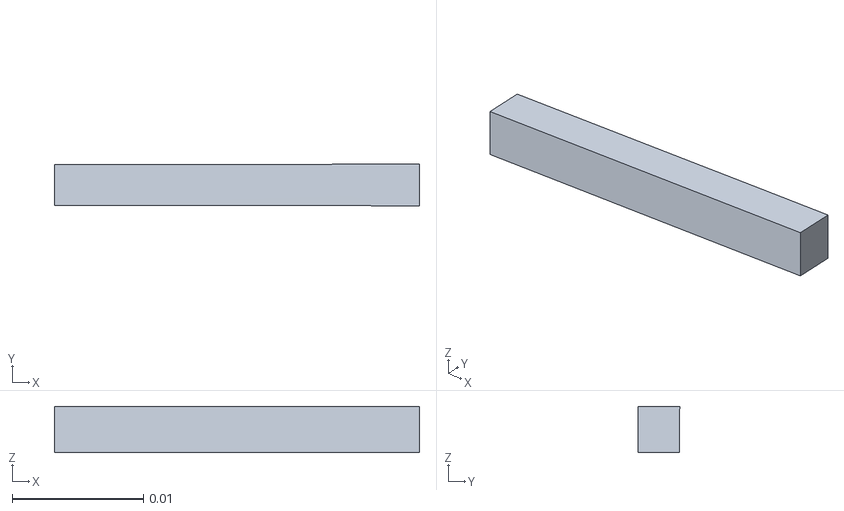
[picture p129: CAD file, 2026-10-27]
src/model/mjcf/assets/coll_humerus_06.stl
0.0278 x 0.00316 x 0.00352
