Rhoban/microban/src/model/mjcf/assets/coll_hip_dbl_block__configuration_right_09.stl

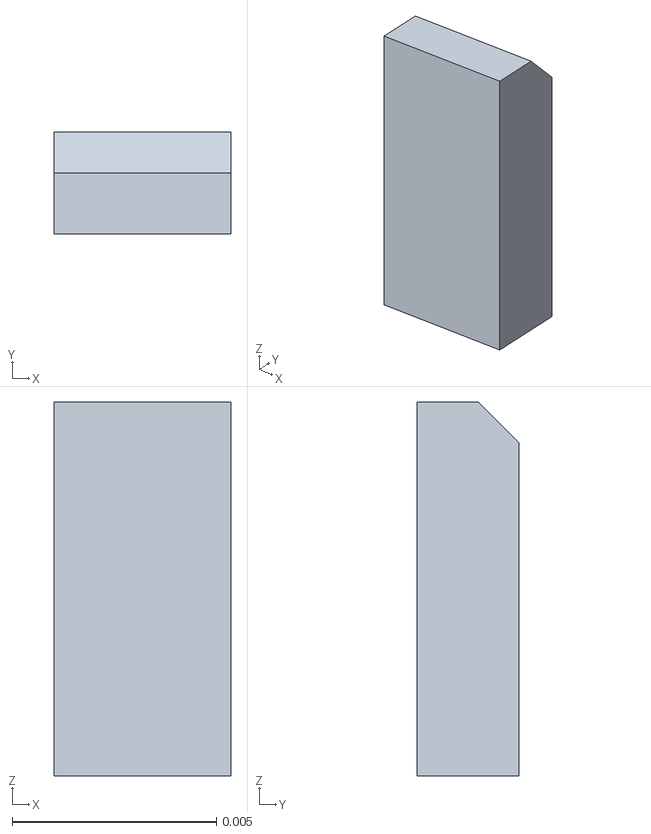
[picture p130: CAD file, 2026-10-27]
src/model/mjcf/assets/coll_hip_dbl_block__configuration_right_09.stl
0.00433 x 0.0025 x 0.00915
