Rhoban/microban/src/model/mjcf/assets/coll_femur__configuration_left_08.stl

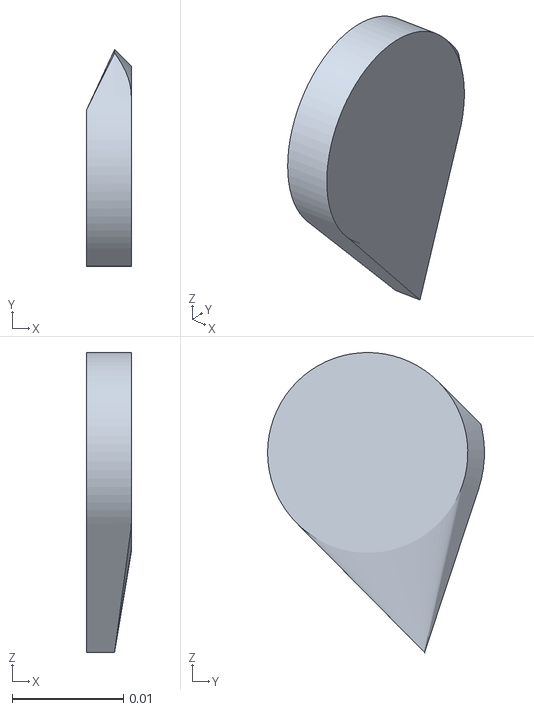
[picture p131: CAD file, 2026-10-27]
src/model/mjcf/assets/coll_femur__configuration_left_08.stl
0.004 x 0.0195 x 0.027
