Rhoban/microban/src/model/mjcf/assets/coll_humerus_08.stl

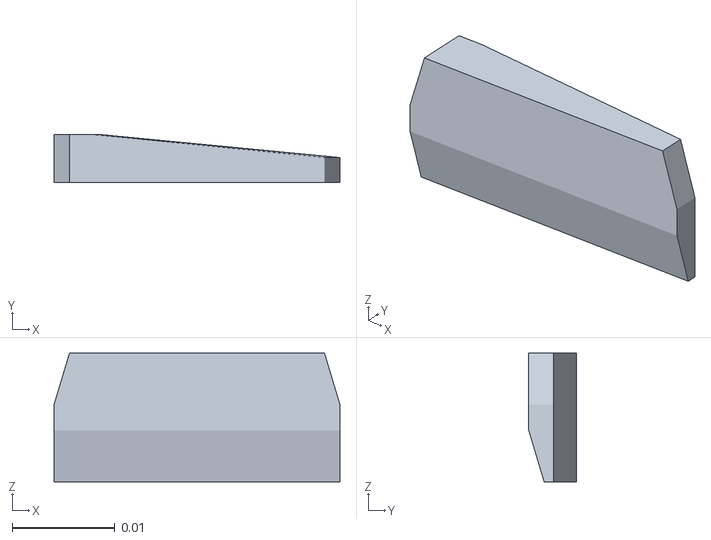
[picture p132: CAD file, 2026-10-27]
src/model/mjcf/assets/coll_humerus_08.stl
0.0278 x 0.00462 x 0.0125
