Rhoban/microban/src/model/mjcf/assets/radius_mirrored_04.stl

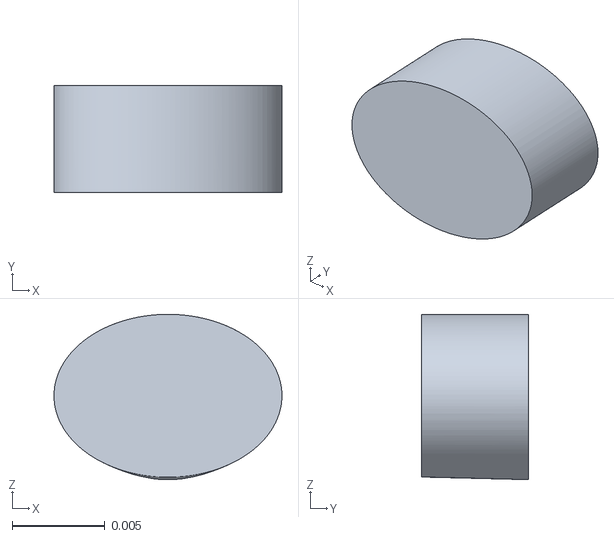
[picture p133: CAD file, 2026-10-27]
src/model/mjcf/assets/radius_mirrored_04.stl
0.0123 x 0.00574 x 0.0089
