Rhoban/microban/src/model/mjcf/assets/coll_femur__configuration_left_00.stl

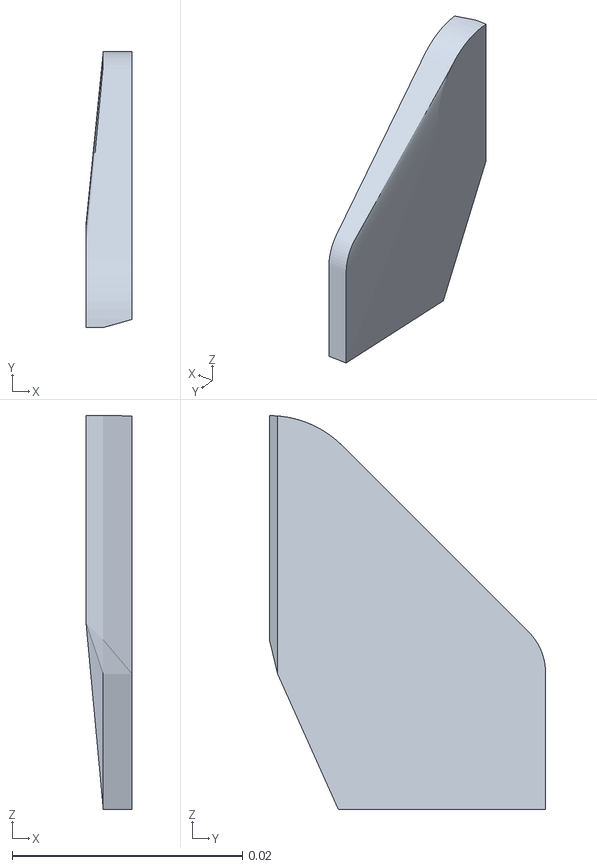
[picture p134: CAD file, 2026-10-27]
src/model/mjcf/assets/coll_femur__configuration_left_00.stl
0.004 x 0.024 x 0.0342
