Rhoban/microban/src/model/mjcf/assets/foot__configuration_right_20.stl

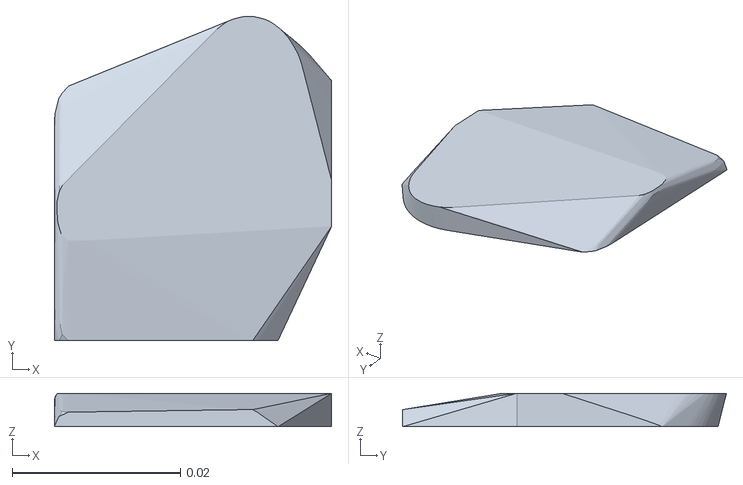
[picture p135: CAD file, 2026-10-27]
src/model/mjcf/assets/foot__configuration_right_20.stl
0.033 x 0.0385 x 0.00398
