Rhoban/microban/src/model/mjcf/assets/coll_tibia__configuration_right_09.stl

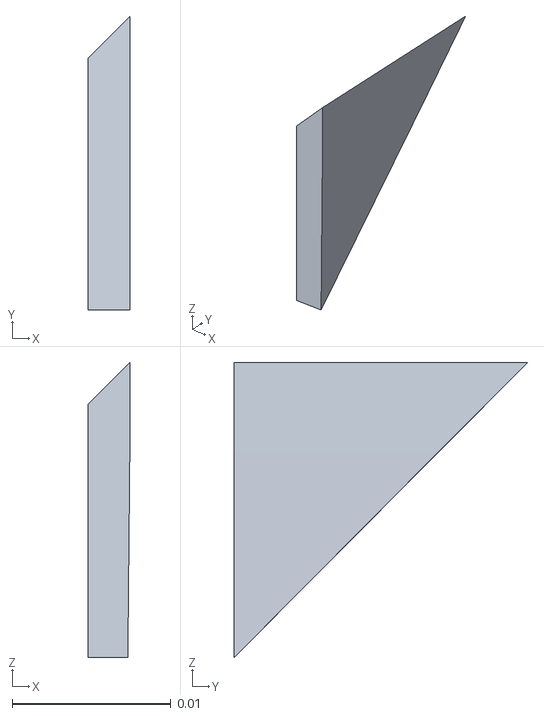
[picture p136: CAD file, 2026-10-27]
src/model/mjcf/assets/coll_tibia__configuration_right_09.stl
0.00263 x 0.0185 x 0.0186
