Rhoban/microban/src/model/mjcf/assets/coll_humerus_00.stl

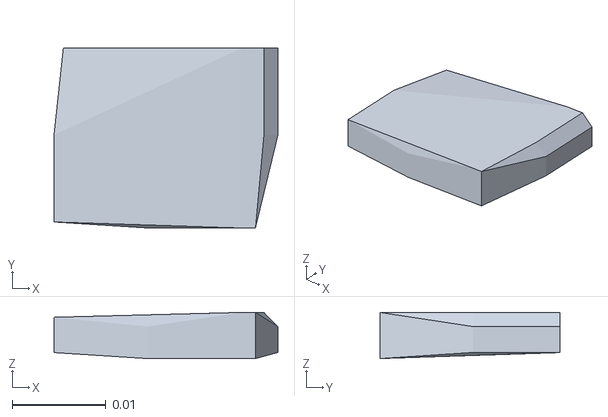
[picture p137: CAD file, 2026-10-27]
src/model/mjcf/assets/coll_humerus_00.stl
0.0239 x 0.0192 x 0.00492
