Rhoban/microban/src/model/mjcf/assets/radius_16.stl

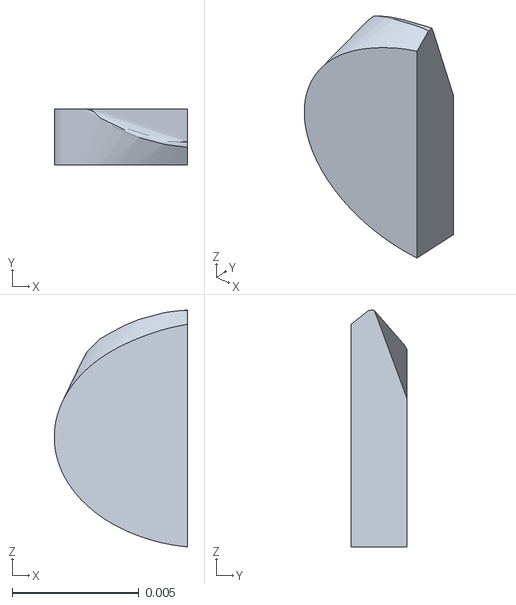
[picture p138: CAD file, 2026-10-27]
src/model/mjcf/assets/radius_16.stl
0.00527 x 0.0022 x 0.00936
