Rhoban/microban/src/model/mjcf/assets/foot__configuration_right_04.stl

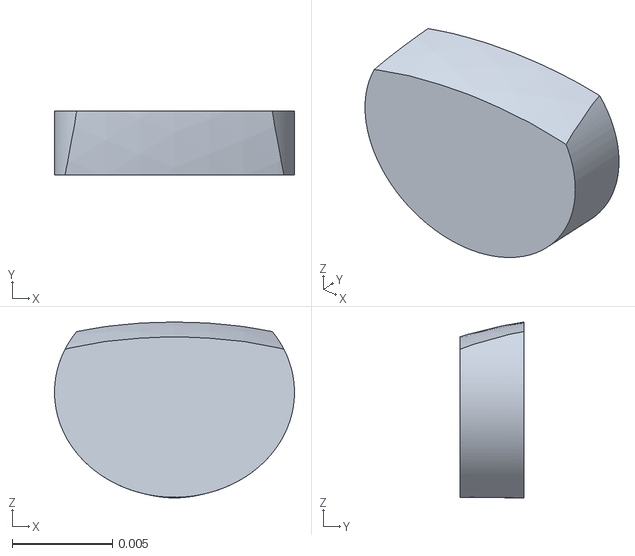
[picture p139: CAD file, 2026-10-27]
src/model/mjcf/assets/foot__configuration_right_04.stl
0.012 x 0.0032 x 0.0088
