Rhoban/microban/(list of files, cad)

Other CAD files:
model/mjcf/assets/tibia__configuration_left.stl
model/mjcf/assets/femur__configuration_left.stl
model/mjcf/assets/hip_dbl_block__configuration_right.stl
model/mjcf/assets/femur__configuration_right.stl
src/model/mjcf/assets/tibia__configuration_left.stl
model/mjcf/assets/tibia__configuration_right.stl
model/mjcf/assets/spacer__configuration_right.stl
src/model/mjcf/assets/radius.stl
model/mjcf/assets/arm_bearing_support__configuration_right.stl
src/model/mjcf/assets/coll_hip_dbl_block__configuration_left_02.stl
src/model/mjcf/assets/hip_dbl_block__configuration_right.stl
src/model/mjcf/assets/xl330.stl
src/model/mjcf/assets/dc15_a01_idle_cap_dummy.stl
src/model/mjcf/assets/radius_mirrored_20.stl
src/model/mjcf/assets/dc15_a01_horn_idle2_dummy.stl
src/model/mjcf/assets/femur__configuration_right.stl
src/model/mjcf/assets/shoulder.stl
model/mjcf/assets/ankle_dbl_block__configuration_right.scad
model/mjcf/assets/femur__configuration_left.scad
model/mjcf/assets/femur__configuration_right.scad
model/mjcf/assets/foot__configuration_right.scad
STL/foot.stl
cad/stl/board_spacer.stl
model/mjcf/assets/hip_dbl_block__configuration_left.scad
model/mjcf/assets/hip_dbl_block__configuration_right.scad
model/mjcf/assets/pelvis__configuration_right.scad
model/mjcf/assets/radius.scad
model/mjcf/assets/tibia__configuration_left.scad
model/mjcf/assets/tibia__configuration_right.scad
src/model/mjcf/assets/000_9.stl
src/model/mjcf/assets/ankle_dbl_block__configuration_right.stl
src/model/mjcf/assets/bts2_m2_6x8.stl
src/model/mjcf/assets/coll_ankle_dbl_block__configuration_right_00.stl
src/model/mjcf/assets/coll_ankle_dbl_block__configuration_right_01.stl
src/model/mjcf/assets/coll_ankle_dbl_block__configuration_right_02.stl
src/model/mjcf/assets/coll_ankle_dbl_block__configuration_right_03.stl
src/model/mjcf/assets/coll_ankle_dbl_block__configuration_right_05.stl
src/model/mjcf/assets/coll_ankle_dbl_block__configuration_right_07.stl
src/model/mjcf/assets/coll_ankle_dbl_block__configuration_right_09.stl
src/model/mjcf/assets/coll_ankle_dbl_block__configuration_right_10.stl
src/model/mjcf/assets/coll_arm_bearing_support__configuration_right_01.stl
src/model/mjcf/assets/coll_arm_bearing_support__configuration_right_02.stl
src/model/mjcf/assets/coll_arm_bearing_support__configuration_right_03.stl
src/model/mjcf/assets/coll_arm_bearing_support__configuration_right_05.stl
src/model/mjcf/assets/coll_arm_bearing_support__configuration_right_06.stl
src/model/mjcf/assets/coll_arm_bearing_support__configuration_right_11.stl
src/model/mjcf/assets/coll_dc15_a01_horn_idle2_dummy_00.stl
src/model/mjcf/assets/coll_dc15_a01_horn_idle2_dummy_05.stl
src/model/mjcf/assets/coll_dc15_a01_horn_idle2_dummy_07.stl
src/model/mjcf/assets/coll_dc15_a01_horn_idle2_dummy_09.stl
src/model/mjcf/assets/coll_dc15_a01_horn_idle2_dummy_11.stl
src/model/mjcf/assets/coll_femur__configuration_left_03.stl
src/model/mjcf/assets/coll_femur__configuration_left_04.stl
src/model/mjcf/assets/coll_femur__configuration_left_09.stl
src/model/mjcf/assets/coll_femur__configuration_right_00.stl
src/model/mjcf/assets/coll_femur__configuration_right_01.stl
src/model/mjcf/assets/coll_femur__configuration_right_02.stl
src/model/mjcf/assets/coll_femur__configuration_right_03.stl
src/model/mjcf/assets/coll_femur__configuration_right_04.stl
src/model/mjcf/assets/coll_femur__configuration_right_05.stl
src/model/mjcf/assets/coll_femur__configuration_right_08.stl
src/model/mjcf/assets/coll_femur__configuration_right_09.stl
src/model/mjcf/assets/coll_femur__configuration_right_10.stl
src/model/mjcf/assets/coll_femur__configuration_right_11.stl
src/model/mjcf/assets/coll_hip__configuration_right_00.stl
src/model/mjcf/assets/coll_hip__configuration_right_02.stl
src/model/mjcf/assets/coll_hip__configuration_right_04.stl
src/model/mjcf/assets/coll_hip__configuration_right_05.stl
src/model/mjcf/assets/coll_hip__configuration_right_08.stl
src/model/mjcf/assets/coll_hip__configuration_right_09.stl
src/model/mjcf/assets/coll_hip__configuration_right_10.stl
src/model/mjcf/assets/coll_hip_dbl_block__configuration_left_00.stl
src/model/mjcf/assets/coll_hip_dbl_block__configuration_left_03.stl
src/model/mjcf/assets/coll_hip_dbl_block__configuration_left_05.stl
src/model/mjcf/assets/coll_hip_dbl_block__configuration_left_06.stl
src/model/mjcf/assets/coll_hip_dbl_block__configuration_left_07.stl
src/model/mjcf/assets/coll_hip_dbl_block__configuration_left_08.stl
src/model/mjcf/assets/coll_hip_dbl_block__configuration_left_09.stl
src/model/mjcf/assets/coll_hip_dbl_block__configuration_left_10.stl
src/model/mjcf/assets/coll_hip_dbl_block__configuration_left_11.stl
src/model/mjcf/assets/coll_hip_dbl_block__configuration_right_01.stl
src/model/mjcf/assets/coll_hip_dbl_block__configuration_right_02.stl
src/model/mjcf/assets/coll_hip_dbl_block__configuration_right_03.stl
src/model/mjcf/assets/coll_hip_dbl_block__configuration_right_05.stl
src/model/mjcf/assets/coll_hip_dbl_block__configuration_right_10.stl
src/model/mjcf/assets/coll_hip_dbl_block__configuration_right_11.stl
src/model/mjcf/assets/coll_humerus_01.stl
src/model/mjcf/assets/coll_humerus_02.stl
src/model/mjcf/assets/coll_humerus_03.stl
src/model/mjcf/assets/coll_humerus_04.stl
src/model/mjcf/assets/coll_humerus_05.stl
src/model/mjcf/assets/coll_humerus_09.stl
src/model/mjcf/assets/coll_humerus_10.stl
src/model/mjcf/assets/coll_humerus_11.stl
src/model/mjcf/assets/coll_shoulder_01.stl
src/model/mjcf/assets/coll_shoulder_02.stl
src/model/mjcf/assets/coll_shoulder_03.stl
src/model/mjcf/assets/coll_shoulder_05.stl
src/model/mjcf/assets/coll_spacer__configuration_right_02.stl
src/model/mjcf/assets/coll_tibia__configuration_left_01.stl
src/model/mjcf/assets/coll_tibia__configuration_left_03.stl
src/model/mjcf/assets/coll_tibia__configuration_left_04.stl
src/model/mjcf/assets/coll_tibia__configuration_left_06.stl
src/model/mjcf/assets/coll_tibia__configuration_left_07.stl
src/model/mjcf/assets/coll_tibia__configuration_left_10.stl
src/model/mjcf/assets/coll_tibia__configuration_left_11.stl
src/model/mjcf/assets/coll_tibia__configuration_right_00.stl
src/model/mjcf/assets/coll_tibia__configuration_right_01.stl
src/model/mjcf/assets/coll_tibia__configuration_right_04.stl
src/model/mjcf/assets/coll_tibia__configuration_right_06.stl
src/model/mjcf/assets/foot__configuration_right_00.stl
src/model/mjcf/assets/foot__configuration_right_02.stl
src/model/mjcf/assets/foot__configuration_right_03.stl
src/model/mjcf/assets/foot__configuration_right_07.stl
src/model/mjcf/assets/foot__configuration_right_08.stl
src/model/mjcf/assets/foot__configuration_right_10.stl
src/model/mjcf/assets/foot__configuration_right_11.stl
src/model/mjcf/assets/foot__configuration_right_12.stl
src/model/mjcf/assets/foot__configuration_right_14.stl
src/model/mjcf/assets/foot__configuration_right_15.stl
src/model/mjcf/assets/foot__configuration_right_18.stl
src/model/mjcf/assets/foot__configuration_right_19.stl
src/model/mjcf/assets/foot__configuration_right_22.stl
src/model/mjcf/assets/foot__configuration_right_23.stl
src/model/mjcf/assets/hip_dbl_block__configuration_left.stl
src/model/mjcf/assets/hull_chest__configuration_right.stl
src/model/mjcf/assets/hull_pelvis__configuration_right.stl
src/model/mjcf/assets/humerus.stl
src/model/mjcf/assets/radius_02.stl
src/model/mjcf/assets/radius_03.stl
src/model/mjcf/assets/radius_06.stl
src/model/mjcf/assets/radius_07.stl
src/model/mjcf/assets/radius_09.stl
src/model/mjcf/assets/radius_10.stl
src/model/mjcf/assets/radius_11.stl
src/model/mjcf/assets/radius_12.stl
src/model/mjcf/assets/radius_13.stl
src/model/mjcf/assets/radius_14.stl
src/model/mjcf/assets/radius_18.stl
src/model/mjcf/assets/radius_mirrored_00.stl
src/model/mjcf/assets/radius_mirrored_03.stl
src/model/mjcf/assets/radius_mirrored_05.stl
src/model/mjcf/assets/radius_mirrored_07.stl
src/model/mjcf/assets/radius_mirrored_09.stl
src/model/mjcf/assets/radius_mirrored_11.stl
src/model/mjcf/assets/radius_mirrored_12.stl
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
