Rhoban/microban/src/model/mjcf/robot.xml

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
<mujoco model="microban">
  <compiler angle="radian" meshdir="assets" />
  <default>
    <default class="microban">
      <joint frictionloss="0.1" armature="0.005" />
      <position kp="50" dampratio="1" />
      <default class="visual">
        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
      </default>
      <default class="collision">
        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
      </default>
    </default>
    <default class="xl330">
      <joint damping="0.041" frictionloss="0.013" armature="0.0018" />
      <motor gear="1" />
    </default>
  </default>
  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
  <worldbody>
    <body name="trunk" childclass="microban">
      <inertial pos="-0.00428655 -0.000799412 0.0554008" quat="0.999654 0.0256053 0.00225998 -0.00558258" mass="0.283162" diaginertia="0.000608094 0.000437061 0.000356941" />
      <joint name="trunk_freejoint" type="free" armature="0" frictionloss="0" />
      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
      <body name="head" pos="0.00195835 0 0.126" quat="0.707107 0 0 0.707107">
        <inertial pos="3.6986e-08 -0.00238622 0.0210192" quat="0.109174 0.698629 0.109184 0.698626" mass="0.0169699" diaginertia="6.95892e-06 6.27221e-06 5.11543e-06" />
        <joint name="head" class="xl330" pos="0 0 0" axis="0 0 1" range="-1.5708 1.5708" />
        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
      </body>
      <body name="shoulder" pos="0 -0.0505 0.081" quat="0.500000155 -0.500000155 0.500000155 0.500000155">
        <inertial pos="2.521e-09 -3.76e-10 -0.00904957" quat="0.707107 0.707107 0 0" mass="0.0100298" diaginertia="2.08008e-06 2.07522e-06 1.18852e-06" />
        <joint name="right_shoulder_pitch" class="xl330" pos="0 0 0" axis="0 0 1" range="-3.14159 3.14159" />
        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
        <body name="humerus__configuration_right" pos="0 -0.0145 -0.0195" quat="0.5 0.5 -0.5 0.5">
          <inertial pos="-0.000302207 -0.0252901 -0.0143945" quat="0.704997 0.70912 -0.00625415 -0.00943713" mass="0.042744" diaginertia="1.78192e-05 1.77086e-05 4.16556e-06" />
          <joint name="right_shoulder_roll" class="xl330" pos="0 0 0" axis="0 0 1" range="-3.14159 0" />
          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
          <body name="radius" pos="-0.0145 -0.0515 -0.0145" quat="0.707107 0 0.707107 0">
            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
            <joint name="right_elbow" class="xl330" pos="0 0 0" axis="0 0 1" range="-2.18166 2.18166" />
            <inertial pos="-4.0628e-08 -0.0310611 0.0130165" mass="0.0115415" fullinertia="5.26775e-06 1.21602e-06 4.45903e-06 -4e-12 -1.2e-11 1.7157e-07" />
            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
          </body>
        </body>
      </body>
      <body name="hip" pos="0 -0.036 0">
        <inertial pos="0.00431847 1.31382e-07 -0.0100454" quat="0.483392 0.51607 0.516078 0.483392" mass="0.00988978" diaginertia="5.07896e-06 4.69308e-06 1.0731e-06" />
        <joint name="right_hip_yaw" class="xl330" pos="0 0 0" axis="0 0 1" range="-4.18879 1.0472" />
        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
        <body name="hip_block__configuration_right" pos="-0.02 0 -0.0214" quat="0.5 -0.5 0.5 -0.5">
          <inertial pos="-5.665e-05 0.0100355 0.0271424" quat="0.998264 0.0587172 -0.00449728 -0.000333424" mass="0.048423" diaginertia="1.67949e-05 1.37385e-05 7.99365e-06" />
          <joint name="right_hip_roll" class="xl330" pos="0 0 0" axis="0 0 1" range="-0.610865 0.610865" />
          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
          <body name="femur__configuration_right" pos="-0.0145 0 0.0385" quat="0 0.707107 0 -0.707107">
            <inertial pos="-0.0102168 -0.0361932 -0.014685" quat="0.704657 0.705388 -0.0542943 -0.0542169" mass="0.0161197" diaginertia="1.32375e-05 1.04908e-05 4.67239e-06" />
            <joint name="right_hip_pitch" class="xl330" pos="0 0 0" axis="0 0 1" range="-1.5708 1.5708" />
            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
            <body name="tibia__configuration_right" pos="-0.005 -0.062 0">
              <inertial pos="0.00283278 -0.0206415 -0.0144636" quat="0.69732 0.709504 0.0646132 0.0785741" mass="0.0312719" diaginertia="1.7334e-05 1.51199e-05 5.16432e-06" />
              <joint name="right_knee" class="xl330" pos="0 0 0" axis="0 0 1" range="-0.785398 2.35619" />
              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
              <body name="ankle_block__configuration_left" pos="0.008 -0.0612131 0" quat="0 0 0 1">
                <inertial pos="-0.0110817 -0.0100083 -0.0144031" quat="-0.0403529 0.703887 0.0397911 0.708048" mass="0.048013" diaginertia="1.64861e-05 1.34043e-05 7.98523e-06" />
                <joint name="right_ankle_pitch" class="xl330" pos="0 0 0" axis="0 0 1" range="-1.5708 0.610865" />
                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
                <body name="foot" pos="-0.0385 0 -0.0145" quat="0 -0.707107 0 -0.707107">
                  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
                  <joint name="right_ankle_roll" class="xl330" pos="0 0 0" axis="0 0 1" range="-0.610865 0.610865" />
                  <inertial pos="-0 -0.0168869 0.0347422" mass="0.016823" fullinertia="1.15605e-05 1.2167e-05 2.53496e-06 0 -0 5.67932e-07" />
                  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
                </body>
              </body>
            </body>
          </body>
        </body>
      </body>
      <body name="shoulder_2" pos="0 0.0505 0.081" quat="-0.500000155 0.500000155 0.500000155 0.500000155">
        <inertial pos="2.521e-09 3.76e-10 0.00904957" quat="0.707107 0.707107 0 0" mass="0.0100298" diaginertia="2.08008e-06 2.07522e-06 1.18852e-06" />
        <joint name="left_shoulder_pitch" class="xl330" pos="0 0 0" axis="0 0 1" range="-3.14159 3.14159" />
        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
        <body name="humerus__configuration_left" pos="0 0.0145 0.0195" quat="0.5 -0.5 0.5 0.5">
          <inertial pos="-0.000305532 0.0252901 -0.0143912" quat="0.70901 0.705093 0.00412479 0.011517" mass="0.042744" diaginertia="1.78192e-05 1.77084e-05 4.16552e-06" />
          <joint name="left_shoulder_roll" class="xl330" pos="0 0 0" axis="0 0 1" range="0 3.14159" />
          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
          <body name="radius_2" pos="-0.0145 0.0515 -0.0145" quat="0.707107 0 -0.707107 0">
            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
            <joint name="left_elbow" class="xl330" pos="0 0 0" axis="0 0 1" range="-2.18166 2.18166" />
            <inertial pos="-4.0628e-08 0.0310611 -0.0130165" mass="0.0115415" fullinertia="5.26775e-06 1.21602e-06 4.45903e-06 4e-12 1.2e-11 1.7157e-07" />
            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
          </body>
        </body>
      </body>
      <body name="hip_2" pos="0 0.036 0" quat="0 0 0 1">
        <inertial pos="-0.00431847 -1.31382e-07 -0.0100454" quat="0.51607 0.483392 0.483392 0.516078" mass="0.00988978" diaginertia="5.07896e-06 4.69308e-06 1.0731e-06" />
        <joint name="left_hip_yaw" class="xl330" pos="0 0 0" axis="0 0 1" range="-1.0472 4.18879" />
        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
        <body name="hip_block__configuration_left" pos="0.02 0 -0.0214" quat="0.5 -0.5 -0.5 0.5">
          <inertial pos="5.95623e-05 0.0100355 0.0271453" quat="0.99827 0.0586309 0.00439496 0.000261144" mass="0.048423" diaginertia="1.67981e-05 1.37416e-05 7.99385e-06" />
          <joint name="left_hip_roll" class="xl330" pos="0 0 0" axis="0 0 1" range="-0.610865 0.610865" />
          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
          <body name="femur__configuration_left" pos="-0.0145 0 0.0385" quat="0.707107 0 -0.707107 0">
            <inertial pos="0.0102168 0.0361932 -0.014315" quat="0.704657 0.705388 -0.0542943 -0.0542169" mass="0.0161197" diaginertia="1.32375e-05 1.04908e-05 4.67239e-06" />
            <joint name="left_hip_pitch" class="xl330" pos="0 0 0" axis="0 0 1" range="-1.5708 1.5708" />
            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
            <body name="tibia__configuration_left" pos="0.005 0.062 0">
              <inertial pos="-0.00282824 0.0206415 -0.0145364" quat="0.697295 0.70952 0.0645051 0.0787366" mass="0.0312719" diaginertia="1.73344e-05 1.51206e-05 5.16474e-06" />
              <joint name="left_knee" class="xl330" pos="0 0 0" axis="0 0 1" range="-0.785398 2.35619" />
              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
              <body name="ankle_block__configuration_right" pos="-0.008 0.0612131 0" quat="0 0 0 -1">
                <inertial pos="0.0110847 0.0100083 -0.0145939" quat="-0.0404692 0.703806 0.0398037 0.708121" mass="0.048013" diaginertia="1.64829e-05 1.34013e-05 7.98505e-06" />
                <joint name="left_ankle_pitch" class="xl330" pos="0 0 0" axis="0 0 1" range="-1.5708 0.610865" />
                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
                <body name="foot_2" pos="0.0385 0 -0.0145" quat="0.707107 0 -0.707107 0">
                  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
                  <joint name="left_ankle_roll" class="xl330" pos="0 0 0" axis="0 0 1" range="-0.610865 0.610865" />
                  <inertial pos="-0 -0.0168869 0.0347422" mass="0.016823" fullinertia="1.15605e-05 1.2167e-05 2.53496e-06 0 -0 5.67932e-07" />
                  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
                </body>
              </body>
            </body>
          </body>
        </body>
      </body>
    </body>
  </worldbody>
  <actuator>
    <motor class="xl330" name="head" joint="head" />
    <motor class="xl330" name="right_shoulder_pitch" joint="right_shoulder_pitch" />
    <motor class="xl330" name="right_shoulder_roll" joint="right_shoulder_roll" />
    <motor class="xl330" name="right_elbow" joint="right_elbow" />
    <motor class="xl330" name="right_hip_yaw" joint="right_hip_yaw" />
    <motor class="xl330" name="right_hip_roll" joint="right_hip_roll" />
    <motor class="xl330" name="right_hip_pitch" joint="right_hip_pitch" />
    <motor class="xl330" name="right_knee" joint="right_knee" />
    <motor class="xl330" name="right_ankle_pitch" joint="right_ankle_pitch" />
    <motor class="xl330" name="right_ankle_roll" joint="right_ankle_roll" />
    <motor class="xl330" name="left_shoulder_pitch" joint="left_shoulder_pitch" />
    <motor class="xl330" name="left_shoulder_roll" joint="left_shoulder_roll" />
    <motor class="xl330" name="left_elbow" joint="left_elbow" />
    <motor class="xl330" name="left_hip_yaw" joint="left_hip_yaw" />
    <motor class="xl330" name="left_hip_roll" joint="left_hip_roll" />
    <motor class="xl330" name="left_hip_pitch" joint="left_hip_pitch" />
    <motor class="xl330" name="left_knee" joint="left_knee" />
    <motor class="xl330" name="left_ankle_pitch" joint="left_ankle_pitch" />
    <motor class="xl330" name="left_ankle_roll" joint="left_ankle_roll" />
  </actuator>
  <sensor>
    <framequat objtype="site" objname="imu" name="orientation" noise="0.001" />
    <gyro site="imu" name="angular-velocity" noise="0.005" />
    <gyro site="imu" name="imu_ang_vel" />
    <velocimeter site="imu" name="imu_lin_vel" />
    <accelerometer site="imu" name="imu_accel" />
    <subtreeangmom body="trunk" name="root_angmom" />
  </sensor>
</mujoco>
