Rhoban/microban/src/sim/mujoco_controller.py

# SPDX-License-Identifier: GPL-3.0-or-later
# Copyright 2026 Marc Duclusaud

import time
from collections import deque
from collections.abc import Callable
from pathlib import Path
from typing import TYPE_CHECKING

import mujoco
import mujoco.viewer

from sim.scene import build_scene

if TYPE_CHECKING:
    from sim.mujoco_input import MuJoCoInputSource

from bam.model import load_model as bam_load_model
from bam.mujoco import MujocoController as BamController

from constants import MOTOR_TO_ID, ID_TO_MOTOR, NEUTRAL_POSE, KP_DEFAULT, BAM_VIN, BAM_VIN_DROP_RESISTANCE, BAM_VIN_MIN, BAM_MAX_CURRENT


class _DelayBuffer:
    """Returns values delayed by n_steps ticks (0 = no delay)."""

    def __init__(self, initial, n_steps: int) -> None:
        size = max(1, n_steps + 1)
        self._buf: deque = deque([initial] * size, maxlen=size)

    def push_and_read(self, value):
        self._buf.appendleft(value)
        return self._buf[-1]

    def fill(self, value) -> None:
        for i in range(len(self._buf)):
            self._buf[i] = value


class MuJoCoController:
    """MuJoCo-backed controller."""

    def __init__(
        self,
        mjcf_path: str | None = None,
        climb: bool = False,
        key_callback: Callable[[int, int, int, int], None] | None = None,
        stop_flag_path: str = "/tmp/microban_scheduler.stop",
        reset_source: "MuJoCoInputSource | None" = None,
        # Actuation delay (command → motor), in simulator steps (default timestep: 0.005 s)
        delay_act_steps: int = 0,
        # Sensor delays (motor/IMU → observation), in scheduler ticks (default: 0.02 s)
        delay_pos_ticks: int = 0,
        delay_vel_ticks: int = 0,
        delay_gyro_ticks: int = 0,
        delay_quat_ticks: int = 0,
        trunk_com_offset: tuple[float, float, float] = (0.0, 0.0, 0.0),
    ) -> None:
        self._stop_flag_path = Path(stop_flag_path)
        self._reset_source = reset_source
        # the robot from microban_model in its scene (sim/scene.py), or a scene of one's own
        self._model = mujoco.MjModel.from_xml_path(mjcf_path) if mjcf_path else build_scene(climb)
        self._data = mujoco.MjData(self._model)

        self._name_to_actuator_idx: dict[str, int] = {}
        self._name_to_qpos_idx: dict[str, int] = {}
        self._name_to_qvel_idx: dict[str, int] = {}
        for name in MOTOR_TO_ID:
            actuator_id = mujoco.mj_name2id(self._model, mujoco.mjtObj.mjOBJ_ACTUATOR, name)
            joint_id = mujoco.mj_name2id(self._model, mujoco.mjtObj.mjOBJ_JOINT, name)
            if actuator_id < 0:
                raise ValueError(f"Actuator '{name}' not found in MJCF model {mjcf_path!r}")
            if joint_id < 0:
                raise ValueError(f"Joint '{name}' not found in MJCF model {mjcf_path!r}")
            self._name_to_actuator_idx[name] = actuator_id
            self._name_to_qpos_idx[name] = self._model.jnt_qposadr[joint_id]
            self._name_to_qvel_idx[name] = self._model.jnt_dofadr[joint_id]
        # Number of physics sub-steps per scheduler tick (scheduler runs at 50 Hz)
        self._steps_per_tick = max(1, round(0.02 / self._model.opt.timestep))
        self._torque_interval = 0.1
        self._last_torque_print = 0.0

        # Apply CoM offset on trunk body (simulates inertial model error)
        if any(v != 0.0 for v in trunk_com_offset):
            trunk_id = mujoco.mj_name2id(self._model, mujoco.mjtObj.mjOBJ_BODY, "trunk")
            self._model.body_ipos[trunk_id, 0] += trunk_com_offset[0]
            self._model.body_ipos[trunk_id, 1] += trunk_com_offset[1]
            self._model.body_ipos[trunk_id, 2] += trunk_com_offset[2]

        # Set initial pose to neutral so the robot starts upright
        self._data.qpos[2] = 0.165
        for name, angle in NEUTRAL_POSE.items():
            if name in self._name_to_qpos_idx:
                self._data.qpos[self._name_to_qpos_idx[name]] = angle
        mujoco.mj_forward(self._model, self._data)

        # Delay buffers — simulate sensor/communication latency
        self._delay_pos = {
            mid: _DelayBuffer(
                self._data.qpos[self._name_to_qpos_idx[ID_TO_MOTOR[mid]]],
                delay_pos_ticks,
            )
            for mid in MOTOR_TO_ID.values()
        }
        self._delay_vel = {
            mid: _DelayBuffer(0.0, delay_vel_ticks)
            for mid in MOTOR_TO_ID.values()
        }
        self._delay_gyro = _DelayBuffer((0.0, 0.0, 0.0), delay_gyro_ticks)
        self._delay_quat = _DelayBuffer((1.0, 0.0, 0.0, 0.0), delay_quat_ticks)
        self._delay_act = {
            mid: _DelayBuffer(
                self._data.qpos[self._name_to_qpos_idx[ID_TO_MOTOR[mid]]],
                delay_act_steps,
            )
            for mid in MOTOR_TO_ID.values()
        }

        # BAM motor model — XL330 m6 (DC motor + Stribeck + load-dependent friction)
        bam_model = bam_load_model(motor_name="xl330", model="m6")
        bam_model.actuator.kp = KP_DEFAULT
        bam_model.actuator.vin = BAM_VIN
        bam_model.actuator.max_current = BAM_MAX_CURRENT   # firmware current limit (an actuator setting in BAM >= 1.0.2)
        self._bam = BamController(
            bam_model,
            list(MOTOR_TO_ID.keys()),
            self._model,
            self._data,
            vin_drop_resistance=BAM_VIN_DROP_RESISTANCE,
            vin_min=BAM_VIN_MIN,
        )
        self._reset_bam()
        self._torque_off: set[int] = set()            # actuators whose torque is off (sync_write_torque_enable)

        self._viewer = mujoco.viewer.launch_passive(
            self._model, self._data, key_callback=key_callback
        )

        # Sensor indices for IMU readout
        self._sensor_orientation = mujoco.mj_name2id(self._model, mujoco.mjtObj.mjOBJ_SENSOR, "orientation")
        self._sensor_gyro = mujoco.mj_name2id(self._model, mujoco.mjtObj.mjOBJ_SENSOR, "angular-velocity")

    def _reset_bam(self) -> None:
        """Clear BAM's controller state and hold every motor where it is (BAM >= 1.0.2: reset() no longer sets
        the targets)."""
        self._bam.reset()
        for name in MOTOR_TO_ID:
            self._bam.set_q_target(name, self._data.qpos[self._name_to_qpos_idx[name]])

    @property
    def viewer_opt(self) -> mujoco.MjvOption:
        return self._viewer.opt

    def set_kp(self, kp: float) -> None:
        self._bam.model.actuator.kp = kp

    def sync_read_kp(self, ids: list[int]) -> list[int]:
        kp = int(self._bam.model.actuator.kp)
        return [kp] * len(ids)

    def sync_write_kp(self, ids: list[int], gains: list[int]) -> None:
        self._bam.model.actuator.kp = gains[0]

    def sync_write_torque_enable(self, ids: list[int], values: list[bool]) -> None:
        for motor_id, on in zip(ids, values):
            (self._torque_off.discard if on else self._torque_off.add)(self._model.actuator(ID_TO_MOTOR[motor_id]).id)

    def sync_write_status_return_level(self, ids: list[int], levels: list[int]) -> None:
        pass

    def sync_write_goal_position(self, ids: list[int], positions: list[float]) -> None:
        if not self._viewer.is_running():
            self._stop_flag_path.write_text("stop\n", encoding="ascii")
            return

        cmd = dict(zip(ids, positions))

        for _ in range(self._steps_per_tick):
            for motor_id, pos in cmd.items():
                delayed_pos = self._delay_act[motor_id].push_and_read(pos)
                self._bam.set_q_target(ID_TO_MOTOR[motor_id], delayed_pos)
            self._bam.update()
            for act in self._torque_off:              # torque off: no motor torque (BAM's frictions stay)
                self._data.ctrl[act] = 0.0
            mujoco.mj_step(self._model, self._data)

        if self._reset_source is not None and self._reset_source.consume_reset():
            self.reset()
            return

        if self._reset_source is not None and self._reset_source.show_torque:
            now = time.monotonic()
            if now - self._last_torque_print >= self._torque_interval:
                total = float(sum(abs(f) for f in self._data.actuator_force))
                print(f"Torque sum: {total:.3f} Nm")
                self._last_torque_print = now

        self._viewer.sync()

    def sync_read_present_position(self, ids: list[int]) -> list[float]:
        return [
            self._delay_pos[mid].push_and_read(
                self._data.qpos[self._name_to_qpos_idx[ID_TO_MOTOR[mid]]]
            )
            for mid in ids
        ]

    def read_present_position(self, motor_id: int) -> float:
        name = ID_TO_MOTOR[motor_id]
        return float(self._delay_pos[motor_id].push_and_read(
            self._data.qpos[self._name_to_qpos_idx[name]]
        ))

    def sync_read_present_velocity(self, ids: list[int]) -> list[float]:
        return [
            self._delay_vel[mid].push_and_read(
                self._data.qvel[self._name_to_qvel_idx[ID_TO_MOTOR[mid]]]
            )
            for mid in ids
        ]

    def read_present_velocity(self, motor_id: int) -> float:
        name = ID_TO_MOTOR[motor_id]
        return float(self._delay_vel[motor_id].push_and_read(
            self._data.qvel[self._name_to_qvel_idx[name]]
        ))

    def sync_read_present_current(self, ids: list[int]) -> list[float]:
        # Motor current from the torque applied by the bam model: I = torque / kt.
        # ctrl holds the (current-clipped) torque set in MujocoController.update().
        kt = self._bam.model.kt.value
        return [
            float(self._data.ctrl[self._name_to_actuator_idx[ID_TO_MOTOR[mid]]] / kt)
            for mid in ids
        ]

    def sync_read_present_input_voltage(self, ids: list[int]) -> list[float]:
        return [80.0] * len(ids)

    def read_present_input_voltage(self, motor_id: int) -> float:
        return 80.0

    def read_acc(self) -> tuple[float, float, float]:
        """Return pseudo-accelerometer (ax, ay, az) in g from the 'orientation' sensor: what an accelerometer at rest
        reads, the world's up (0, 0, +1) g in the IMU frame (+1 g along the axis that points up)."""
        if self._sensor_orientation < 0:
            return 0.0, 0.0, 1.0
        adr = self._model.sensor_adr[self._sensor_orientation]
        w, x, y, z = self._data.sensordata[adr:adr + 4]
        # third row of the IMU's rotation matrix: the world z axis in the IMU frame
        ax = 2 * (x * z - w * y)
        ay = 2 * (y * z + w * x)
        az = w * w - x * x - y * y + z * z
        return float(ax), float(ay), float(az)

    def read_gyro(self) -> tuple[float, float, float]:
        if self._sensor_gyro < 0:
            current = (0.0, 0.0, 0.0)
        else:
            adr = self._model.sensor_adr[self._sensor_gyro]
            gx, gy, gz = self._data.sensordata[adr:adr + 3]
            current = (float(gx), float(gy), float(gz))
        return self._delay_gyro.push_and_read(current)

    def read_quat(self, dt: float) -> tuple[float, float, float, float]:
        if self._sensor_orientation < 0:
            current = (1.0, 0.0, 0.0, 0.0)
        else:
            adr = self._model.sensor_adr[self._sensor_orientation]
            w, x, y, z = self._data.sensordata[adr:adr + 4]
            current = (float(w), float(x), float(y), float(z))
        return self._delay_quat.push_and_read(current)

    def reset(self) -> None:
        """Reset the simulation to the initial neutral standing pose."""
        self._data.qpos[:] = 0.0
        self._data.qvel[:] = 0.0
        self._data.ctrl[:] = 0.0
        self._data.qpos[2] = 0.165
        for name, angle in NEUTRAL_POSE.items():
            if name in self._name_to_qpos_idx:
                self._data.qpos[self._name_to_qpos_idx[name]] = angle
        mujoco.mj_forward(self._model, self._data)
        self._reset_bam()
        for mid in MOTOR_TO_ID.values():
            neutral = self._data.qpos[self._name_to_qpos_idx[ID_TO_MOTOR[mid]]]
            self._delay_act[mid].fill(neutral)
        self._viewer.sync()
