Rhoban/microban/src/sim/sim_main.py

# SPDX-License-Identifier: GPL-3.0-or-later
# Copyright 2026 Marc Duclusaud

"""Local simulation entry point — never deployed to the robot: the robot's program on Rhoban's robot simulator
(microban_sim), the robot on the floor, or on the hackathon's climbing wall (climbing_sim). docs/simulation.md.

Usage:
    make sim                    # the classic robot on the floor (VARIANT=climber: the climbing one)
    make sim WALL=N2            # the climbing robot hanging on the hackathon's wall N2 (START=floor: in front of it)
"""

import argparse
import os

from constants import MOVE_KEYS
from scheduler import Scheduler
from telemetry import Telemetry
from moves.move import CLASSIC, CLIMBER
from sim.mujoco_input import MuJoCoInputSource
from sim.sim_controller import SimController
from moves.discover import all_moves


def main() -> None:
    parser = argparse.ArgumentParser(description="Run microban scheduler in MuJoCo simulation.")
    parser.add_argument("--hz", type=float, default=50.0, metavar="FREQ", help="Scheduler frequency in Hz (default: 50)")
    parser.add_argument("--variant", default=CLASSIC, choices=[CLASSIC, CLIMBER],
                        help="the robot's version on the floor: walking or climbing forearms and feet")
    parser.add_argument("--moves", default=None, metavar="FILE", help="the moves of a file kept outside src/moves/")
    parser.add_argument("--wall", default=None, metavar="WALL", help="on the hackathon's climbing wall (the simulator "
                        "cloned next to this folder): N1, N2, N3 or a wall JSON file; the climbing robot")
    parser.add_argument("--start", default="hang", choices=["hang", "floor"],
                        help="--wall: hanging on the start holds, or standing in front of the wall")
    parser.add_argument("--no-viewer", action="store_true",
                        help="no MuJoCo window (a slow OpenGL, e.g. WSL): watch and drive it from the dashboard")
    args = parser.parse_args()

    if args.wall:
        try:
            from climbing_sim import ClimbingSim
        except ModuleNotFoundError as e:
            if e.name != "climbing_sim":
                raise
            raise SystemExit("The hackathon's simulator is not found: clone it next to this folder (git clone "
                             "https://github.com/rock-climbing-robots/simulator ../simulator), see docs/simulation.md")
        except ImportError as e:      # the simulator is newer than the microban_sim installed here
            raise SystemExit(f"The hackathon's simulator does not load ({e}): update Rhoban's robot simulator here, "
                             "uv sync --group sim --upgrade-package microban-sim, then make sim again")
        sim = ClimbingSim(args.wall, cameras=[])
        start, variant = (sim.reset if args.start == "floor" else sim.reset_hanging), CLIMBER
    else:
        from microban_sim import MicrobanSim
        sim = MicrobanSim(args.variant)
        start, variant = sim.reset, args.variant

    moves = all_moves(args.moves)
    # the viewer's keys: the moves this robot runs (a move of your own has none: the dashboard starts it)
    keys = {k: n for k, n in MOVE_KEYS.items() if n in moves and variant in moves[n].variants}
    input_source = MuJoCoInputSource(move_keys=keys)
    controller = SimController(sim, start, key_callback=input_source.key_callback, reset_source=input_source,
                               viewer=not args.no_viewer)
    if args.no_viewer:
        print("No viewer: the dashboard shows and drives it (make dashboard HOST=127.0.0.1); Ctrl+C quits")
    input_source.set_viewer_opt(controller.viewer_opt)

    scheduler = Scheduler(
        frequency_hz=args.hz,
        controller=controller,
        input_source=input_source,
        moves=moves,
        telemetry=Telemetry(controller),            # the dashboard works on the simulation too (make dashboard HOST=127.0.0.1)
        variant=variant,                            # the moves made for this version (their variants)
    )
    scheduler.run()
    controller.close()
    os._exit(0)            # Ctrl+C or q: quit at once (MuJoCo's viewer thread would keep the process alive)


if __name__ == "__main__":
    main()
