Rhoban/microban/(commit log)

2026-05-08 Adding STEP and STL repositories
    [foot.step, foot.stl]
2026-05-22 50Hz scheduler + proper interruption
2026-05-22 Neutral pose and motor signs
2026-05-22 Battery voltage warning + Inpu system
2026-05-27 Placo viewer + working squat motion
    [robot.xml]
2026-05-27 Replacing battery checks by motor voltage measure
2026-05-27 Preloading for PlaCo based moves + serial error management
    [main.py, scheduler.py]
2026-05-28 Functionnal IMU reading (with errors)
    [constants.py, controller.py, gyro.py, imu.py, mujoco_controller.py, mujoco_input.py, observer.py]
2026-05-28 Add URDF for on-board FK (reduced loading)
    [ankle_dbl_block__configuration_right.scad, ankle_dbl_block__configuration_right.stl, arm_bearing_support__configuration_right.stl, battery.stl, bts2_m2_6x8.stl, chest__configuration_right.stl, dc15_a01_horn_idle2_dummy.stl, dc15_a01_idle_cap_dummy.stl]
2026-06-08 Updating motor parameters
    [robot.xml]
2026-06-09 Fixing velocity unit
2026-06-15 Revise README for clarity and additional details
    Updated the README to enhance project description, add images, and clarify assembly instructions.
2026-06-15 Changing BOM name
2026-06-15 BOM update
2026-06-15 First complete BOM
2026-06-17 Update BOM with new images and links
2026-06-17 Revise README.md for clarity and updates
    Updated project description, components overview, and CAD files section in README.md.
2026-06-17 Updating printing guide
2026-06-18 Fix formatting issues in printing documentation
2026-06-18 Adding onshape assembly ref to printing guide
2026-06-18 Assembly guide
2026-06-18 WIP assembly guide
2026-06-18 Enhance cable routing documentation with splitter details
    Expanded the cable routing section to include details on cable lengths and instructions for creating 1-to-2 and 1-to-3 splitter cables.
2026-06-19 Enhance cable crimping instructions in assembly.md
    Added detailed instructions for crimping cables, including steps for cutting, stripping, and crimping terminals. Included links to images and a video for reference.
2026-06-19 Enhance cable assembly instructions with warnings and videos
    Added warnings and detailed instructions for crimping and assembling cables, including references to instructional videos.
2026-06-19 Update assembly.md with torso assembly section
    Added torso assembly instructions and references.
2026-06-19 Revise assembly sections for electronics and battery module
    Updated assembly instructions to include electronics and battery module assembly.
2026-06-21 Voltage logs
2026-06-21 Torque sum in sim
2026-06-25 Soft current safety shutdown
2026-06-25 Assembly guide update
2026-07-04 Fixing no Wi-Fi states in headless mode
    [gamepad_daemon.py]
2026-07-04 Switching to BAM 1.0 release
2026-07-21 Adding board spacer files
    [board_spacer.step, board_spacer.stl]
2026-07-21 Adding board spacer to printing guide
2026-09-07 Update BOM with warning about R33 resistor
    Added a warning note about the missing R33 resistor when ordering PCBs from JLCPCB.
2026-10-27 Microban v2: shoulder pitch MOTOR_OFFSET (horns a quarter turn from the model's zero)
    Claude-Session: https://claude.ai/code/session_018d9UckeD9X4H8Nj272GbiR
2026-10-27 Fast Sync Read, and position + velocity + current in one sync read (registers 126-135)
    RobotController.sync_read_state reads the three blocks the XL330 keeps side by side in a single bus transaction,
    with Fast Sync Read on (one status packet for every motor). Observer uses it when the controller has it (the
    simulation controllers keep the separate reads). Radxa ROCK3 C, 18 motors at 1 Mbps: 4.0 ms per tick instead of
    7.8 ms for position + velocity alone, current included. Same values as the separate reads (position within 1 tick,
    velocity within 2 raw units, current equal). The overcurrent safety still uses the proxy unless observe_current.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
2026-10-27 Radxa ROCK 3C: motors on /dev/ttyS2 and the IMU on i2c-3, chosen from the device tree model
    constants.BOARD_MODEL / IS_RADXA from /proc/device-tree/model; MOTOR_SERIAL_PORT and IMU_I2C_BUS follow it (the
    Raspberry Pi keeps /dev/ttyAMA0 and i2c-1). RobotController and voltage.py use MOTOR_SERIAL_PORT. Checked on the
    Radxa: IMU valid at 200 Hz, motor voltages read, sync_read_state as before.
    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
2026-10-27 Dependencies from pyproject.toml only (no uv.lock): make setup runs uv sync; Python pinned to 3.12
    requires-python >=3.12,<3.13 so that uv picks 3.12 on the robot (it took 3.15, which onnxruntime has no wheel for).
    Checked on the Radxa ROCK 3C: make setup HOST=radxa installs everything on Python 3.12.
    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
2026-10-27 Live dashboard link: telemetry once per tick (only while a PC listens), motor health at 1 Hz, reboot / torque commands
    src/telemetry.py streams what the loop read and sent (humanoid-dashboard link, UDP 7350) and runs the page's commands
    between ticks; RobotController: sync_read_health, reboot (waits for the motor, writes its kp back, torque stays off),
    write_torque_enable; Observer keeps the measured currents (measured_currents) without changing the overcurrent
    safety's source; make dashboard HOST=... on the PC; docs/dashboard.md. Checked on the Radxa: 50 Hz, 19 motors, reboot
    of the head motor in 0.33 s.
    Claude-Session: https://claude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
2026-10-27 Microban v2 model (Radxa): walking (default) and climbing-mode forearms / feet, CAD masses, IMU mount
    src/model/mjcf/robot.xml (scene.xml) and robot_climb.xml (scene_climb.xml), urdf/robot.urdf and robot_climb.urdf
    (kinematics, from the MJCFs): the same robot except the forearms and the feet (walking ones from the v1 model with their
    collision primitives; ball hands and climbing feet). Servos sticking out as boxes, the trunk as four hulls, other parts
    as convex pieces. Shoulder pitch zero turned to the code's convention (arm down; MOTOR_OFFSET on the robot). Same
    joints, torque actuators (xl330) and IMU sensors as v1; IMU_MOUNT_QUAT follows the new imu site. The sim group pins
    BAM to the com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
2026-10-27 Live dashboard on the PC: src/humanoid_dashboard (robot-independent), make dashboard HOST=... [MODEL=...]
    The robot side is src/humanoid_dashboard/link.py (standard library); the PC side (MuJoCo kinematics, three.js 3D view,
    motors, plots, events, reboot / torque commands, recording) runs with the dashboard dependency group. A fake robot
    tries it without hardware. The web files are not synced to the robot.
    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
2026-10-27 Motor setup tools: auto / setup / check / scan, click-to-identify page, same-ID split (1 Mbps by default)
    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
2026-10-27 Simulation on the latest BAM (Rhoban/bam e9a619d): vin_drop_resistance, max_current on the actuator, reset()
    BAM replaced the voltage drop ratio by the battery + wires resistance: BAM_VIN_DROP_RESISTANCE = 0.073 ohm is the same
    drop as the former vin_drop_gain 0.2 (0.2 * kt). The firmware current limit is now an actuator setting
    (actuator.max_current), and MujocoController.reset() no longer sets the targets: _reset_bam() holds every motor where
    it is. PyPI's 1.0.2 lacks MujocoController.reset, hence the pinned commit. Same behaviour in the simulation (stands,
    steps in place).
    Claude-Session: https://claude.ai/code/session_018d9UckeD9X4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
2026-10-27 Simulation supply: bench power supply at 8.1 V (the robot has no battery for now), wires-only voltage drop
    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
2026-10-27 Simulation supply: 8.4 V bench supply, 5 m of 16 AWG and the robot's wiring (~0.25 ohm, estimated from 8.1-8.2 V at rest)
    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
2026-10-27 Overcurrent safety off while there is no BMS (bench power supply): OVERCURRENT_CUTOFF_A None
    The safety cut the torque before a current spike could trip the BMS; it comes back by setting the threshold again
    (15 A). The estimated total current is still computed (dashboard field safety_est_A).
    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
2026-10-27 Dashboard: a motor in error lights its servo, not the part it moves
    Each joint's servo is the visual mesh named like --motor-mesh (xl330 by default) whose centre lies on the joint's axis;
    without one, the moving part lights as before. Clicking a servo selects its motor.
    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
2026-10-27 Dashboard: torque off on every motor (emergency button), zero pose (every motor to its zero in 2 s, held) and release
    Telemetry.apply() lets the dashboard's targets replace the moves' while a zero pose runs or is held (the scheduler
    calls it before commanding the motors); torque_all off also ends it. The motors' zero is the shoulders' arm forward
    (-MOTOR_OFFSET in the code's convention). The page shows the robot's whole-robot commands in its header. sim_main
    streams to the dashboard too.
    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
2026-10-27 Torque off by default, as on Rhoban's robots: a launched move powers the robot (neutral pose first), em and init
    The scheduler starts with the torque off; a launched move first ramps to the neutral pose (goal = present position,
    then torque on: no jump), then runs; when no move runs, the torque goes off. em (dashboard) stops the moves and cuts
    the torque; init stops the moves and brings every motor to its zero, held. After either, a move already asked by the
    keyboard or gamepad stays off until it is launched again. main.py no longer powers the robot at start. The
    simulation now cuts the motor torque for real (sync_write_torque_enable). The dashboard's Release button is gone.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
2026-10-27 Model from the microban_model package; every joint's zero is its motor's zero (no MOTOR_OFFSET)
    src/model goes to Rhoban/microban_model (a dependency, meshes in Git LFS), shared with the robot's simulators. The
    simulation builds its scene around it (sim/scene.py, --climb), the squat and the viewer read it from the package, the
    dashboard too (make dashboard [CLIMB=1]). Angles are now the motors' everywhere: the shoulder pitch holds the arm
    forward at 0 (NEUTRAL_POSE: 100 deg for the arms along the body), init goes to 0, and the walk turns its v1 policy's
    default pose by a quarter turn on the shoulders (its inputs and outputs unchanged). Checked in simulation: stands,
    powers up, steps in place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
2026-10-27 Your own controller as a move: the same Controller file as in the climbing simulator (make run / make sim CONTROLLER=...)
    moves/controller.py builds the simulator's observation from what the robot measures (joints in microban_model.JOINTS
    order, IMU in the trunk frame, accel in m/s^2, currents) and applies the 19 targets; kp_fw while it runs. Started with
    [c] (gamepad B); its power-up keeps the pose the robot is in (Move.power_up = "current"). The simulation's pseudo
    accelerometer now reads +1 g along the axis that points up, as a real one (its x / y had the opposite sign of z).
    docs/controller.md.
    Claude-Session: https://claude.ai/cod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
2026-10-27 Scheduler: only a registered move powers the robot (a move's own switch in active_moves does not)
    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
2026-10-27 Dashboard: the moves and switches are listed and can be started / stopped from the page; docs/moves.md
    The scheduler gives its moves (with their description) and switches to the telemetry, which lists them; the page's
    Moves card starts and stops them (a move asks for a confirmation) as their keys would: what the dashboard asks is
    added to the keyboard / gamepad's, em and init clear it, and moves see the switches in user_input.active_moves as
    usual. Move.description and Move.power_up documented in the base class. docs/moves.md: how to write a move, register
    it, its life (torque, em / init, switches); docs/usage.md updated (torque off until a move runs).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
2026-10-27 Dashboard: follows a restarted robot (schema CRC from each schema received), narrow-window layout (one scrolling column)
    The PC side dropped the frames for good after the robot restarted with the same fields (it waited for a changed
    schema). It now takes the CRC of every schema it receives, as the robot computes it. Below 1100 px the page is one
    scrolling column: 3D, plots and events, moves, every motor (the plots overlapped the Moves card).
    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
2026-10-27 Dashboard: readable header (the robot describes its one-value fields: label and unit, or a flag's texts), frames at 30 Hz at most
    The overcurrent safety's estimate (safety_est_A) is no longer sent (the safety is off without a BMS; the plotted
    current is the measured one). Link(max_hz=30) sends one frame every few ticks (25 Hz for the 50 Hz loop).
    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
2026-10-27 Dashboard link: every tick again (50 Hz on Microban); max_hz stays as an option, off by default
    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
2026-10-27 dashboard: keep a button's confirmation shown when its list is redrawn
    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
2026-10-27 dashboard: replay a recording (speed, frame by frame, back and forth, slider)
    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
2026-10-27 dashboard: choose the robot in the page, save robots under a name; push to the page at 50 Hz
    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
2026-10-28 docs: motor tools' dependency (rustypot 1.13.1) and how to install it
    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
2026-10-28 motor tools: find the U2D2's port by itself (Linux, macOS), clear message when there is none
    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
2026-10-28 flash_card: print the image once
    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
2026-10-28 dashboard: Deploy code button (runs make deploy for the robot shown, output in the events); no-cache page
    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
2026-10-28 safety and correctness fixes from the code review
    - gamepad: B is the stop button again (the user's controller moves to Y)
    - SIGTERM (systemctl stop/restart: make deploy, Deploy) runs the cleanup: torque off
    - a gamepad that drops keeps its moves at zero velocity (no fall), finds them on reconnect
    - dashboard: only its own page may use it (Host and Origin checked); recordings saved
    when the robot or its fields change; a saved robot needs a name and a host
    - make sync keeps the PC's recordings, move_options.json and CONTROLLER copy
    - em / init reset the moves' transitions (Move.reset); the walk starts with a clean memory,
    holds its joints when fallen or without IMU reading
    - the current e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
2026-10-28 docs in line with the code (review): gamepad Y / B, HOST=radxa@ for the SD image robots, the full make table, deploy and the dashboard's server, motor tools on the robot, README for v2
    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
2026-10-28 docs/dashboard.md: screenshots (annotated overview, moves, motor error, robot picker, replay) and a diagram
    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
2026-10-28 walk: a speed slider and the dashboard's arrows (forward / backward, turn)
    While arrows are held in the keyboard zone, they give the velocity at the slider's fraction of the maximum
    (scale_velocity, as the gamepad); otherwise the gamepad / keyboard velocity as before.
    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
2026-10-28 dashboard: a move's sliders and keyboard zone only while it runs; type a slider's value
    The sliders start at their start value; the number at a slider's end can be edited (Enter, clamped to min / max).
    moves.md says when to use a variable (a setting) or a slider (driving).
    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
2026-10-28 make sim WALL=N2: the robot's program on the hackathon's climbing wall (simulator cloned next to this folder)
    src/sim/wall_controller.py gives the scheduler what the real robot gives (joints, currents, IMU with the robot's
    sensor delays) from ClimbingSim (rock-climbing-robots/simulator, used editable from ../simulator: a change made
    there applies at once), and sends the targets, the gain and the torque to it. The robot starts hanging on the
    start holds (START=floor: standing), held until the torque first goes on; the version is climber. docs/simulation.md.
    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
2026-10-28 docs: the wall simulation instead of --climb in moves.md, controller.py's gamepad button (Y), line wraps
    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
2026-10-28 make sim on Rhoban's robot simulator (microban_sim): one simulation for the floor and the wall
    src/sim/sim_controller.py gives the robot's program what the real robot gives (joints, currents, the IMU in its
    chip's frame, with the robot's delays) from a microban_sim.MicrobanSim: the robot on the floor (VARIANT=classic or
    climber) or the hackathon's ClimbingSim (WALL=). It replaces MuJoCoController, its own BAM setup and scene, and
    the wall controller. microban_sim is used from ../microban_sim until it is published. Also: RobotController's
    single-motor reads take rustypot's list (they raised).
    Claude-Session: https://claude.ai/code/sessi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
2026-10-29 make discover-robots: the robots on the network (mDNS names), whether their program runs, their version and torque
    tools/discover_robots.py browses the SSH services named microban-* (zeroconf, in the dashboard group) and sends the
    dashboard's hello to the whole network (UDP 7350): a robot whose program runs answers with its version; the robot
    now also says its host name in the link's meta.
    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
2026-10-29 The moves' print() in the dashboard's events (move: text), and in the terminal / log as before
    src/move_output.py: the scheduler runs each call of a move (on_start, step, on_stop, on_key, on_option) with its
    stdout captured; the text goes to the terminal (raw-mode line ends) and to the dashboard's events, at most 10 lines
    a second per move, the others counted once a second. A Controller's prints come through its move.
    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
2026-10-29 One kind of move: a class with step(obs) -> targets, the same file in the simulator and on the robot
    No base class: start(obs), step(obs) returning 19 angles or {joint: angle} (None: over by itself),
    stopping(obs) for a smooth stop; description, variants, start_pose, kp, options, sliders, keys as
    class attributes; options, slider, pressed, velocity set by the program. head, look, squat and walk
    rewritten this way (walk's policy inputs and outputs unchanged, checked tick by tick against the old
    code). The scheduler runs them through moves.move.Runner: joints no move drives keep their last
    target, the servos' gain follows the running moves' kp, a move's error stops that move only (its line
    in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
2026-10-29 Moves: an error in on_key / on_option stops that move only; a move over by itself stays off until asked anew
    - on_key / on_option errors caught (on_option of a move that is not running: reported only); saved options
    set before on_option at start, any error there reported, the robot starts anyway
    - _ended only when a running move ends by itself or fails; a key toggled again during a smooth stop
    restarts it after; a dashboard Start asks anew; no torque on/off loop for a move toggled on that ended
    - on_key sees the keys held now; options / sliders / keys set by a move's __init__ are kept
    - names: IKSquatMove -> ik_squat, as microban_sim's load_moves; a move imports its own files by name
    - m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
2026-10-29 Review fixes: make sim's arrows and currents, shared move keys, gamepad B in service mode, docs in line
    - make sim: left arrow turns left (+vtheta) as on the robot; SimController.sync_read_state gives the motor
    currents (obs["current"], the dashboard's current column); keys typed in the viewer, no gamepad (docs)
    - MOVE_KEYS / GAMEPAD_BUTTON_MOVES in constants.py, used by make run, make sim and make viewer
    - a MOVES= move named as one of src/moves/ replaces it, said in the events
    - robot service: gamepad B stops the gamepad's moves instead of ending the program (systemd would not
    restart it); headless START skipped while the service runs (docs); power-off message: both triggers
    - docs: em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
2026-10-29 Moves: self.robot, the servos one by one (set_torque, set_kp per joint) and the raw measurements
    For the moves that need more than obs and targets (our climbing's probes: a limb limp, its gain).
    A joint turned back on is held where it is after the tick's targets (no jump); when the move
    stops (Stop, over, error, em / init) its limp joints get their torque back and the gain the
    robot's. microban_sim's run_move gives the same methods (one gain for every joint there).
    Tested in make sim and on the robot (left elbow limp with another move running, back on at stop).
    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
2026-10-29 Review fixes: per-joint gains kept (set_kp over the moves' kp, not reset by another move), self.robot reserved, gamepad daemon's B stops the program again
    - the scheduler keeps every joint's gain: the running moves' kp, then their set_kp (written after the tick, only
    what changes); a move stopping takes only its own gains away
    - kp checked (0-1000), a move's own self.robot refused with a clear message
    - make sim: the gain most joints have (per-joint gains: the robot's only, said once)
    - gamepad_daemon starts main.py with MICROBAN_INPUT=gamepad: B ends the session as documented
    Claude-Session: https://claude.ai/code/session_018d9UckeD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
2026-10-29 Student dry run fixes: Ctrl+C quits make sim, its keys only for this robot's moves, torque sum twice a second, dashboard says it installs; README: where to start for a hackathon (git-lfs, make, uv, W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
    - make sim: no --variant shown with WALL; PYTHON=mjpython on macOS; an ImportError of the simulator says what and
    how to update microban_sim (uv sync --group sim --upgrade-package microban-sim)
    - make dashboard: MODELS computed in the recipe, after a message (the first run installs for a minute)
    - docs/simulation.md: own moves are started from the dashboard (or MOVE_KEYS), q or Ctrl+C quits
    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
2026-10-29 walk: a v1 policy's gyro in v1's IMU frame (y and z were flipped on v2), its shoulders' quarter turn only for v1 policies; a policy per robot version (agents/walk_climber.onnx)
    The v1 policy (trained on Microban v1, IMU site 0.5 -0.5 -0.5 0.5) got the gyro in v2's IMU frame: rotated 180 deg
    about x. In make sim the walk now stays up and walks (2.15 m in 4 s at full speed; it fell within 4 s before).
    The policy's version is read from its metadata (default shoulder pitch 0: v1, pi/2: the v2 model). self.robot.variant
    gives a move the robot's version. To check on a classic robot before trusting it.
    Claude-Session: https://claude.ai/code/s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
2026-10-29 Student check 2: self.robot.variant in the docs, the wave example on the wall, classic-only moves said when found, print limit message for make sim, key list aligned
    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
2026-10-29 Robot service: a loop stopped by itself (motors not answering, overcurrent) exits 1, so the service tries again every 3 s and comes up once the motors have power; first boot: partx -u before resize2f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
    Claude-Session: https://claude.ai/code/session_012JUXDRksQB7T5du2YqJQ9D
2026-10-29 README, docs/model.md: the climbing robot's CAD (Onshape document)
    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
2026-10-30 motor_ids: status return level 2 on every motor found (after the robot's program, which sets 1, the tool's writes timed out: 'did not move')
    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
2026-10-31 Dashboard: four robots at once (/multi, chosen among the saved ones) and a motor-health option
    The server keeps a hub per robot (the page's ?h=, 0 by default): /multi shows four compact pages side by side, menus
    on top connect them to the saved robots; recordings are named after the robot's address. The page's motor health box
    off: the hello says health false, the robot (Link.wants_health) skips its once-a-second health read while every
    listening PC has it off, the page hides the temperature column (the torque on/off stays shown).
    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
2026-10-31 Dashboard /multi: one robot menu per pane (its bar), one motor-health box for the four, compact panes laid out 3D | moves and motors
    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
2026-10-31 Dashboard: robots chosen in /multi's top bar (name and address under each 3D view), back to one robot, the robot's CPU load in the header, Shut down button
    The robot sends its computer's CPU load once a second (/proc/stat, field cpu, shown as cpu %); the poweroff command
    (real robot only, a second click confirms) turns the torque off and runs sudo shutdown.
    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
2026-10-31 Telemetry: the torque state kept by the program, also with the motor health off
    A move's self.robot.set_torque(False) reports its joints (Robot.on_torque, set by the scheduler), the scheduler reports
    the joints it powers again (a move's set_torque(True), given back when it stops), as it already did for em / init and
    the page's torque / reboot commands. With the motor health off nothing is read: the page showed a motor powered again
    as torque off. Only a motor that shuts itself down on an error goes unseen then.
    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
2026-11-01 Dashboard /multi panes: no horizontal scroll bar (moves wrap and shrink, the motors' table fits its column)
    Claude-Session: https://claude.ai/code/session_012JUXDSXsLWomYtS71cj5S1
2026-11-01 Dashboard: motors table header Curr. A (fits a /multi pane)
    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
2026-11-01 Dashboard /multi panes: motors column a bit wider (3D a bit narrower), narrow current column, the state and its buttons shown whole
    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
2026-11-01 Dashboard /multi panes: short joint names (R shoulder pitch), the full name on hover
    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
