Rhoban/microban/(notices)

Notices in the files:
README.md:
License: GPL v3
License: CC BY-NC-SA 4.0
